SJFOM/KiCad/Projects/StepUp/pictures/Joystick_pinout.png

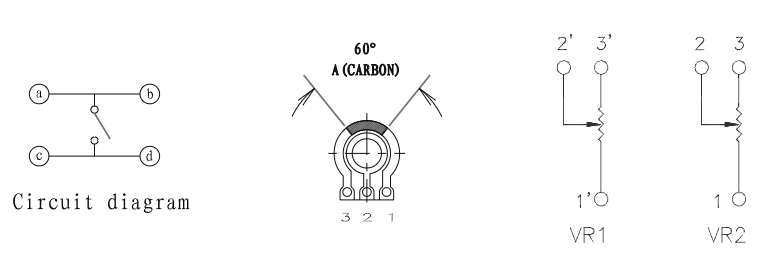
Projects/StepUp/pictures/Joystick_pinout.png
