SJFOM/KiCad/Projects/StepUp/pictures/pico_pinout.png

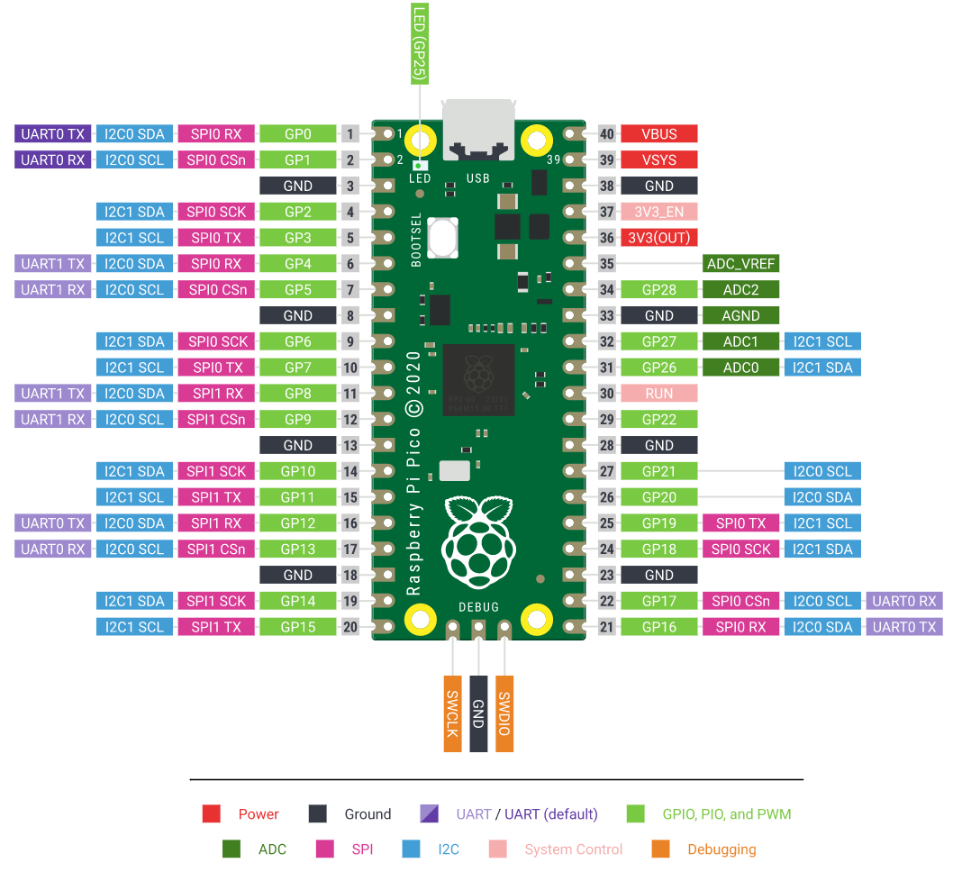
Projects/StepUp/pictures/pico_pinout.png
