SJFOM/KiCad/Projects/RP2040-example/RP2040_minimal_r2-BOM.xlsx

RP2040_minimal_r2 BOM
Item | Quantity | Reference | Part | Voltage | Current | Power | Material | Size | Tolerance | Manufacturer | Manuf. Part # | Description | Notes
1 | 3 | C1,C4,C17 | 10u | 16V |  |  | X5R | 0805_2012Metric | 10% | Murata | GRM21BR61C106KE15K | CAP CER 10UF 16V X5R 0805 | Or equivalent
2 | 2 | C2, C3 | 15p | 50V |  |  | C0G | 0402_1005Metric | 5% | Murata | GCM1555C1H150JA16D | CAP CER 15PF 50V C0G/NP0 0402 | Or equivalent
3 | 10 | C5, C6, C7, C9, C11, C12, C13, C14, C15, C16 | 100n | 25V |  |  | X7R | 0402_1005Metric | 10% | Murata | GRM155R71E104KE14J | CAP CER 0.1UF 25V X7R 0402 | Or equivalent
4 | 2 | C8, C10 | 1u | 10V |  |  | X6S | 0402_1005Metric | 10% | Murata | GRM155C81A105KA12D | CAP CER 1UF 10V X6S 0402 | Or equivalent
5 | 1 | J1 | USB_B_Micro |  |  |  |  |  |  | Amphenol | 10103594-0001LF | CONN RCPT USB2.0 MICRO B SMD R/A | Or equivalent
6 | 1 | J2 | 1x2 way header |  |  |  |  |  |  | Samtec | TSW-102-23-T-S | 2.54mm pin header 1x2 | Or equivalent
7 | 2 | J3, J4 | 2x18 way header |  |  |  |  |  |  | Samtec | TSW-118-23-T-D | 2.54mm pin header 2x18 | Or equivalent
8 | 2 | R1, R5 | 1k |  |  | 63mW |  | 0402_1005Metric | 1% | Yageo | RC0402FR-071KP | RES SMD 1K OHM 1% 1/16W 0402 | Or equivalent
9 | 1 | R2 | DNF |  |  |  |  | 0402_1005Metric |  |  |  |  | Do Not Fit
10 | 2 | R3, R4 | 27.4 |  |  | 63mW |  | 0402_1005Metric | 1% | Yageo | RC0402FR-0727R4L | RES SMD 27.4 OHM 1% 1/16W 0402 | Or equivalent
11 | 1 | U1 | NCP1117-3.3 |  |  |  |  | SOT-223-3 |  | ON Semiconductor | NCP1117ST33T3G | IC REG LINEAR 3.3V 1A SOT223
12 | 1 | U2 | W25Q128JVS |  |  |  |  | SOIC-8 |  | Winbond | W25Q128JVSIQ TR | IC FLASH 128M SPI 133MHZ 8SOIC
13 | 1 | U3 | RP2040 |  |  |  |  | QFN56 |  | Raspberry Pi | RP2040
14 | 1 | Y1 | ABM8-272-T3 |  |  |  |  | SMD_3225 |  | Abracon | ABM8-272-T3 | CRYSTAL 12.0000MHZ 3.2x2.5MM SMD
