SJFOM/KiCad/Projects/StepUp/StepUp_log_missing3Dmodels.txt

Can not find model defined with enviroment variable:
${KICAD8_3DMODEL_DIR}/Connector_USB.3dshapes/USB_C_Receptacle_GCT_USB4105-xx-A_16P_TopMnt_Horizontal.wrl
Can not find model defined with enviroment variable:
${KISYS3DMOD}/Package_DFN_QFN.3dshapes/QFN-56-1EP_7x7mm_P0.4mm_EP5.6x5.6mm.wrl
Can not find model defined with enviroment variable:
${KICAD8_3DMODEL_DIR}/Resistor_SMD.3dshapes/R_0603_1608Metric.wrl
Can not find model defined with enviroment variable:
${KICAD8_3DMODEL_DIR}/Resistor_SMD.3dshapes/R_0603_1608Metric.wrl
Can not find model defined with enviroment variable:
${KICAD8_3DMODEL_DIR}/Package_SON.3dshapes/WSON-6_1.5x1.5mm_P0.5mm.wrl
Can not find model defined with enviroment variable:
${KICAD8_3DMODEL_DIR}/Resistor_SMD.3dshapes/R_0603_1608Metric.wrl
Can not find model defined with enviroment variable:
${KICAD8_3DMODEL_DIR}/Resistor_SMD.3dshapes/R_0603_1608Metric.wrl
Can not find model defined with enviroment variable:
${KICAD8_3DMODEL_DIR}/Resistor_SMD.3dshapes/R_0603_1608Metric.wrl
Can not find model defined with enviroment variable:
${KICAD8_3DMODEL_DIR}/Resistor_SMD.3dshapes/R_0603_1608Metric.wrl
Can not find model defined with enviroment variable:
${KICAD8_3DMODEL_DIR}/Package_TO_SOT_SMD.3dshapes/SOT-223.wrl
Can not find model defined with enviroment variable:
${KICAD8_3DMODEL_DIR}/Diode_SMD.3dshapes/D_SOD-123F.wrl
Can not find model defined with enviroment variable:
${KICAD8_3DMODEL_DIR}/Resistor_SMD.3dshapes/R_0603_1608Metric.wrl
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
Can not find model defined with enviroment variable:
${KICAD8_3DMODEL_DIR}/Connector_PinHeader_2.54mm.3dshapes/PinHeader_1x05_P2.54mm_Vertical.wrl
Can not find model defined with enviroment variable:
${KICAD8_3DMODEL_DIR}/Connector_PinHeader_2.54mm.3dshapes/PinHeader_2x03_P2.54mm_Vertical.wrl
[('J1', '${KICAD8_3DMODEL_DIR}/Connector_USB.3dshapes/USB_C_Receptacle_GCT_USB4105-xx-A_16P_TopMnt_Horizontal.wrl'), ('U3', '${KISYS3DMOD}/Package_DFN_QFN.3dshapes/QFN-56-1EP_7x7mm_P0.4mm_EP5.6x5.6mm.wrl'), ('U7', 'C:\\Program Files\\KiCad\\9.0\\share\\kicad\\3dmodels\\Package_DFN_QFN.3dshapes\\Texa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
