SJFOM/KiCad/Projects/StepUp/Outputs/v1.0/Image renders/PCB_Render_BTM.png

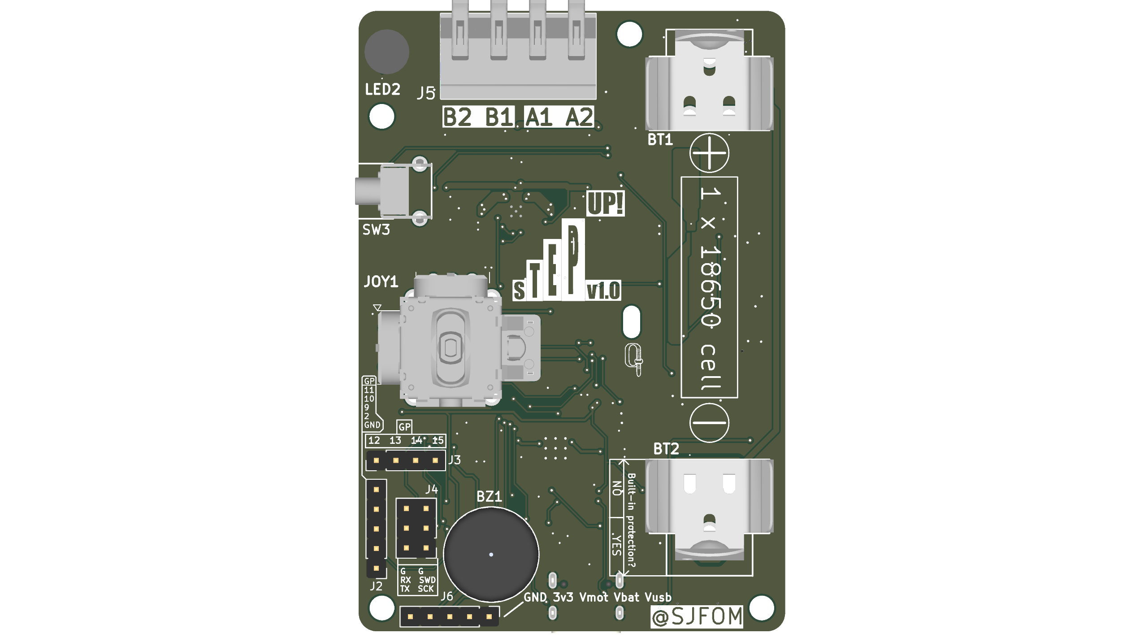
Projects/StepUp/Outputs/v1.0/Image renders/PCB_Render_BTM.png
