SJFOM/KiCad/Projects/StepUp/Outputs/v1.0/Image renders/PCB_Render_TOP.png

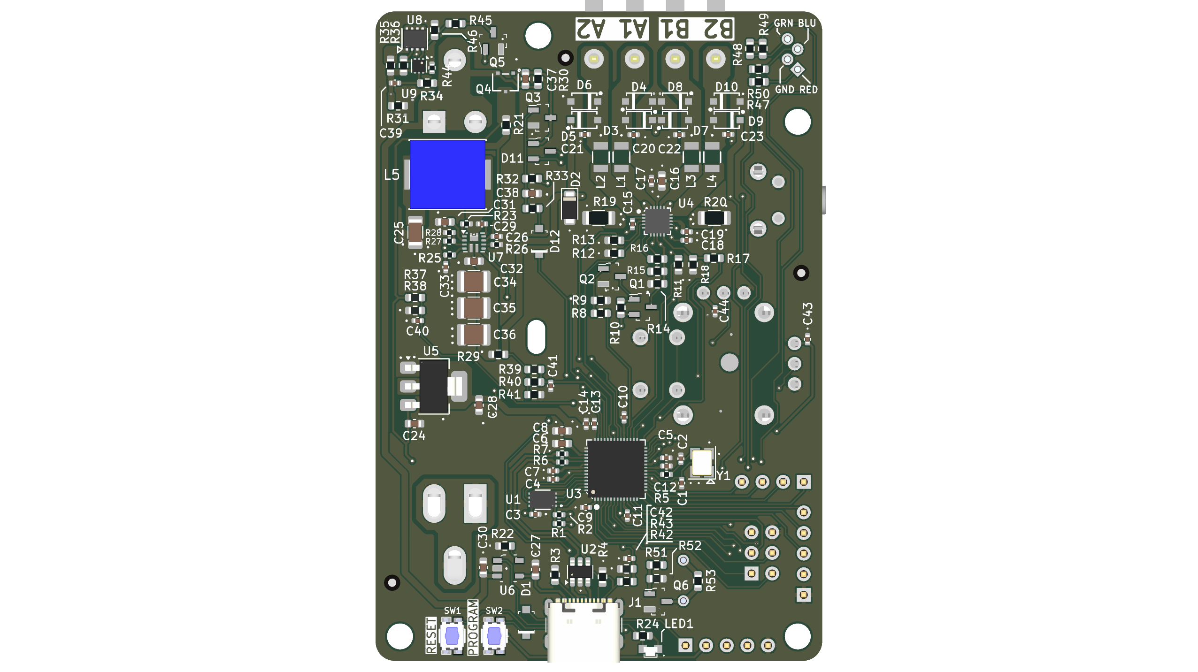
Projects/StepUp/Outputs/v1.0/Image renders/PCB_Render_TOP.png
