SJFOM/KiCad/Projects/StepUp/pictures/MCP73832_charge_ic_current.png

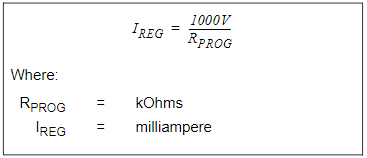
Projects/StepUp/pictures/MCP73832_charge_ic_current.png
