SJFOM/KiCad/Projects/StepUp/pictures/MIC2253_Vout_calc.png

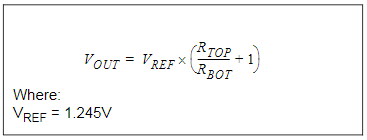
Projects/StepUp/pictures/MIC2253_Vout_calc.png
