SJFOM/KiCad/Projects/StepUp/pictures/MIC2253_Vovp_calc.png

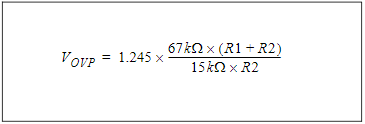
Projects/StepUp/pictures/MIC2253_Vovp_calc.png
