SJFOM/KiCad/Projects/StepUp/pictures/zip_tie_image.png

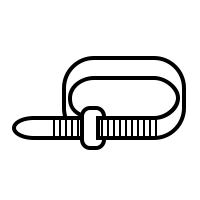
Projects/StepUp/pictures/zip_tie_image.png
