SJFOM/KiCad/Projects/StepUp/Schematic pdfs/StepUp_v1.0.pdf

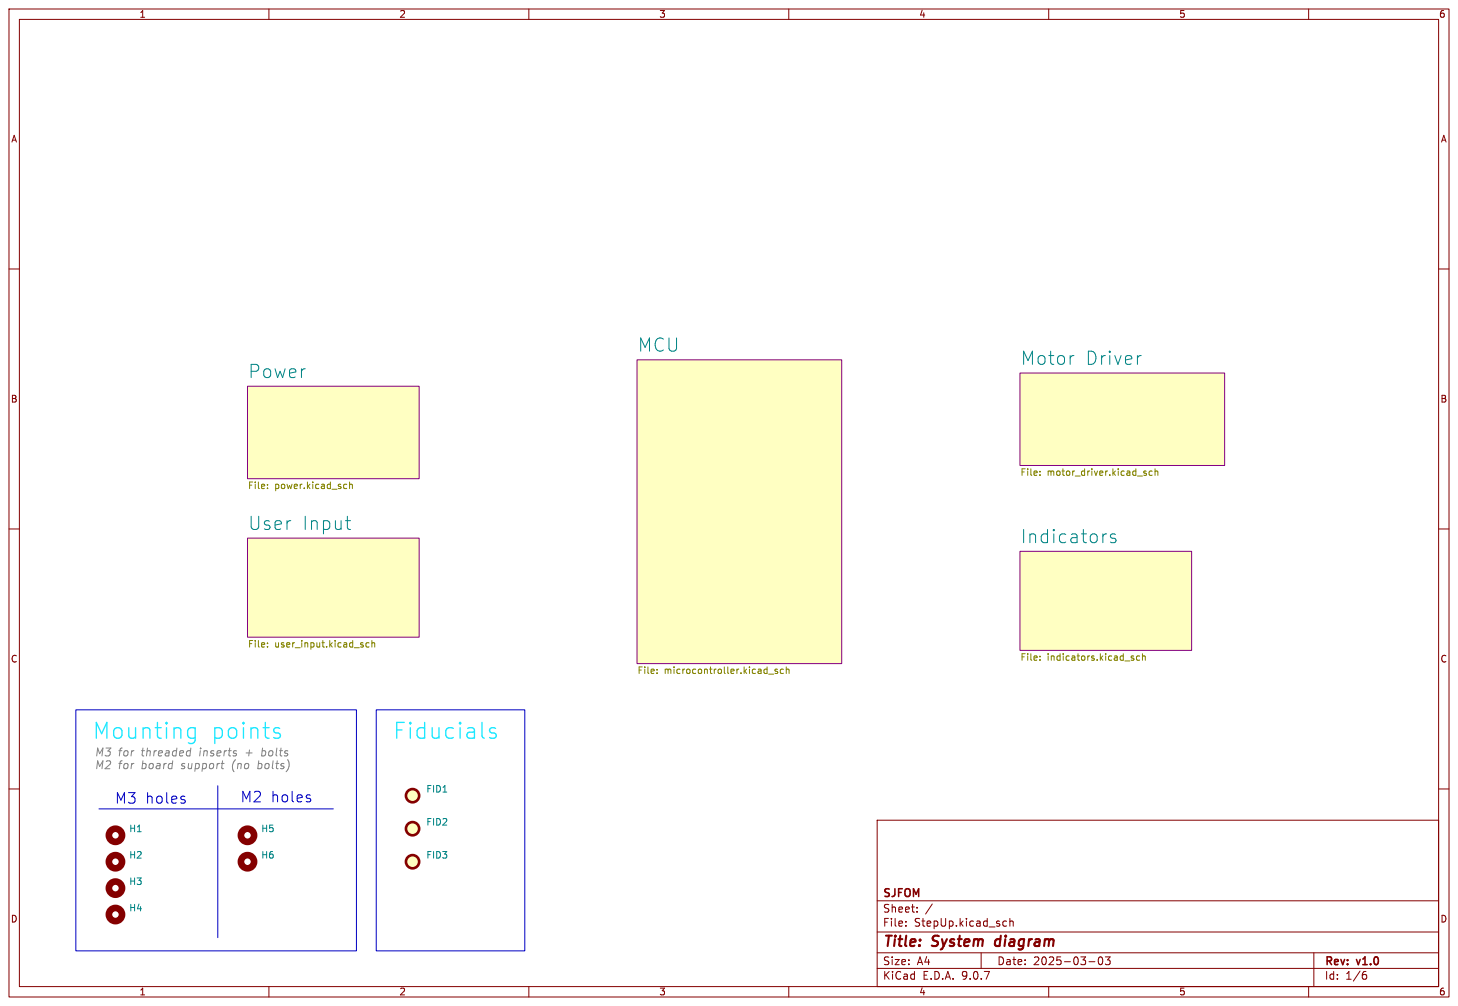
[picture p9: page 1]

File: StepUp.kicad_sch Sheet: / SJFOM Power

M3 for threaded inserts + bolts M2 for board support (no bolts)

Id: 1/6 Title: System diagram

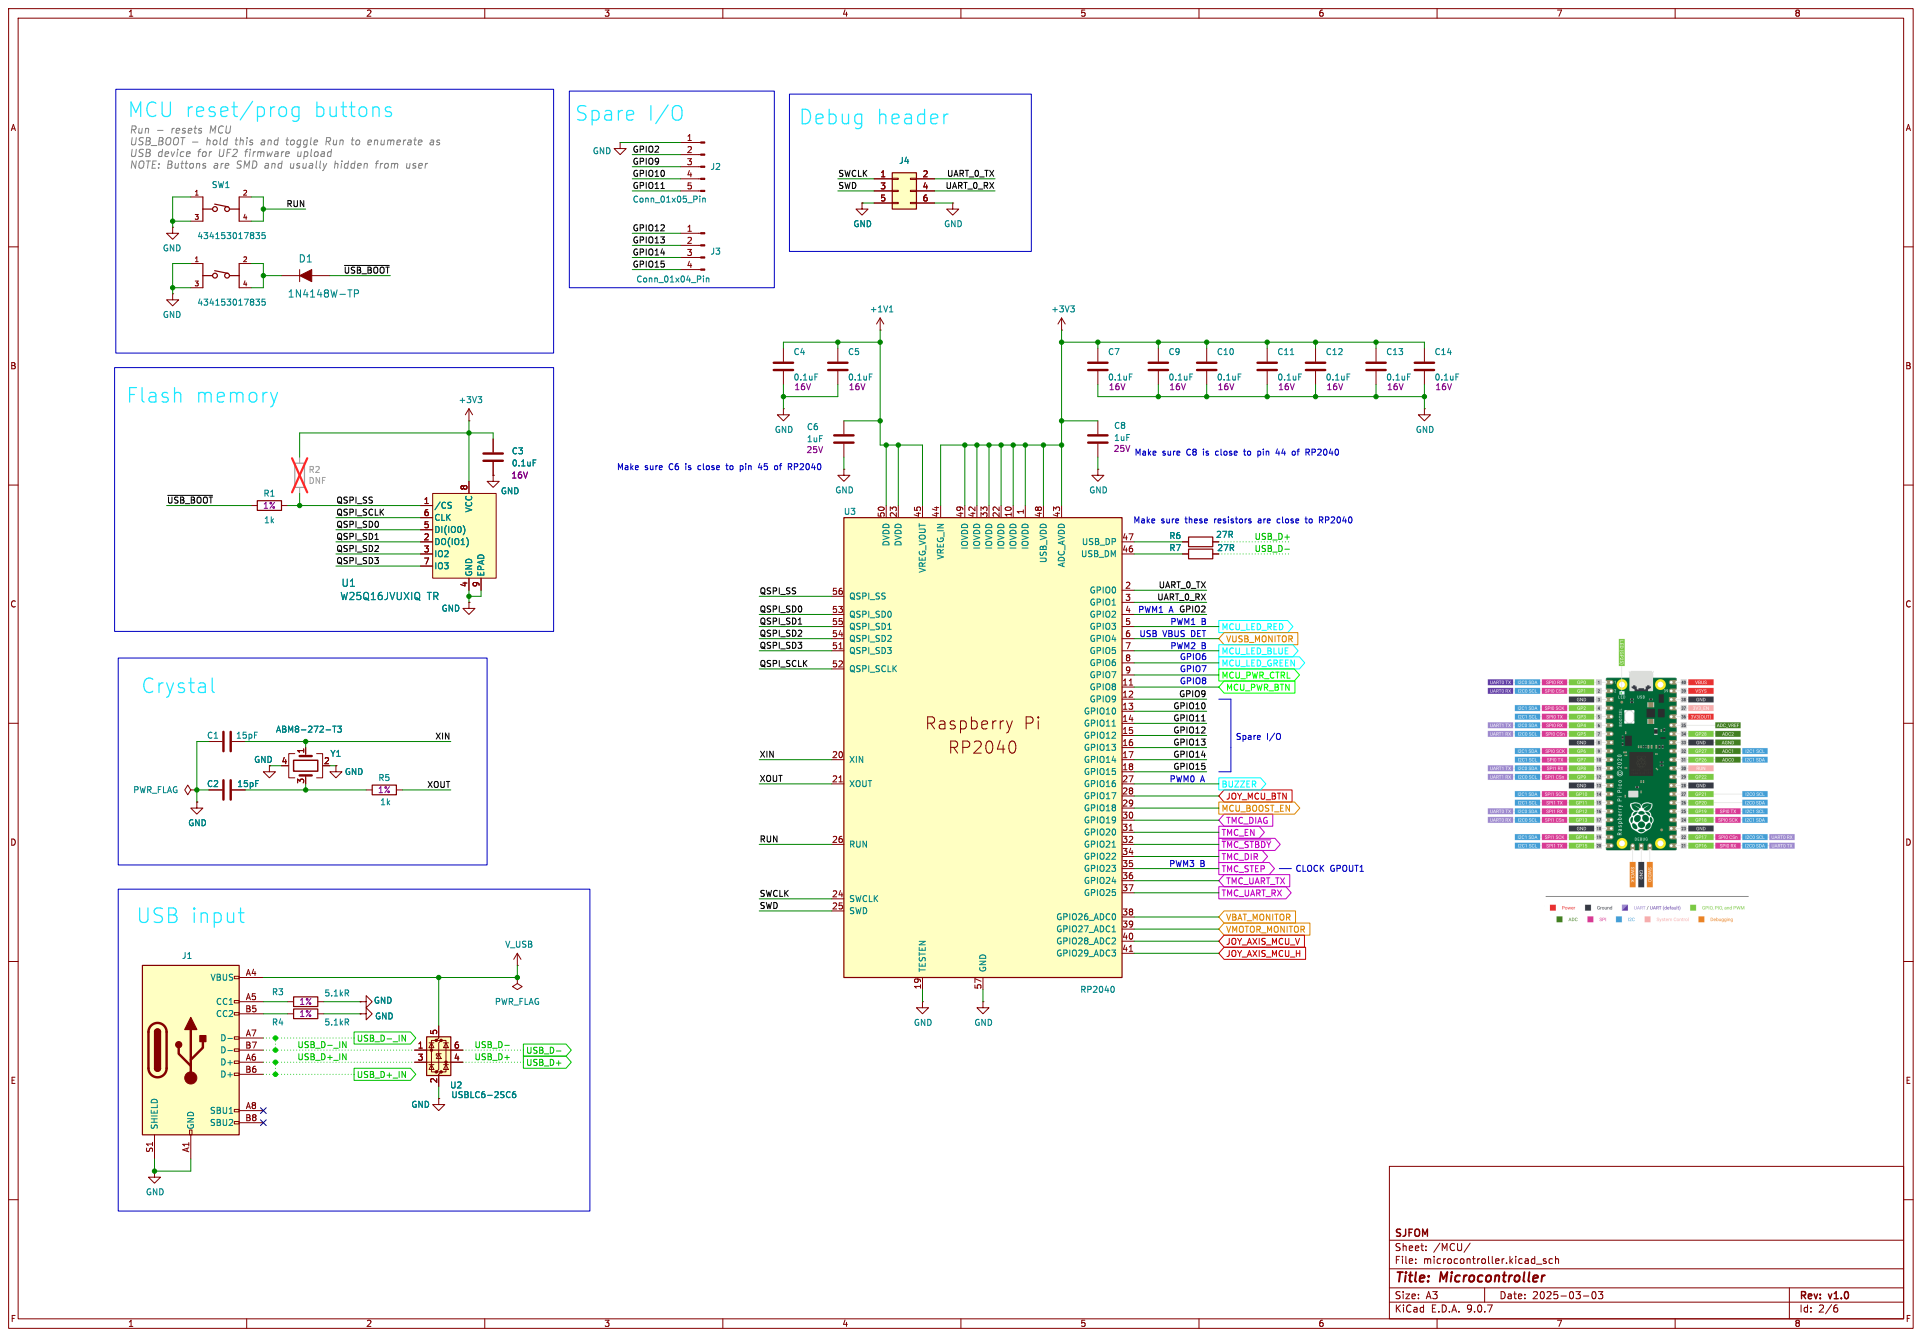
[picture p10: page 2]

USB VBUS DET GPIO6 Debug header

Make sure C8 is close to pin 44 of RP2040 Run - resets MCU

Id: 2/6 Title: Microcontroller File: microcontroller.kicad_sch Sheet: /MCU/ SJFOM

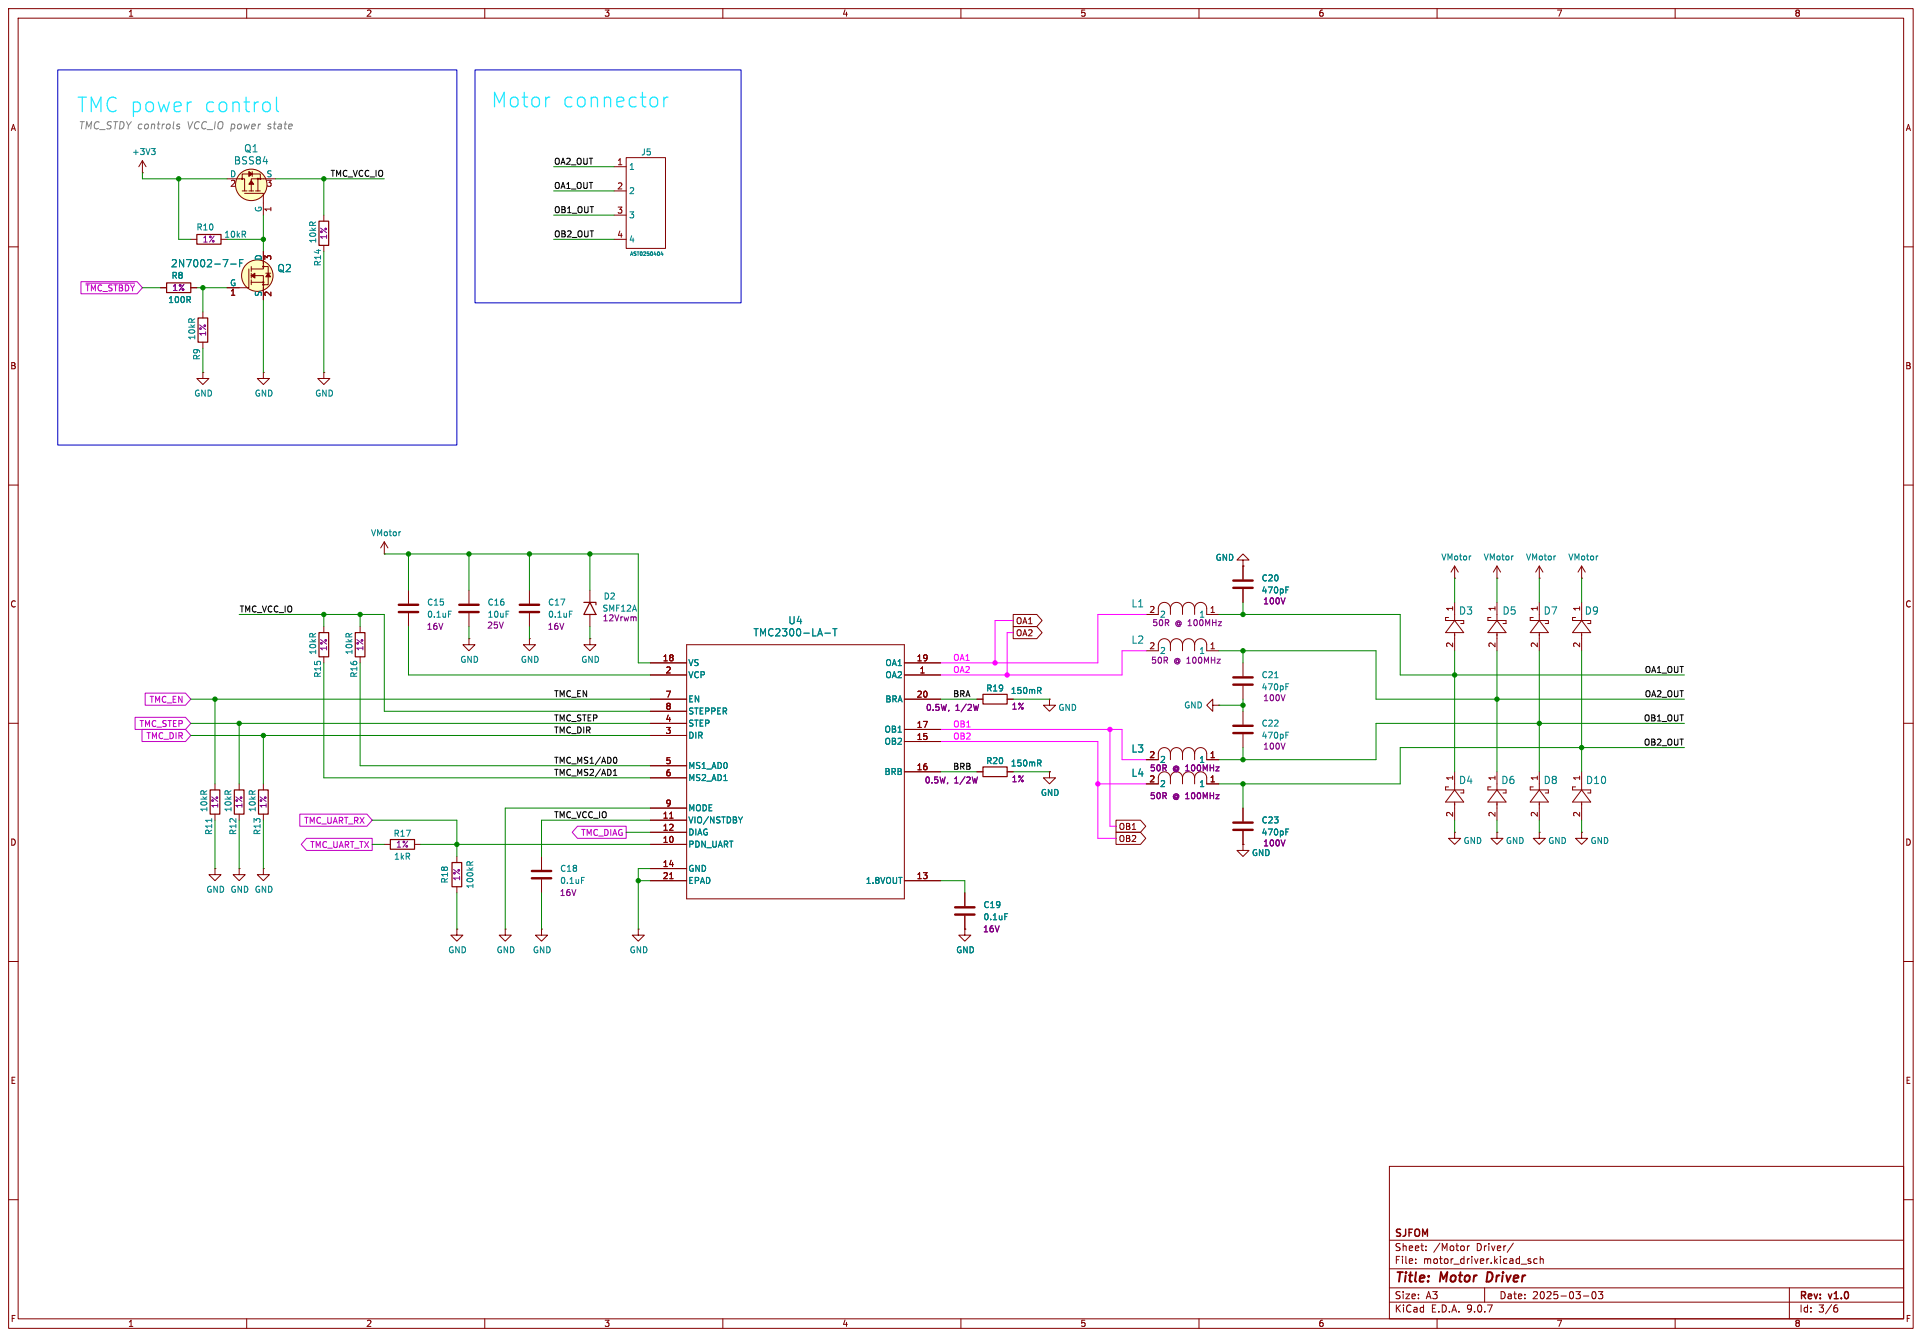
[picture p11: page 3]

2 1D8 GND GND GND GND GND

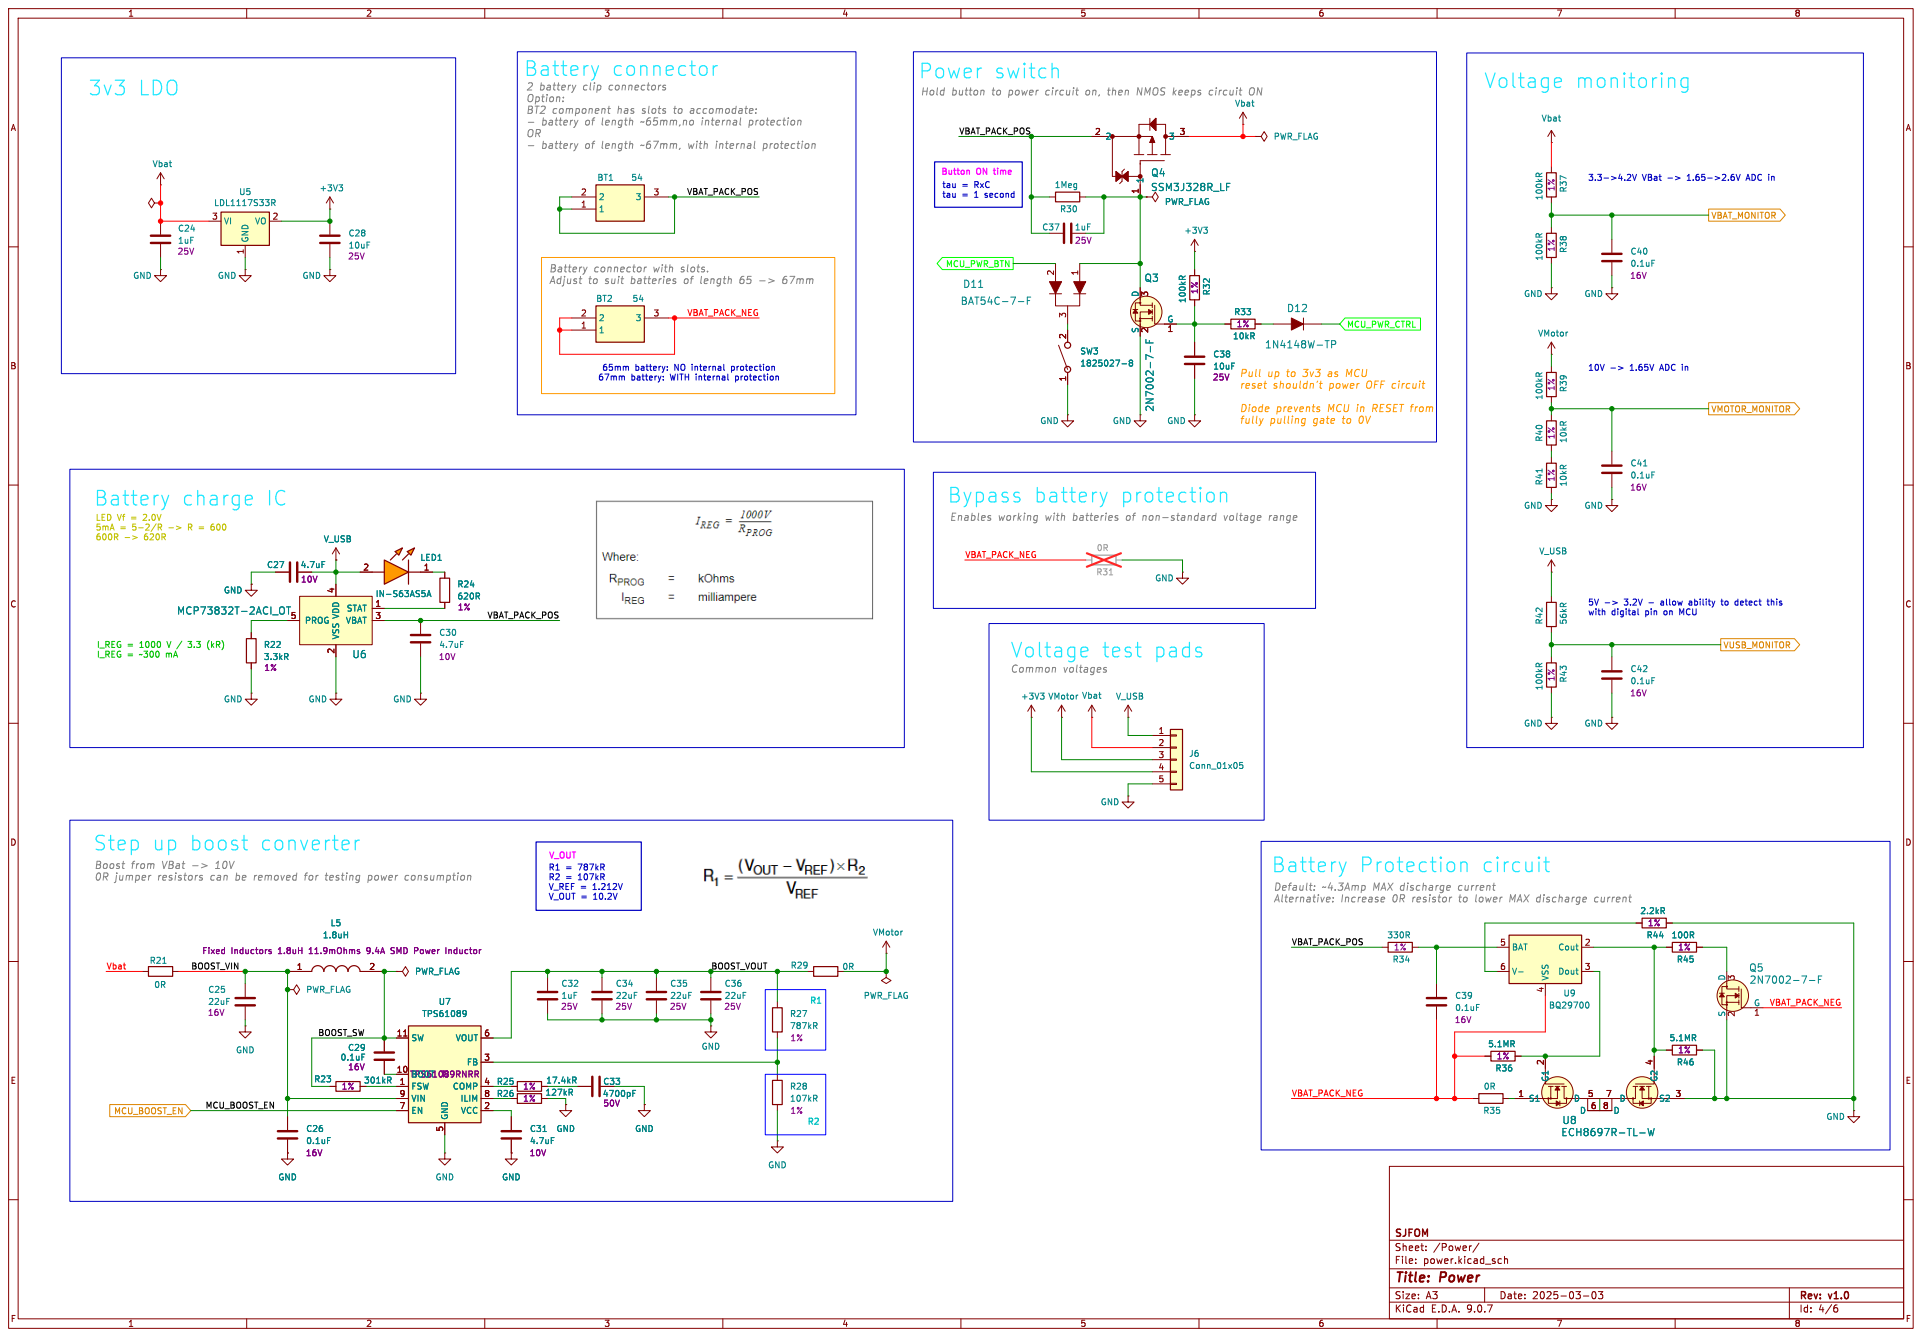
[picture p12: page 4]

Button ON time Battery connector
tau = 1 second Battery charge IC

fully pulling gate to 0V

Id: 4/6 Title: Power File: power.kicad_sch Sheet: /Power/ SJFOM

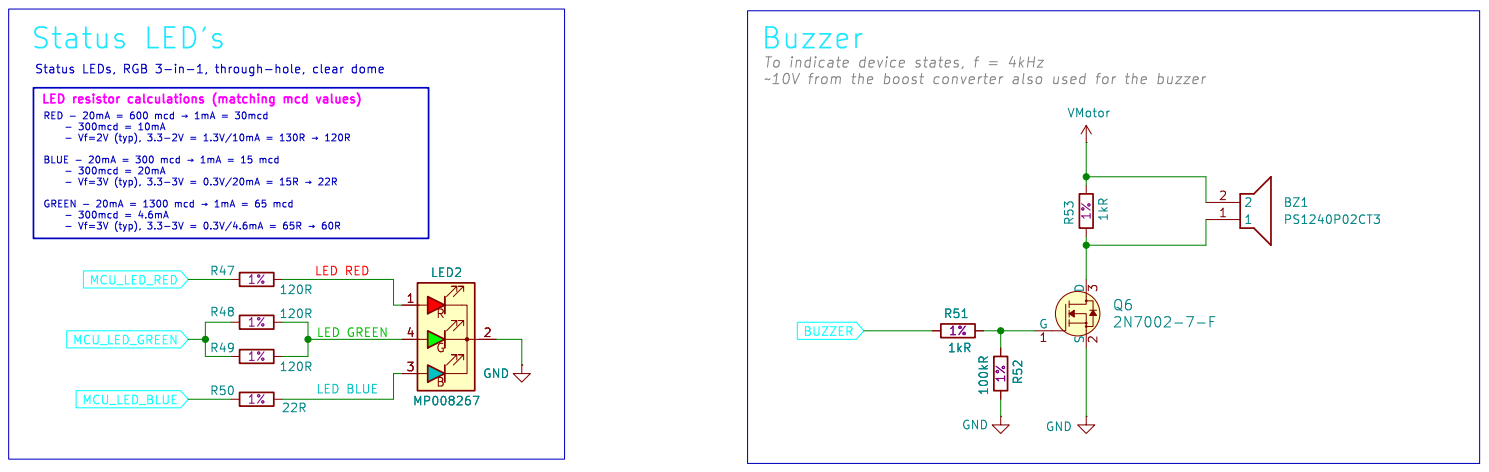
[picture p13: page 5]

BLUE - 20mA = 300 mcd þÿ!’1mA = 15 mcd
- 300mcd = 20mA

Id: 5/6 Title: User Input File: indicators.kicad_sch Sheet: /Indicators/ SJFOM

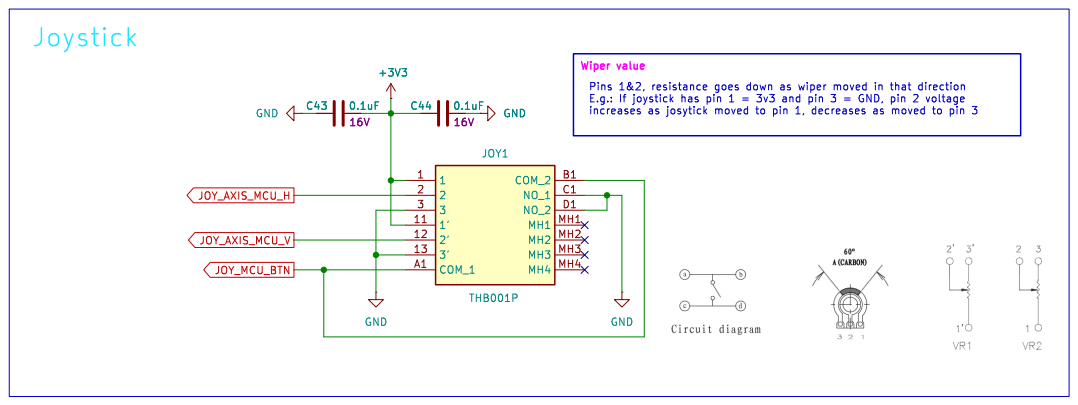
[picture p14: page 6]
