SJFOM/KiCad/Projects/StepUp/Schematic pdfs/StepUp_v0.3.pdf

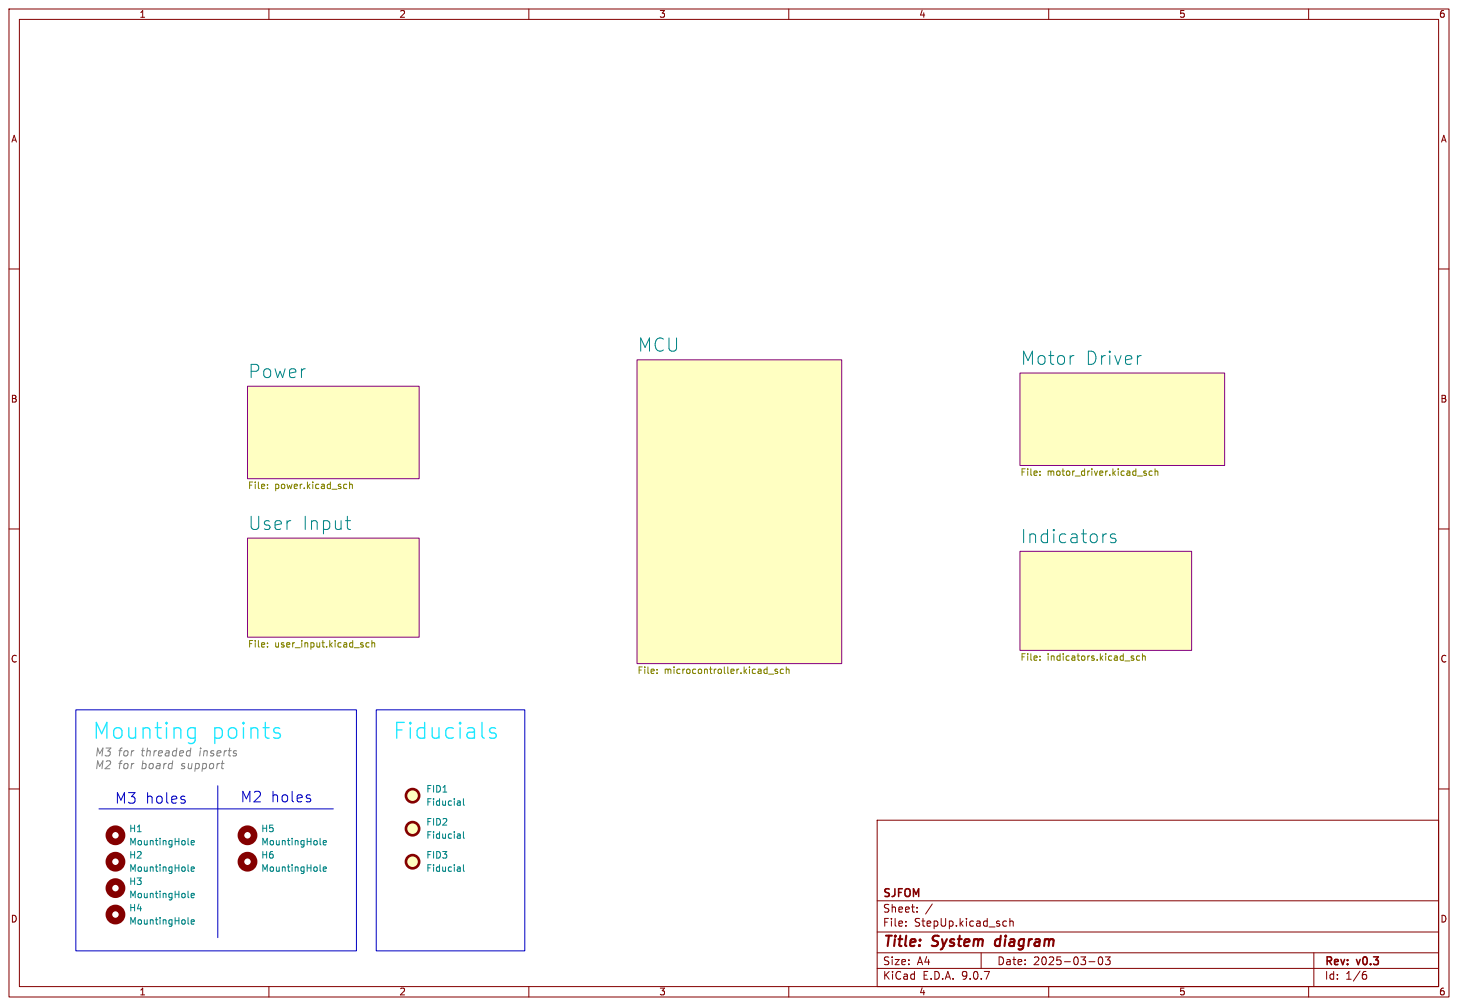
[picture p15: page 1]

File: StepUp.kicad_sch Sheet: / SJFOM Power

File: indicators.kicad_sch FID2 Fiducial FID3 Fiducial FID1 Fiducial H6 MountingHole H5 MountingHole H4 MountingHole H3 MountingHole H2 MountingHole H1 MountingHole

M3 for threaded inserts M2 for board support

Id: 1/6 Title: System diagram

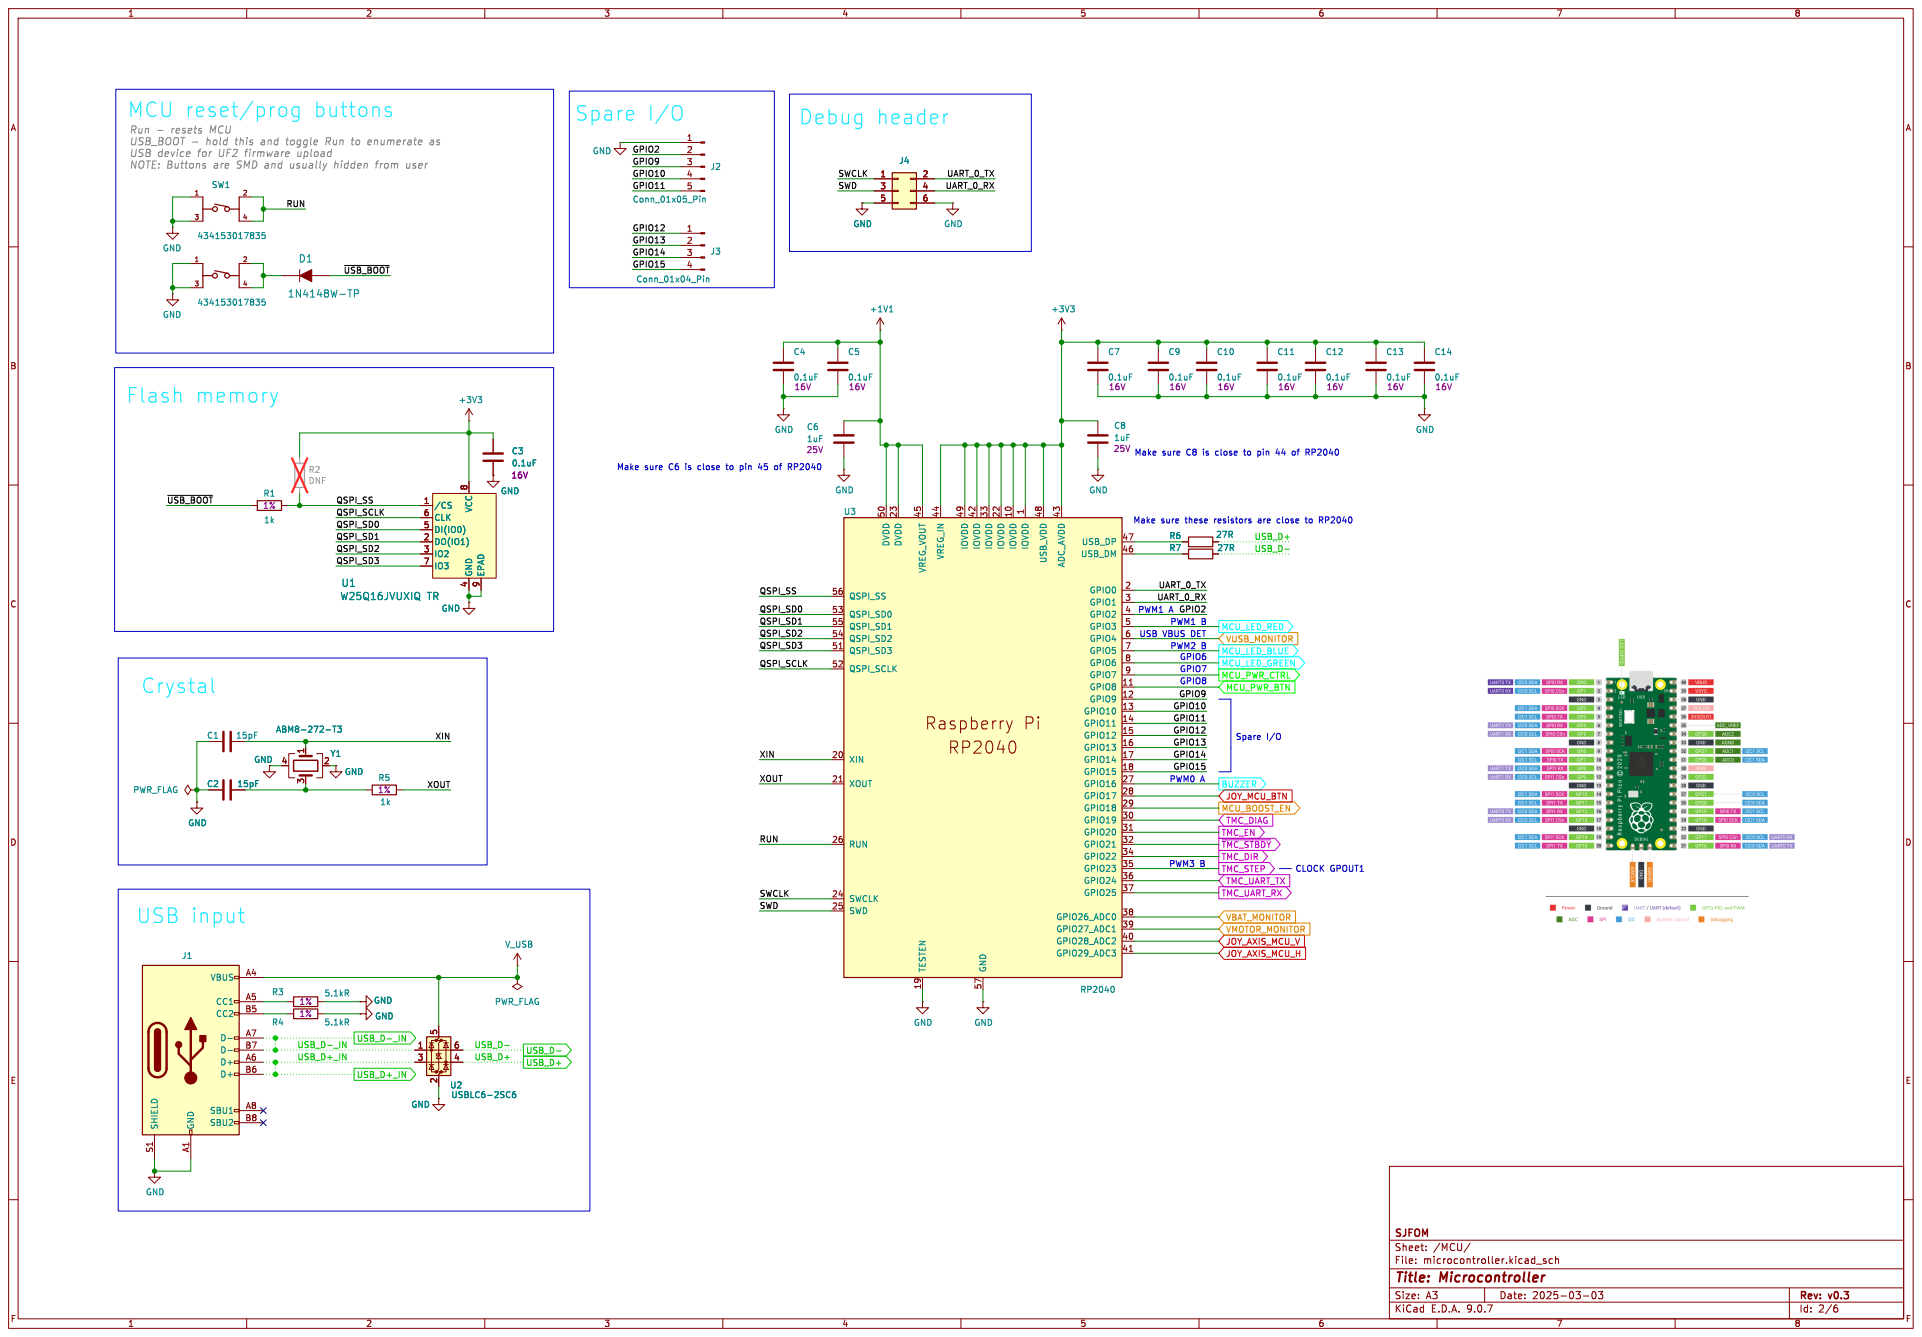
[picture p16: page 2]

Spare I/O Make sure C8 is close to pin 44 of RP2040 GPIO7 PWM2 B Spare I/O

USB VBUS DET GPIO6 Debug header

3 GND GND GND GND

Id: 2/6 Title: Microcontroller File: microcontroller.kicad_sch Sheet: /MCU/ SJFOM

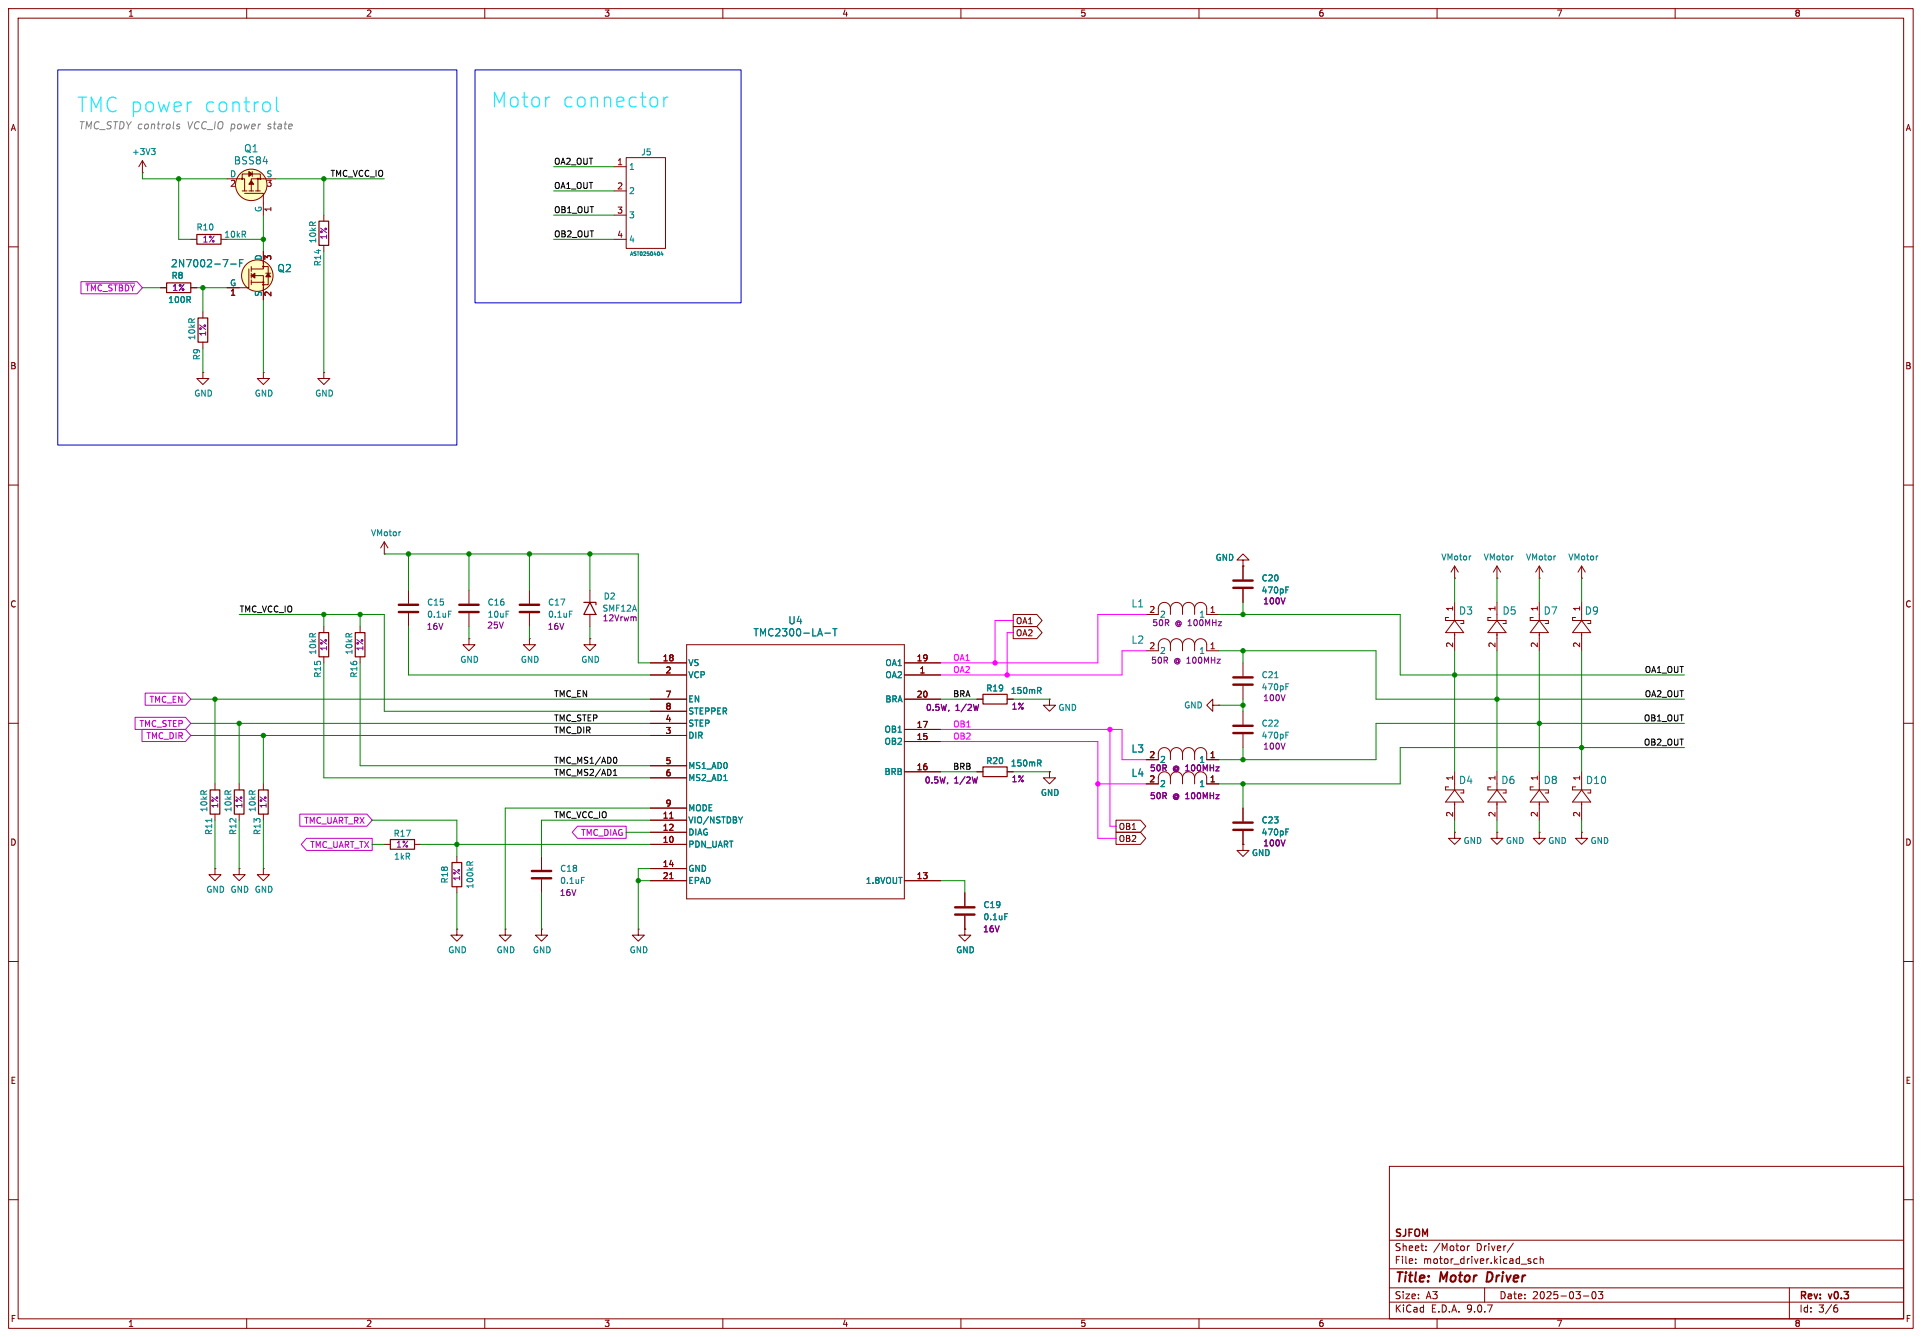
[picture p17: page 3]

2 1D8 GND GND GND GND

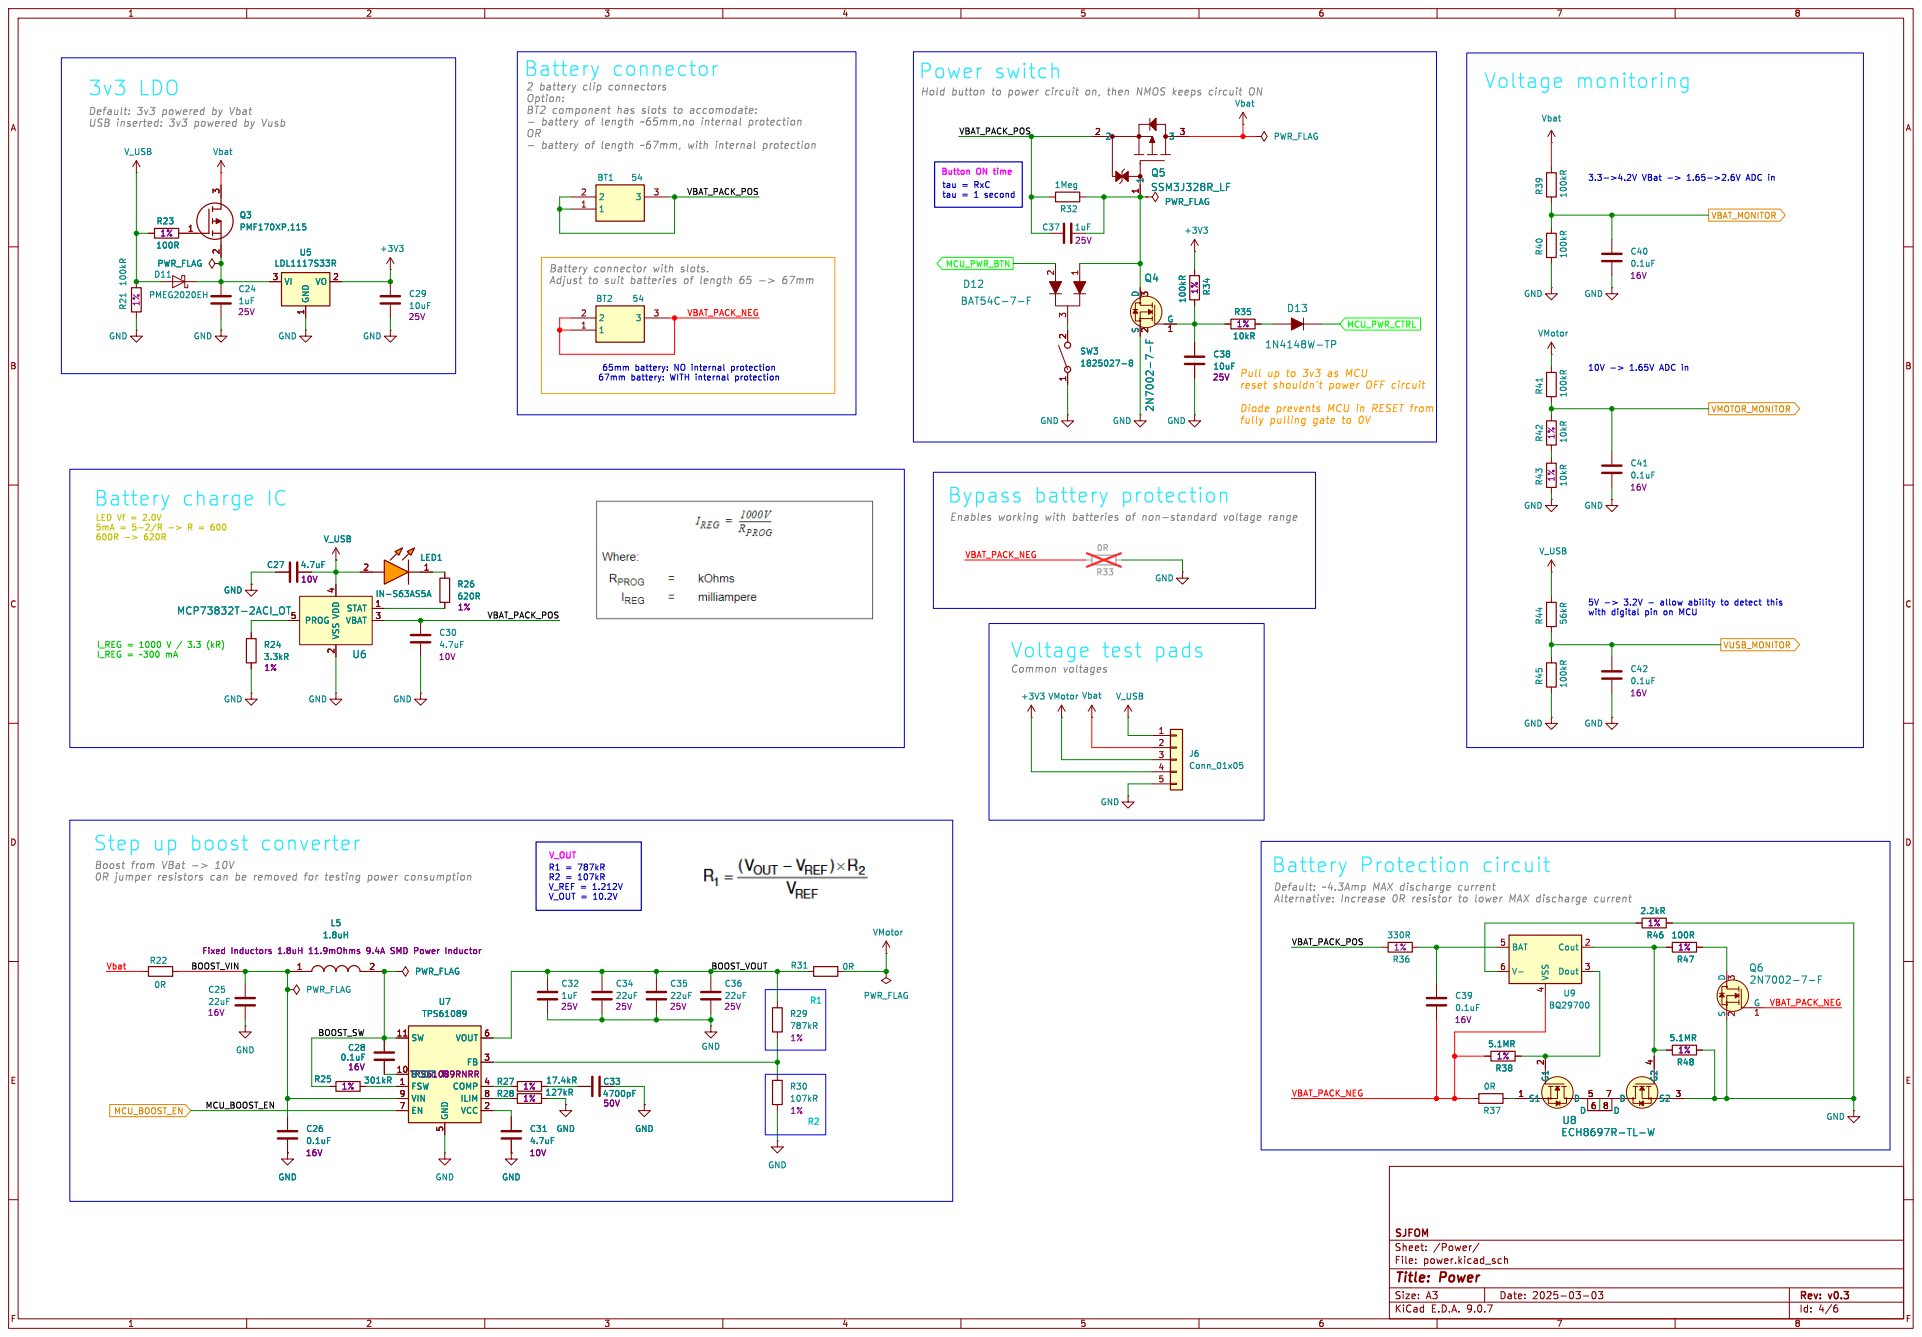
[picture p18: page 4]

- battery of length ~67mm, with internal protection Battery connector

Hold button to power circuit on, then NMOS keeps circuit ON

VBAT_PACK_POS
Button ON timeVoltage test pads
tau = RxC
tau = 1 second

fully pulling gate to 0V

Common voltages Battery charge IC

V_OUT Step up boost converter

Id: 4/6 Title: Power File: power.kicad_sch Sheet: /Power/ SJFOM

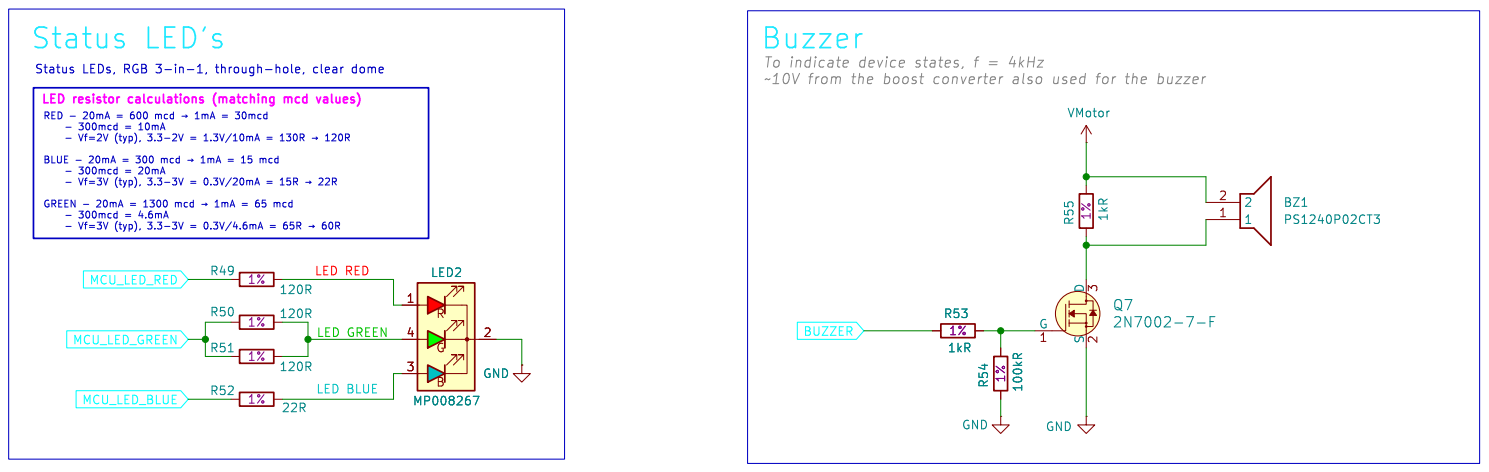
[picture p19: page 5]

BLUE - 20mA = 300 mcd þÿ!’1mA = 15 mcd
- 300mcd = 20mA

Id: 5/6 Title: User Input File: indicators.kicad_sch Sheet: /Indicators/ SJFOM
