SJFOM/KiCad/Projects/StepUp/Schematic pdfs/StepUp_v0.1.pdf

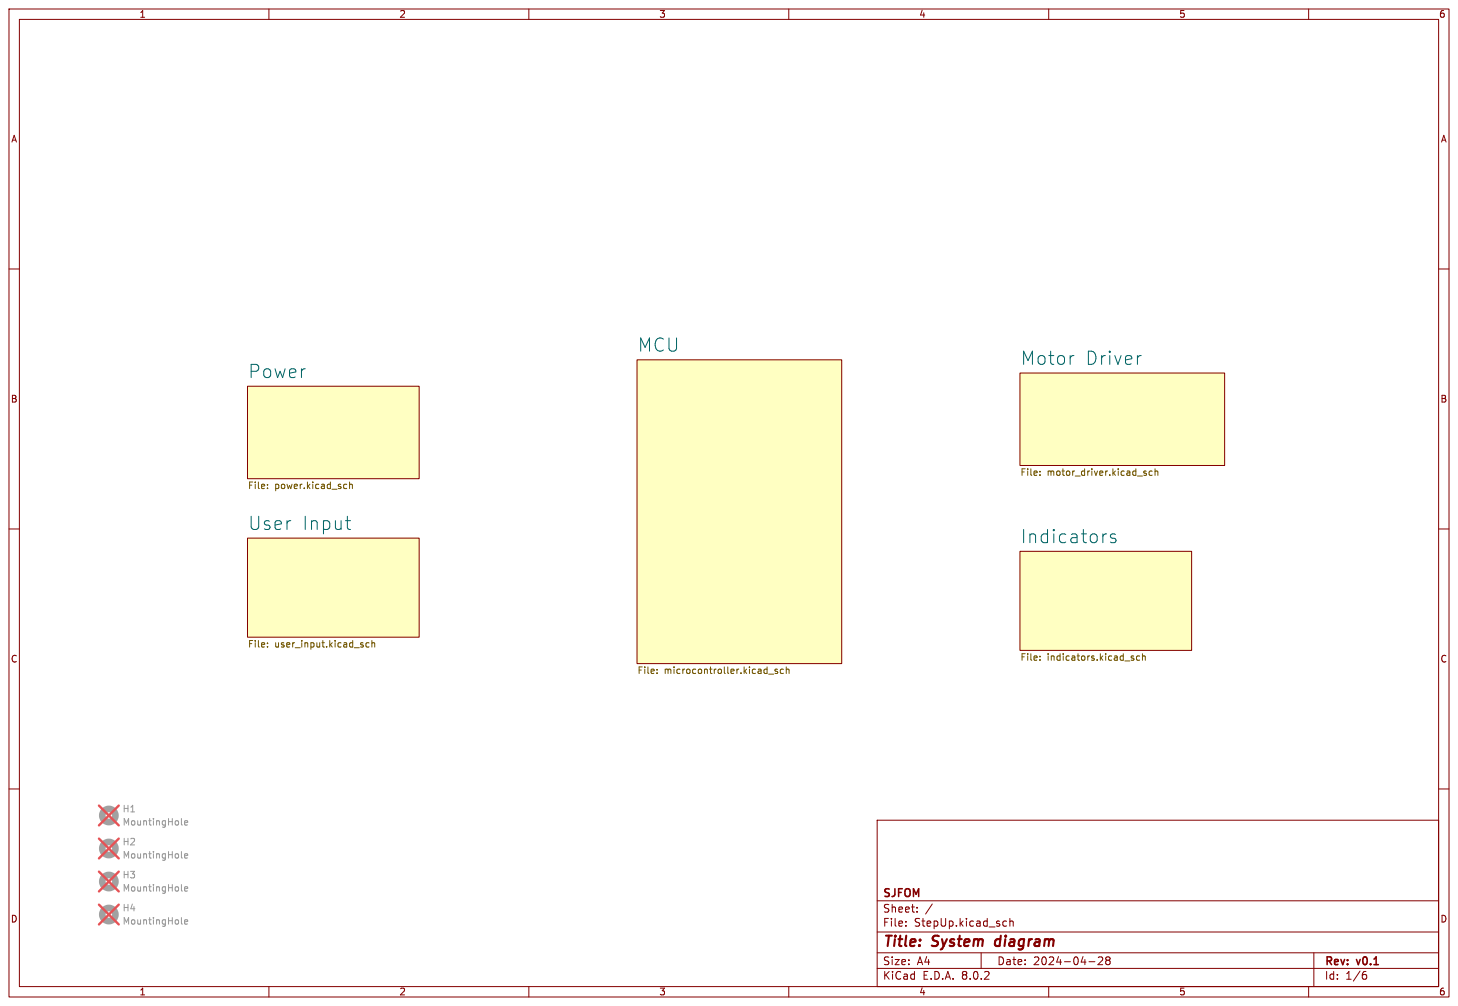
[picture p26: page 1]

File: motor_driver.kicad_sch H4 MountingHole H1 MountingHole H3 MountingHole H2 MountingHole

Id: 1/6 Title: System diagram

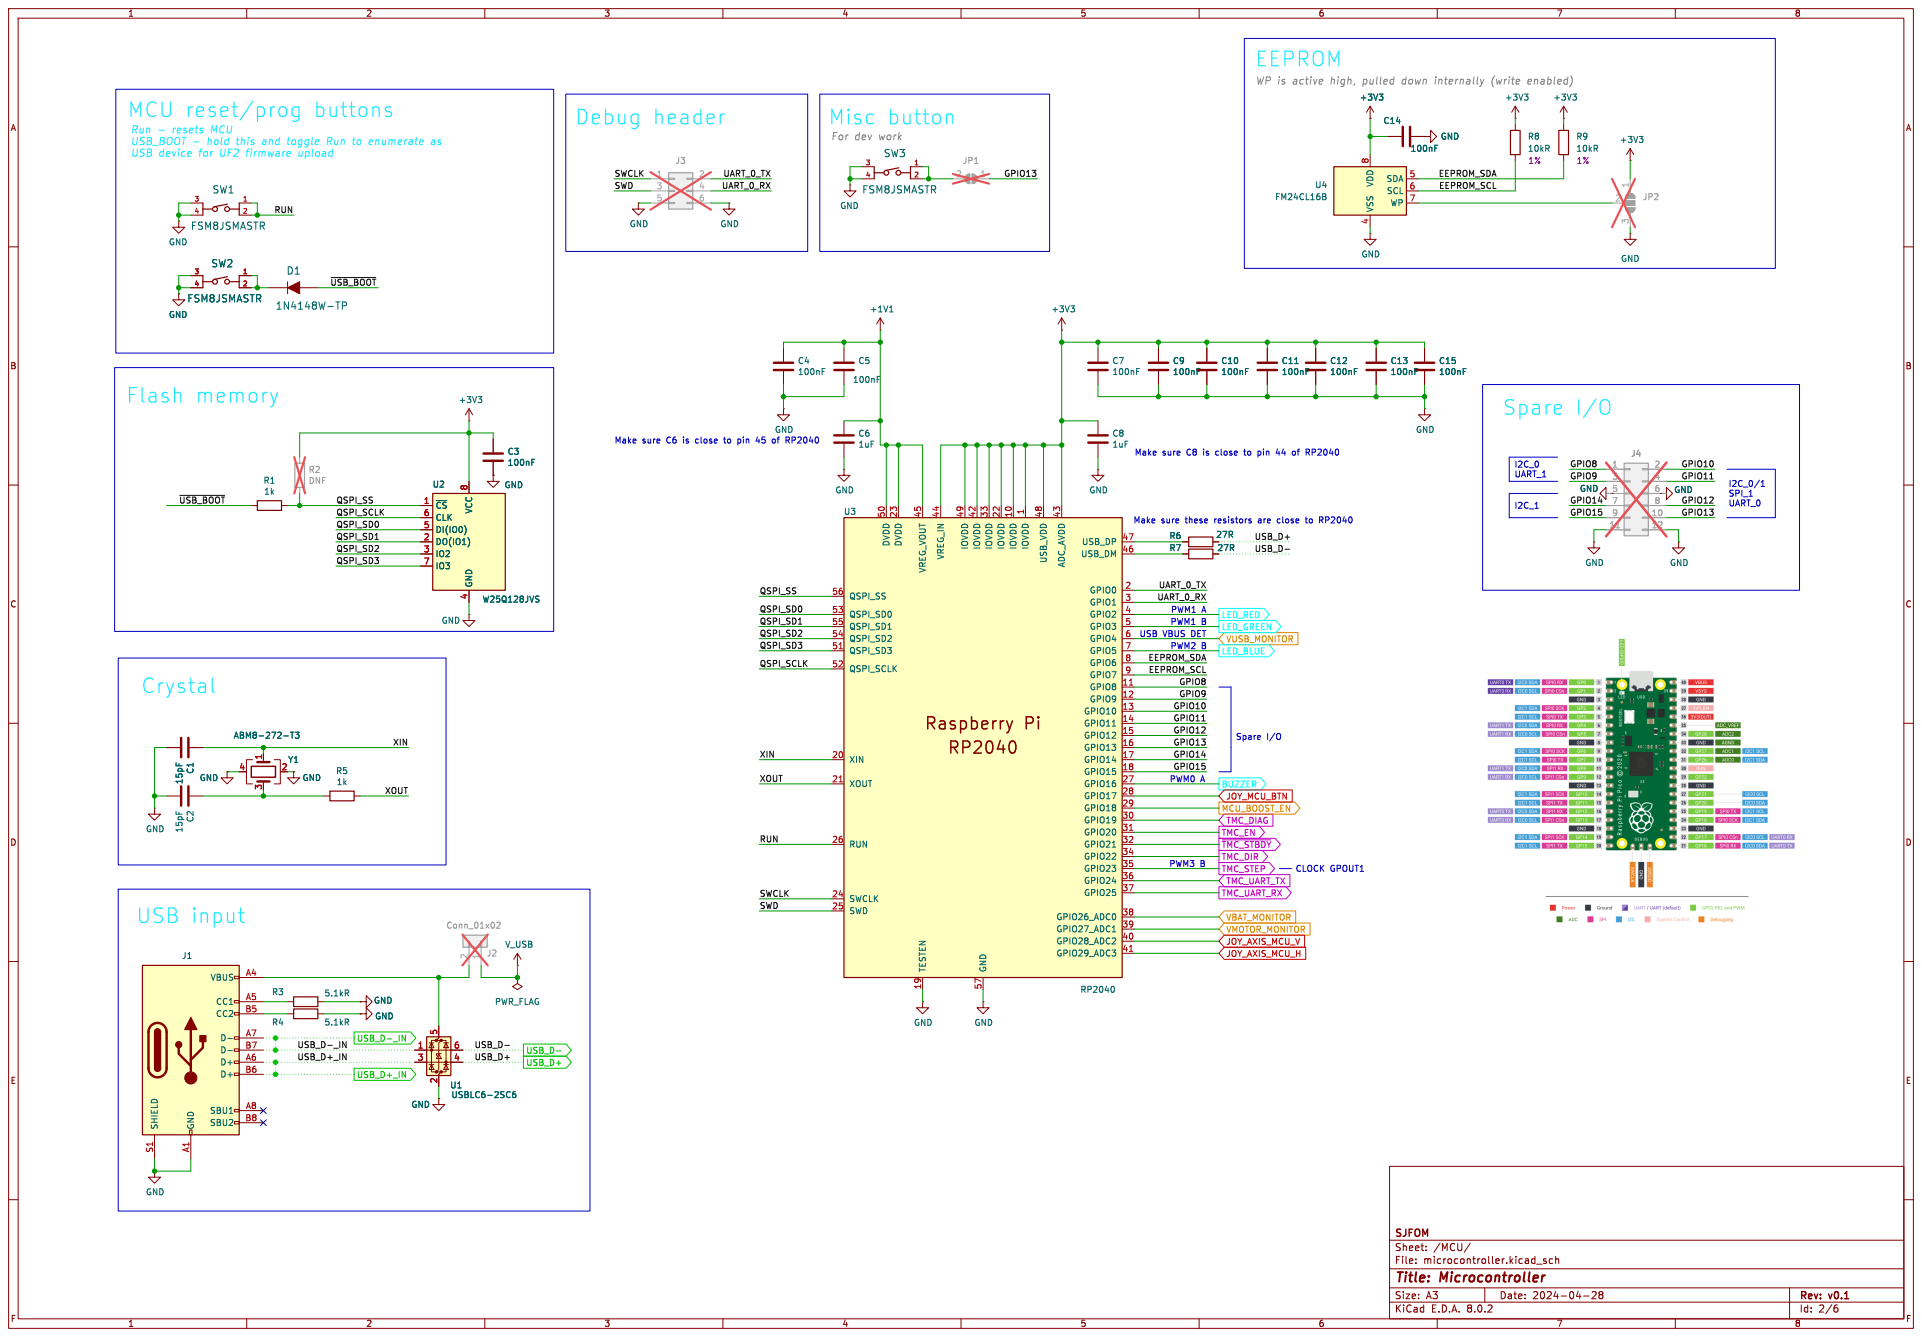
[picture p27: page 2]

Make sure C6 is close to pin 45 of RP2040 Debug header

4 SDA 5 SCL 6 WP 7 VDD

1 IOVDD 10 GPIO8 11 GPIO9 12 GPIO10 13 GPIO11 14 GPIO12 15 GPIO13 16 GPIO14 17 GPIO15 18 TESTEN 19 GPIO0 2 XIN 20 XOUT 21 IOVDD 22 DVDD 23 SWCLK 24 SWD 25 RUN 26 GPIO16 27 GPIO17 28 GPIO18 29 GPIO1 3 GPIO19 30 GPIO20 31 GPIO21 32 IOVDD 33 GPIO22 34 GPIO23 35 GPIO24 36 GPIO25 37 GPIO26_ADC0 38 GPIO27_ADC1 39 GPIO2 4 GPIO28_ADC2 40 GPIO29_ADC3 41 IOVDD 42 ADC_AVDD 43 VREG_IN 44 VREG_VOUT 45 USB_DM 46 USB_DP 47 USB_VDD 48 IOVDD 49 GPIO3 5 DVDD 50 QSPI_SD3 51 QSPI_SCLK 52 QSPI_SD0 53 QSPI_SD2 54 QSPI_SD1 55 QSPI_SS 56 GND 57 GPIO4 6 GPIO5 7 GPIO6 8 GPIO7 9 U3 RP2040

Id: 2/6 Title: Microcontroller File: microcontroller.kicad_sch Sheet: /MCU/ SJFOM

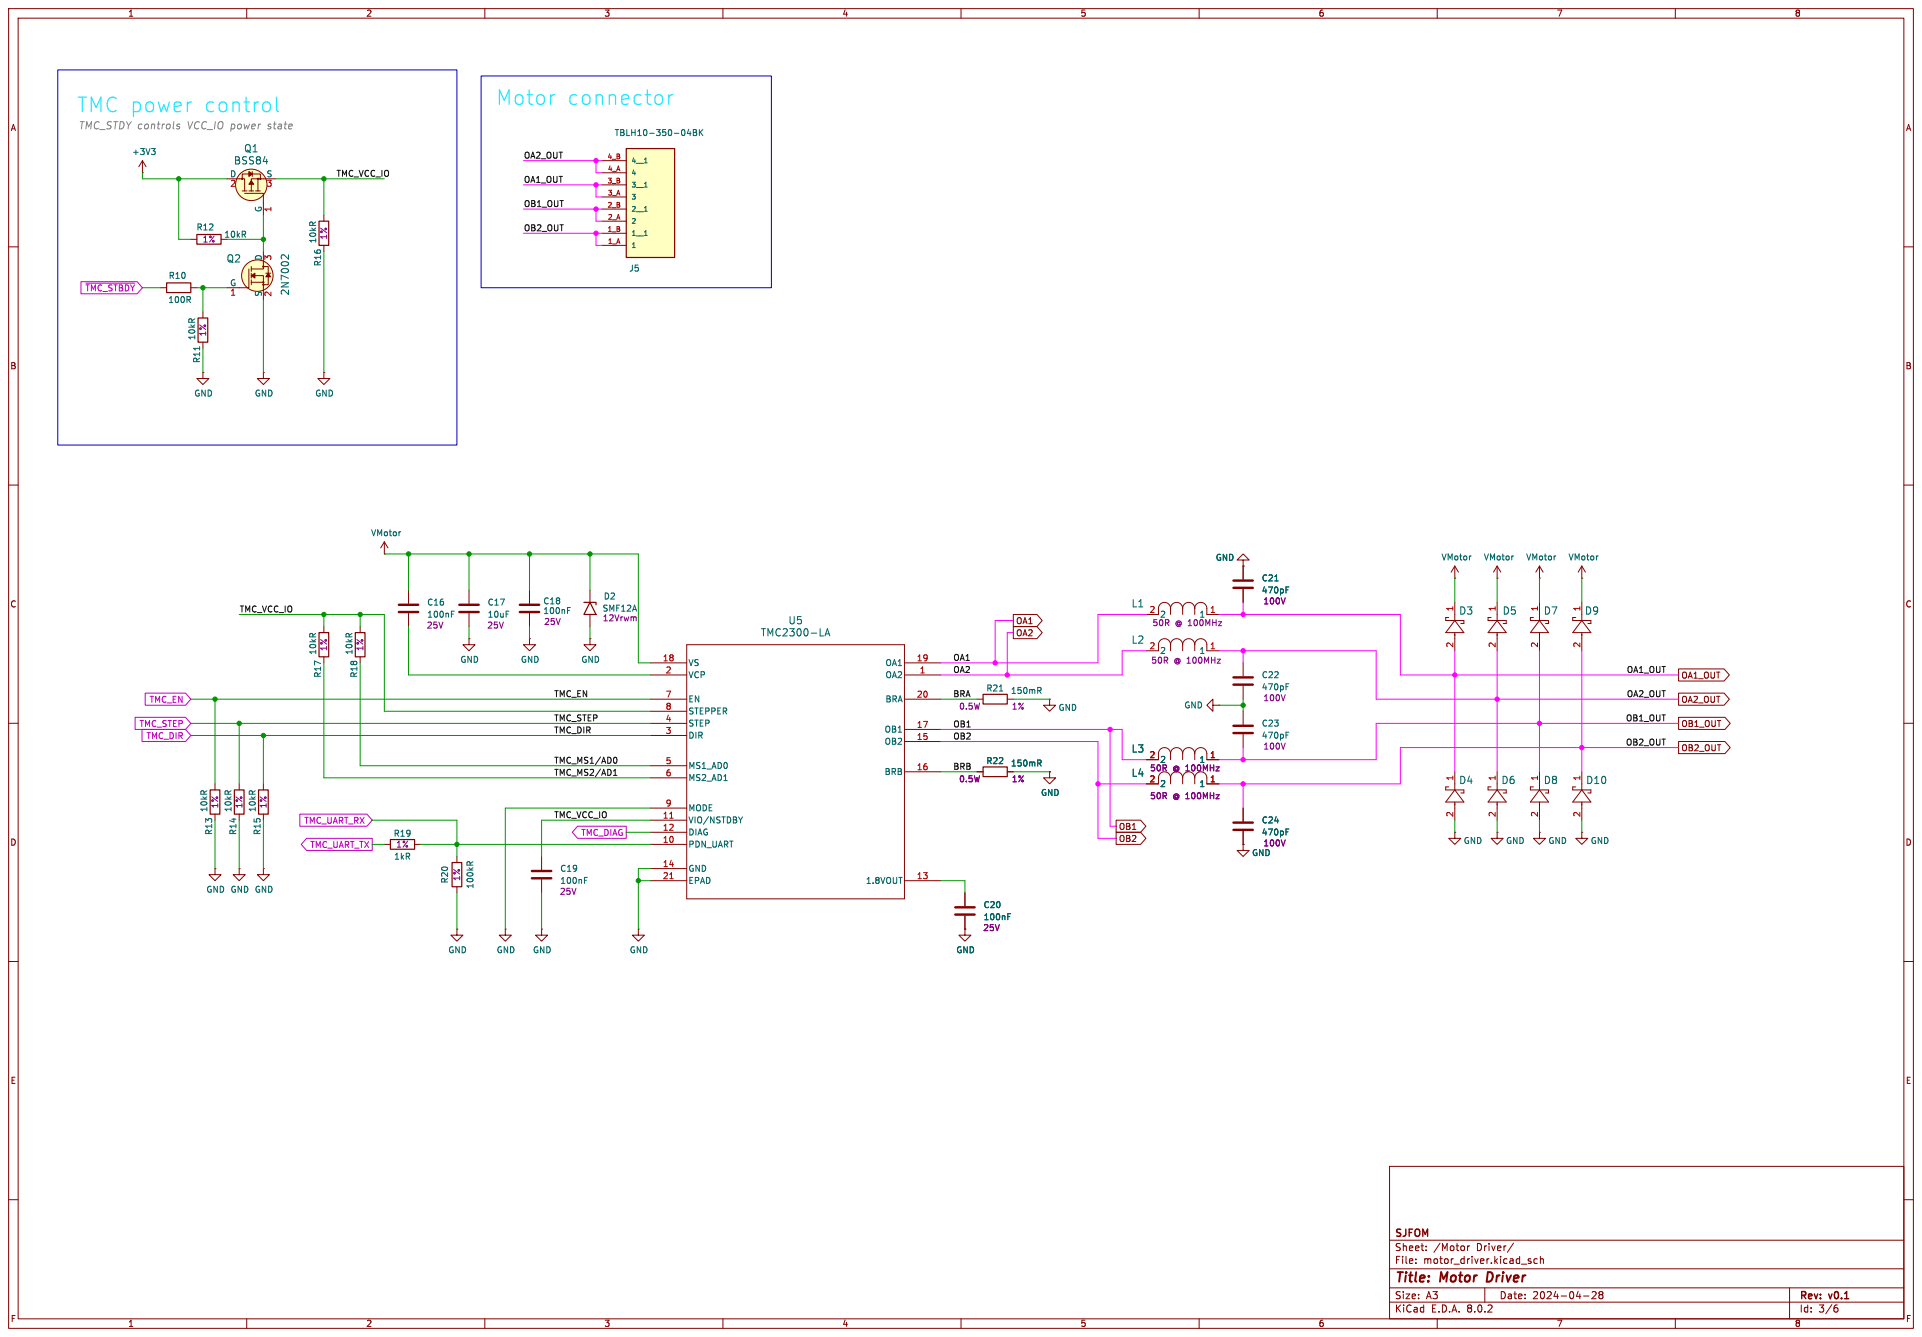
[picture p28: page 3]

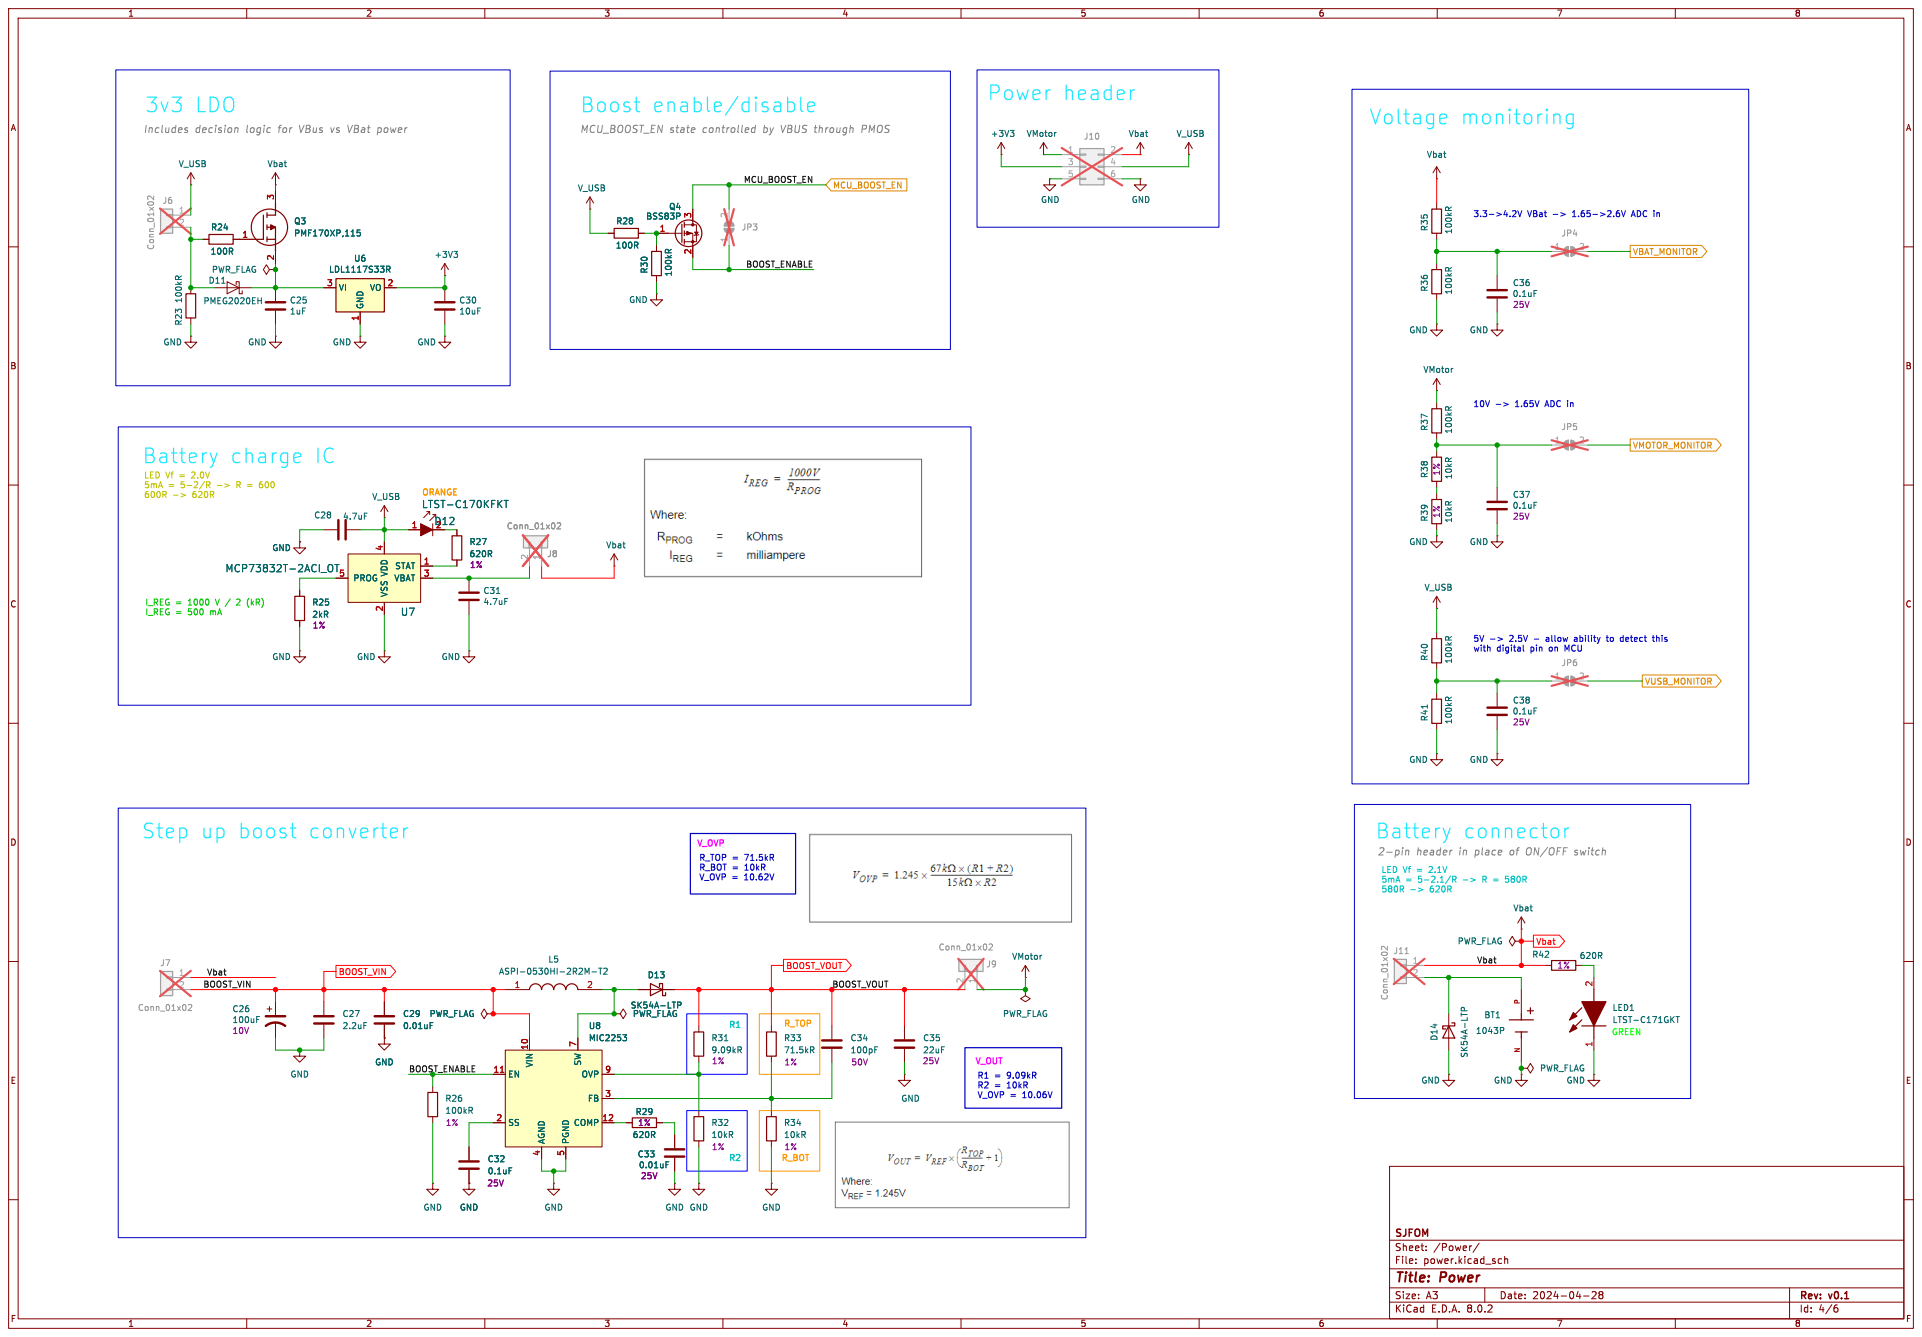
[picture p29: page 4]

Includes decision logic for VBus vs VBat power

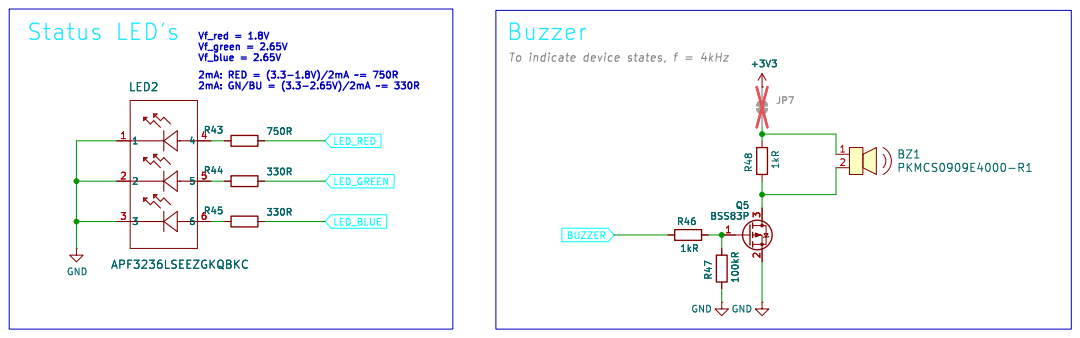
[picture p30: page 5]

Id: 5/6 Title: User Input File: indicators.kicad_sch Sheet: /Indicators/ SJFOM

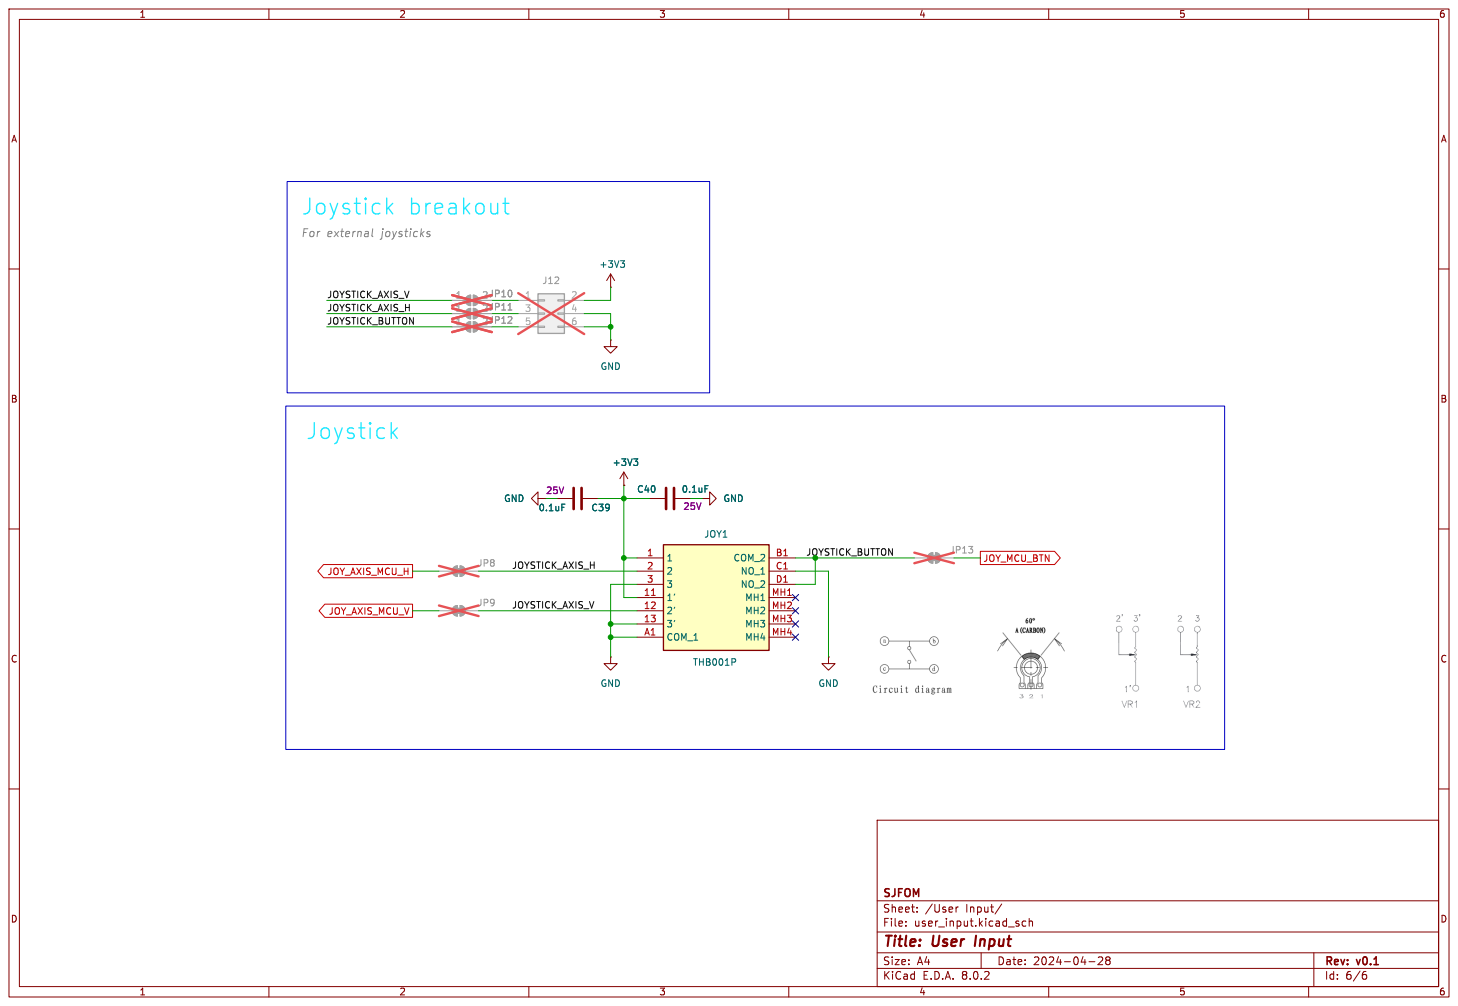
[picture p31: page 6]
