SJFOM/KiCad/Projects/StepUp/Outputs/v0.3/Schematic/StepUp_v0.3.pdf

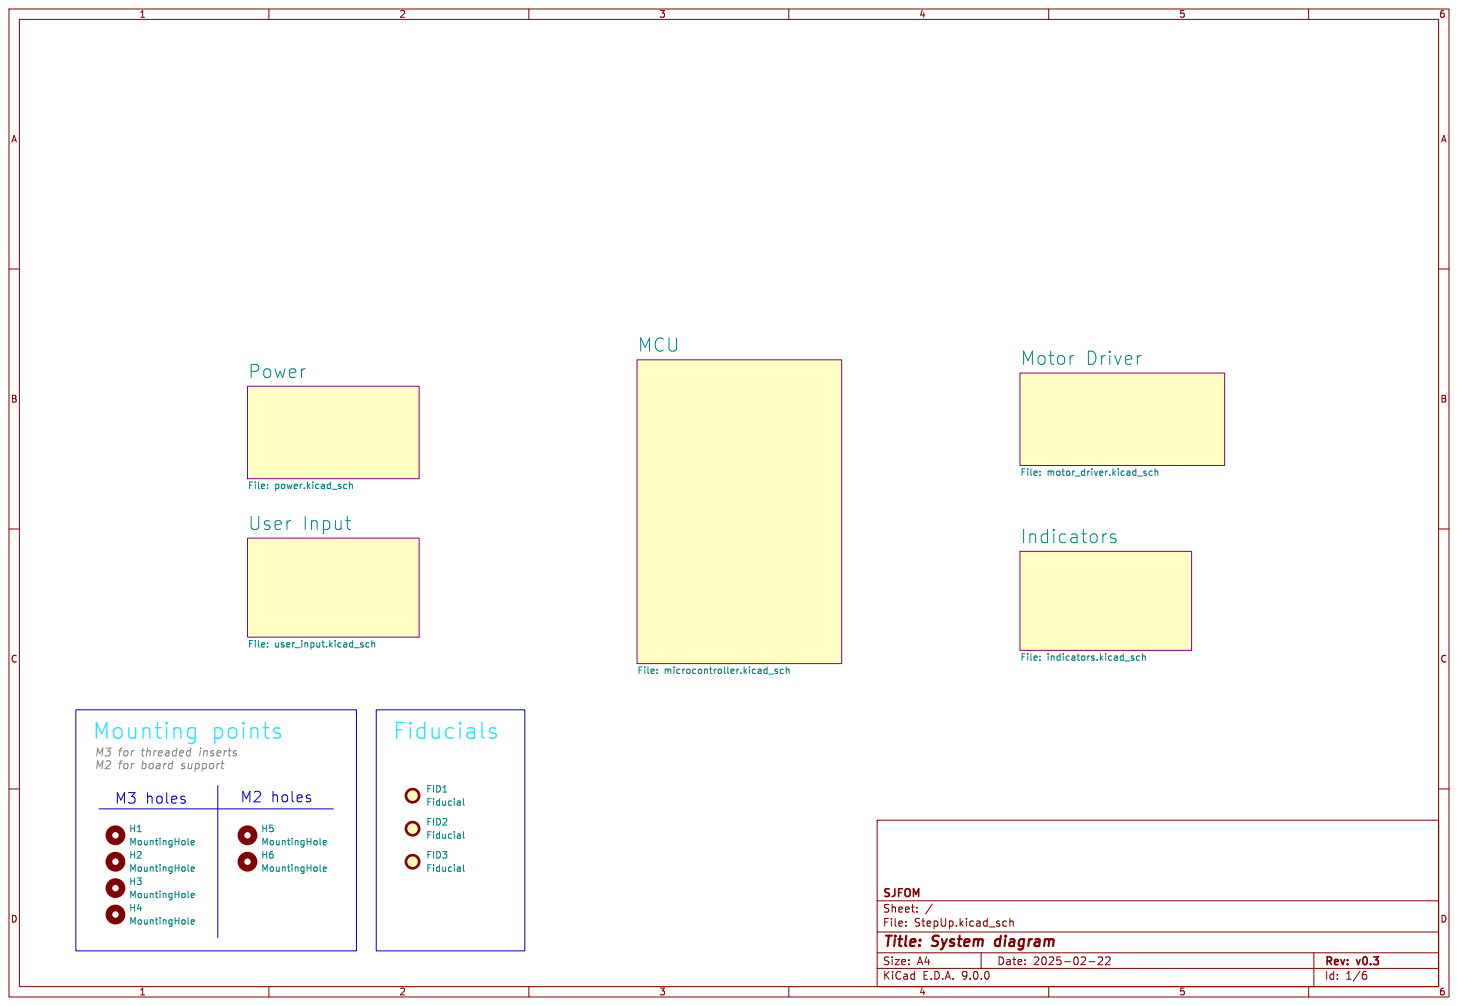
[picture p32: page 1]

File: StepUp.kicad_sch Sheet: / SJFOM Power

File: indicators.kicad_sch FID1 Fiducial FID2 Fiducial FID3 Fiducial H5 MountingHole H6 MountingHole H4 MountingHole H3 MountingHole H1 MountingHole H2 MountingHole

M3 for threaded inserts M2 for board support

Id: 1/6 Title: System diagram

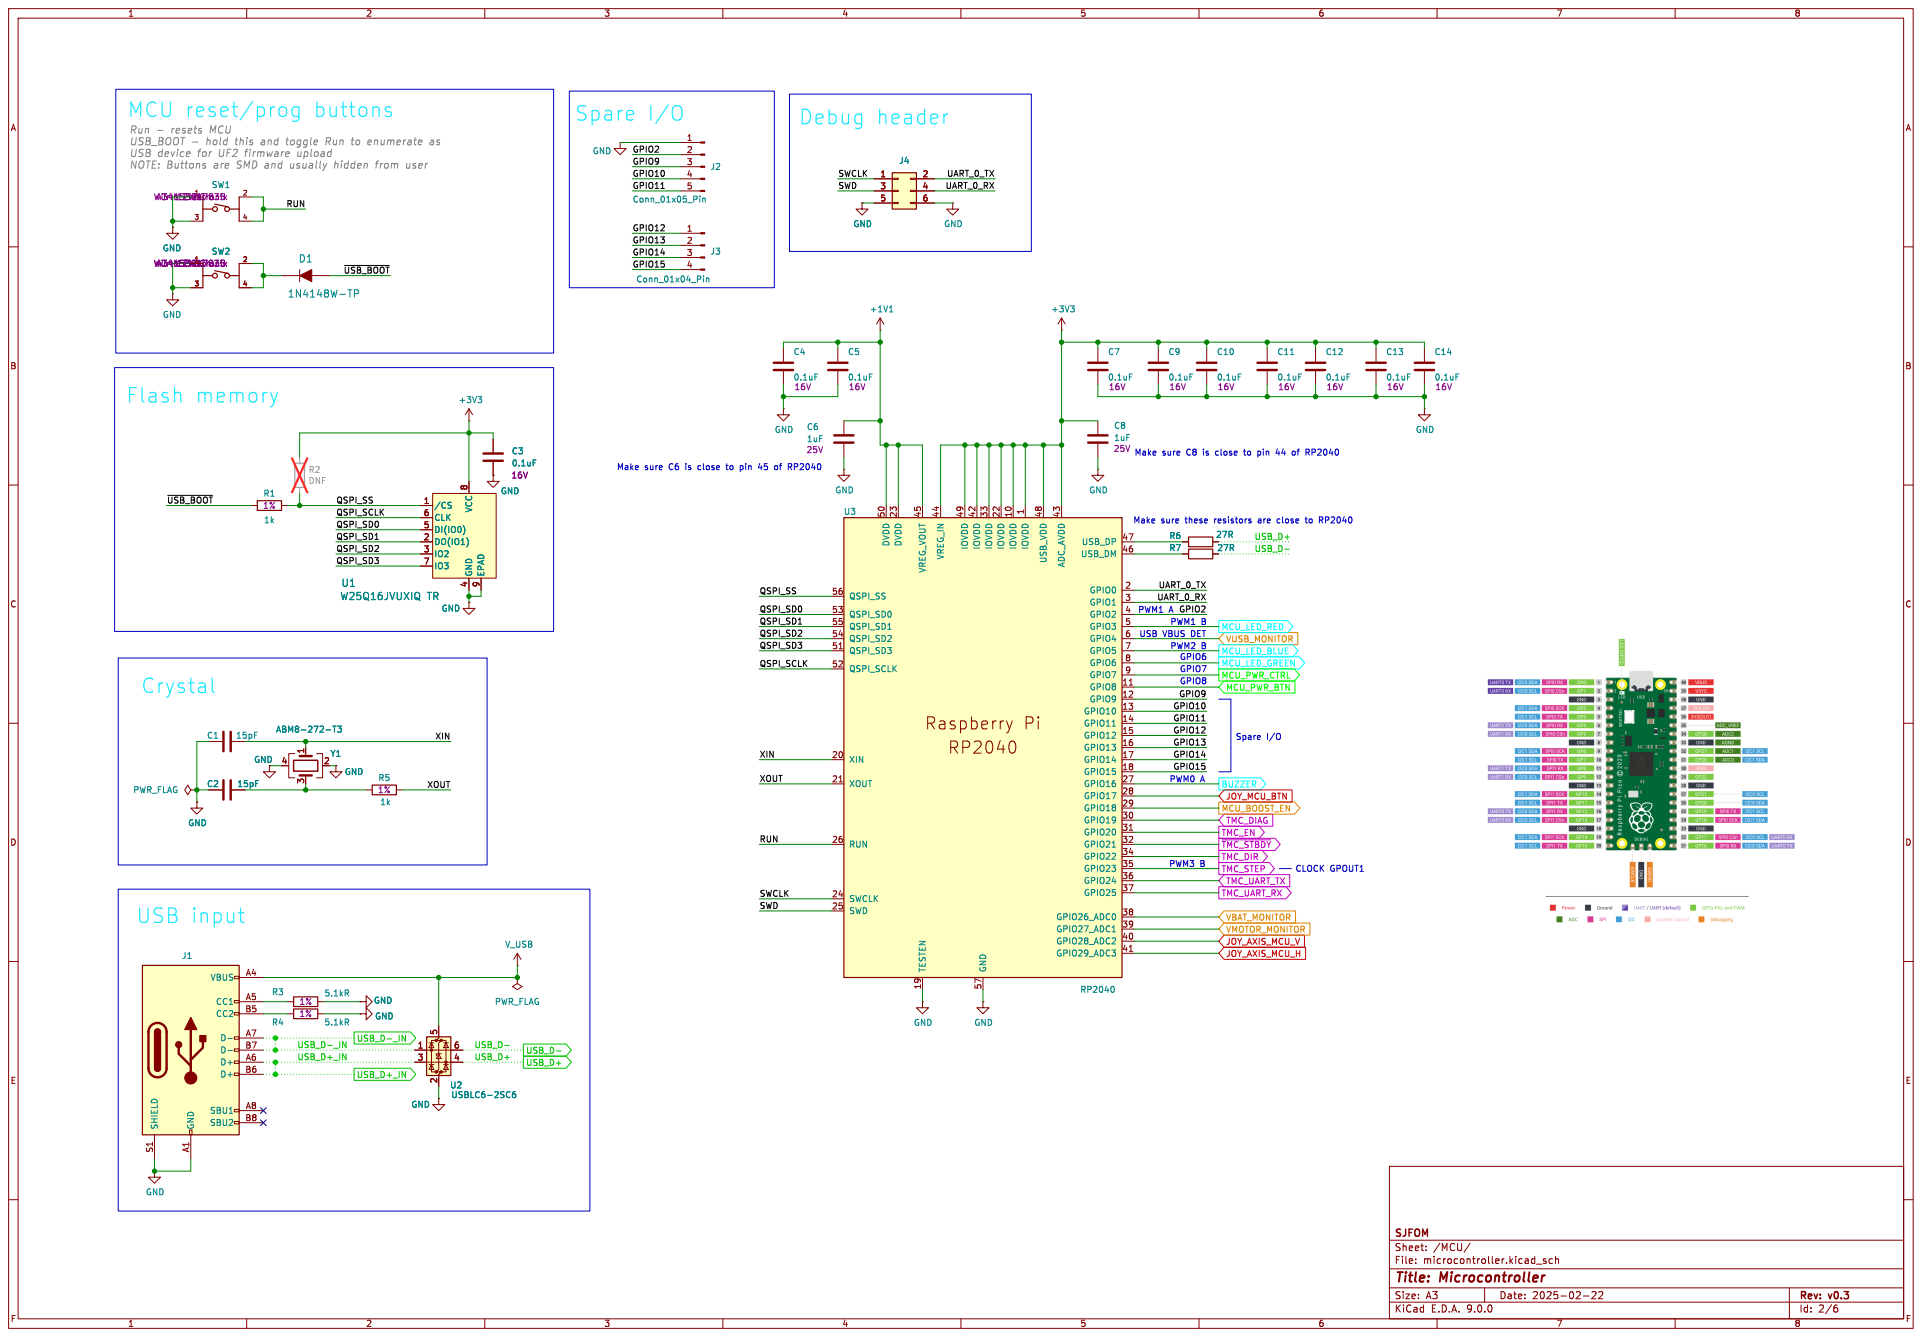
[picture p33: page 2]

Id: 2/6 Title: Microcontroller File: microcontroller.kicad_sch Sheet: /MCU/ SJFOM

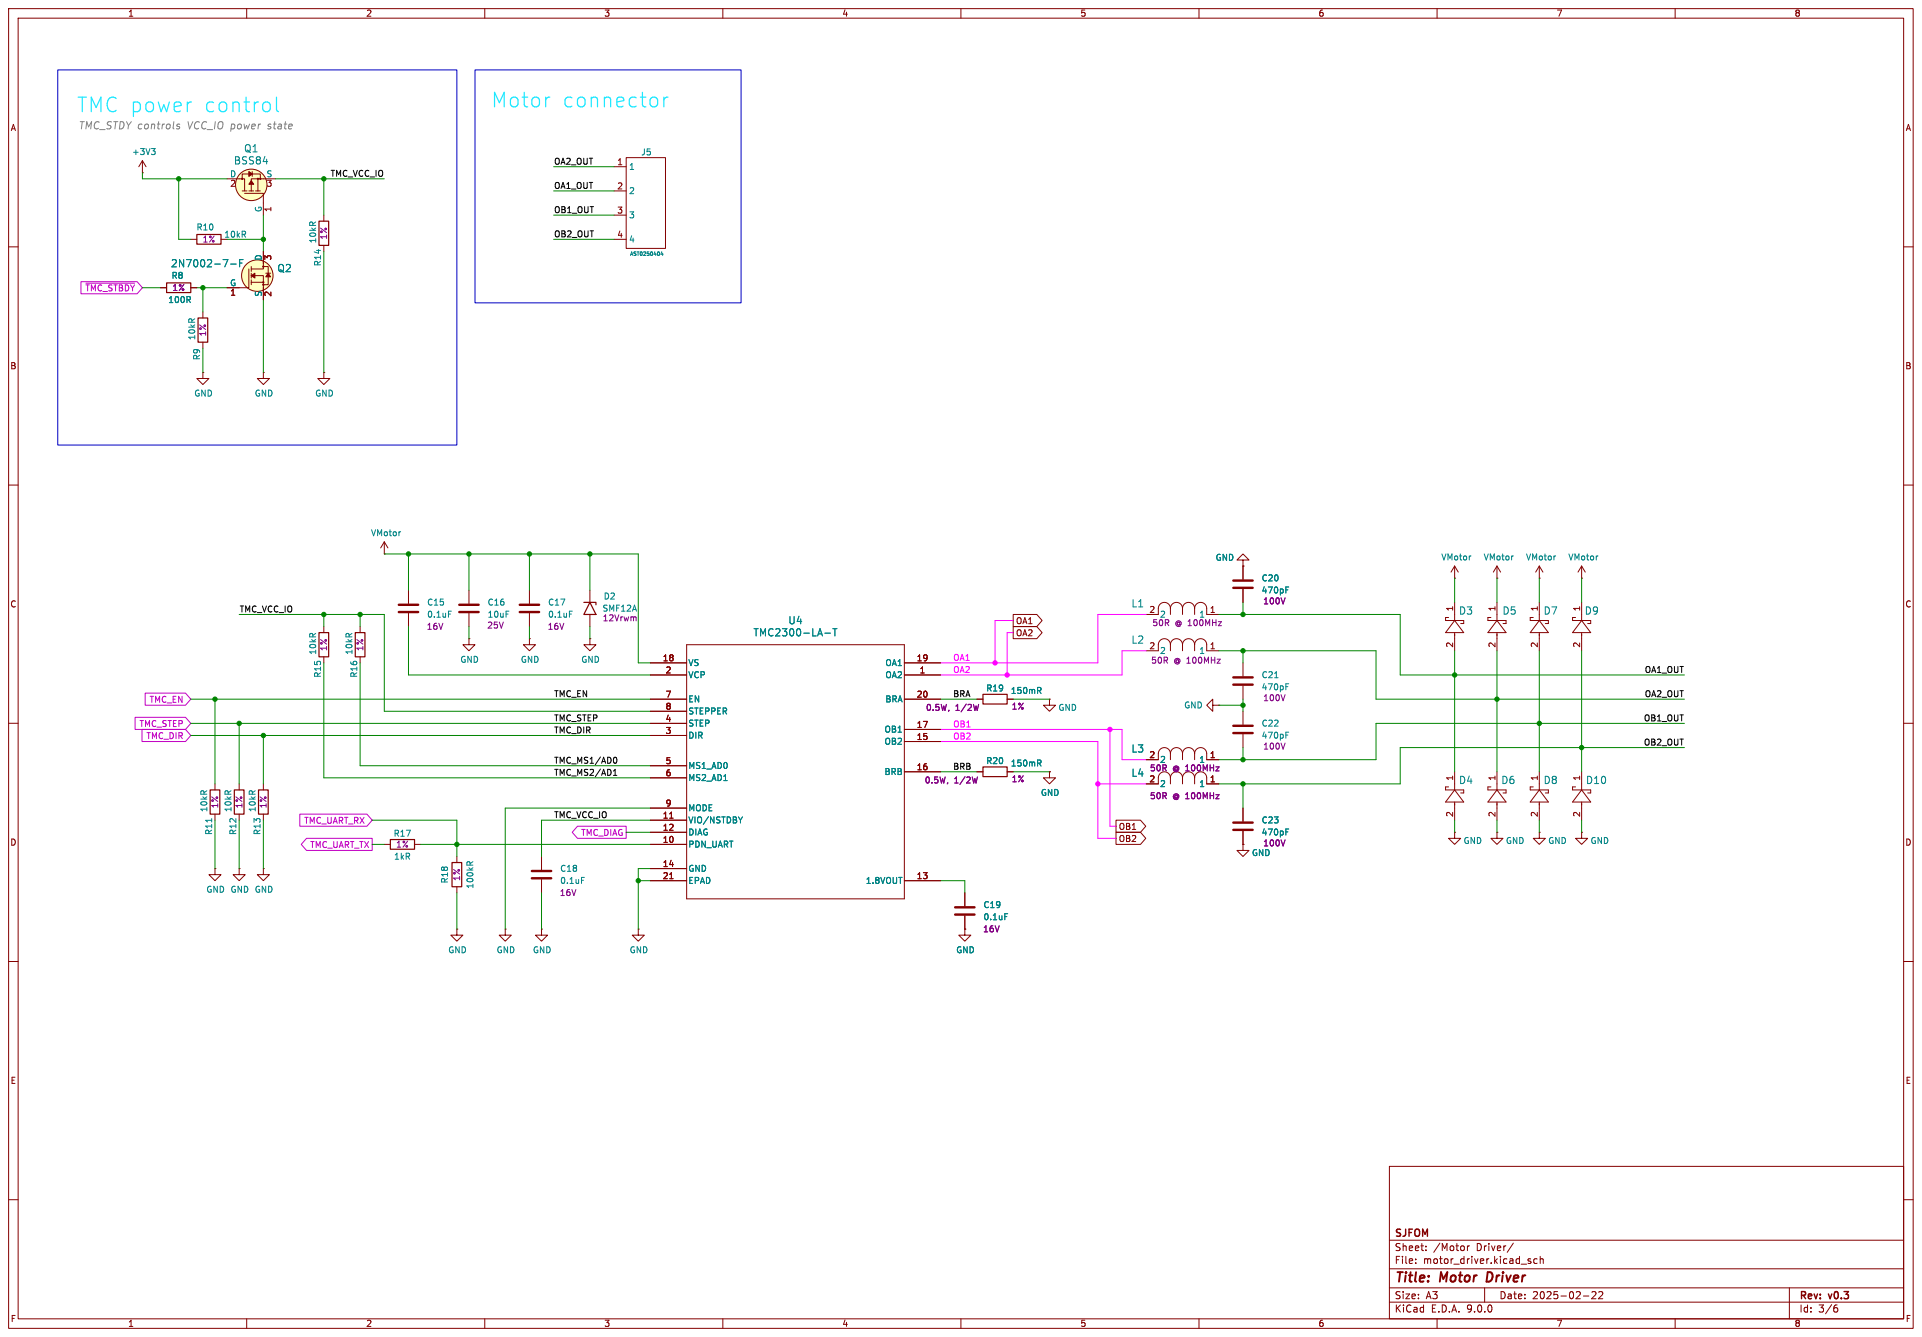
[picture p34: page 3]

2 1D8 GND GND GND GND

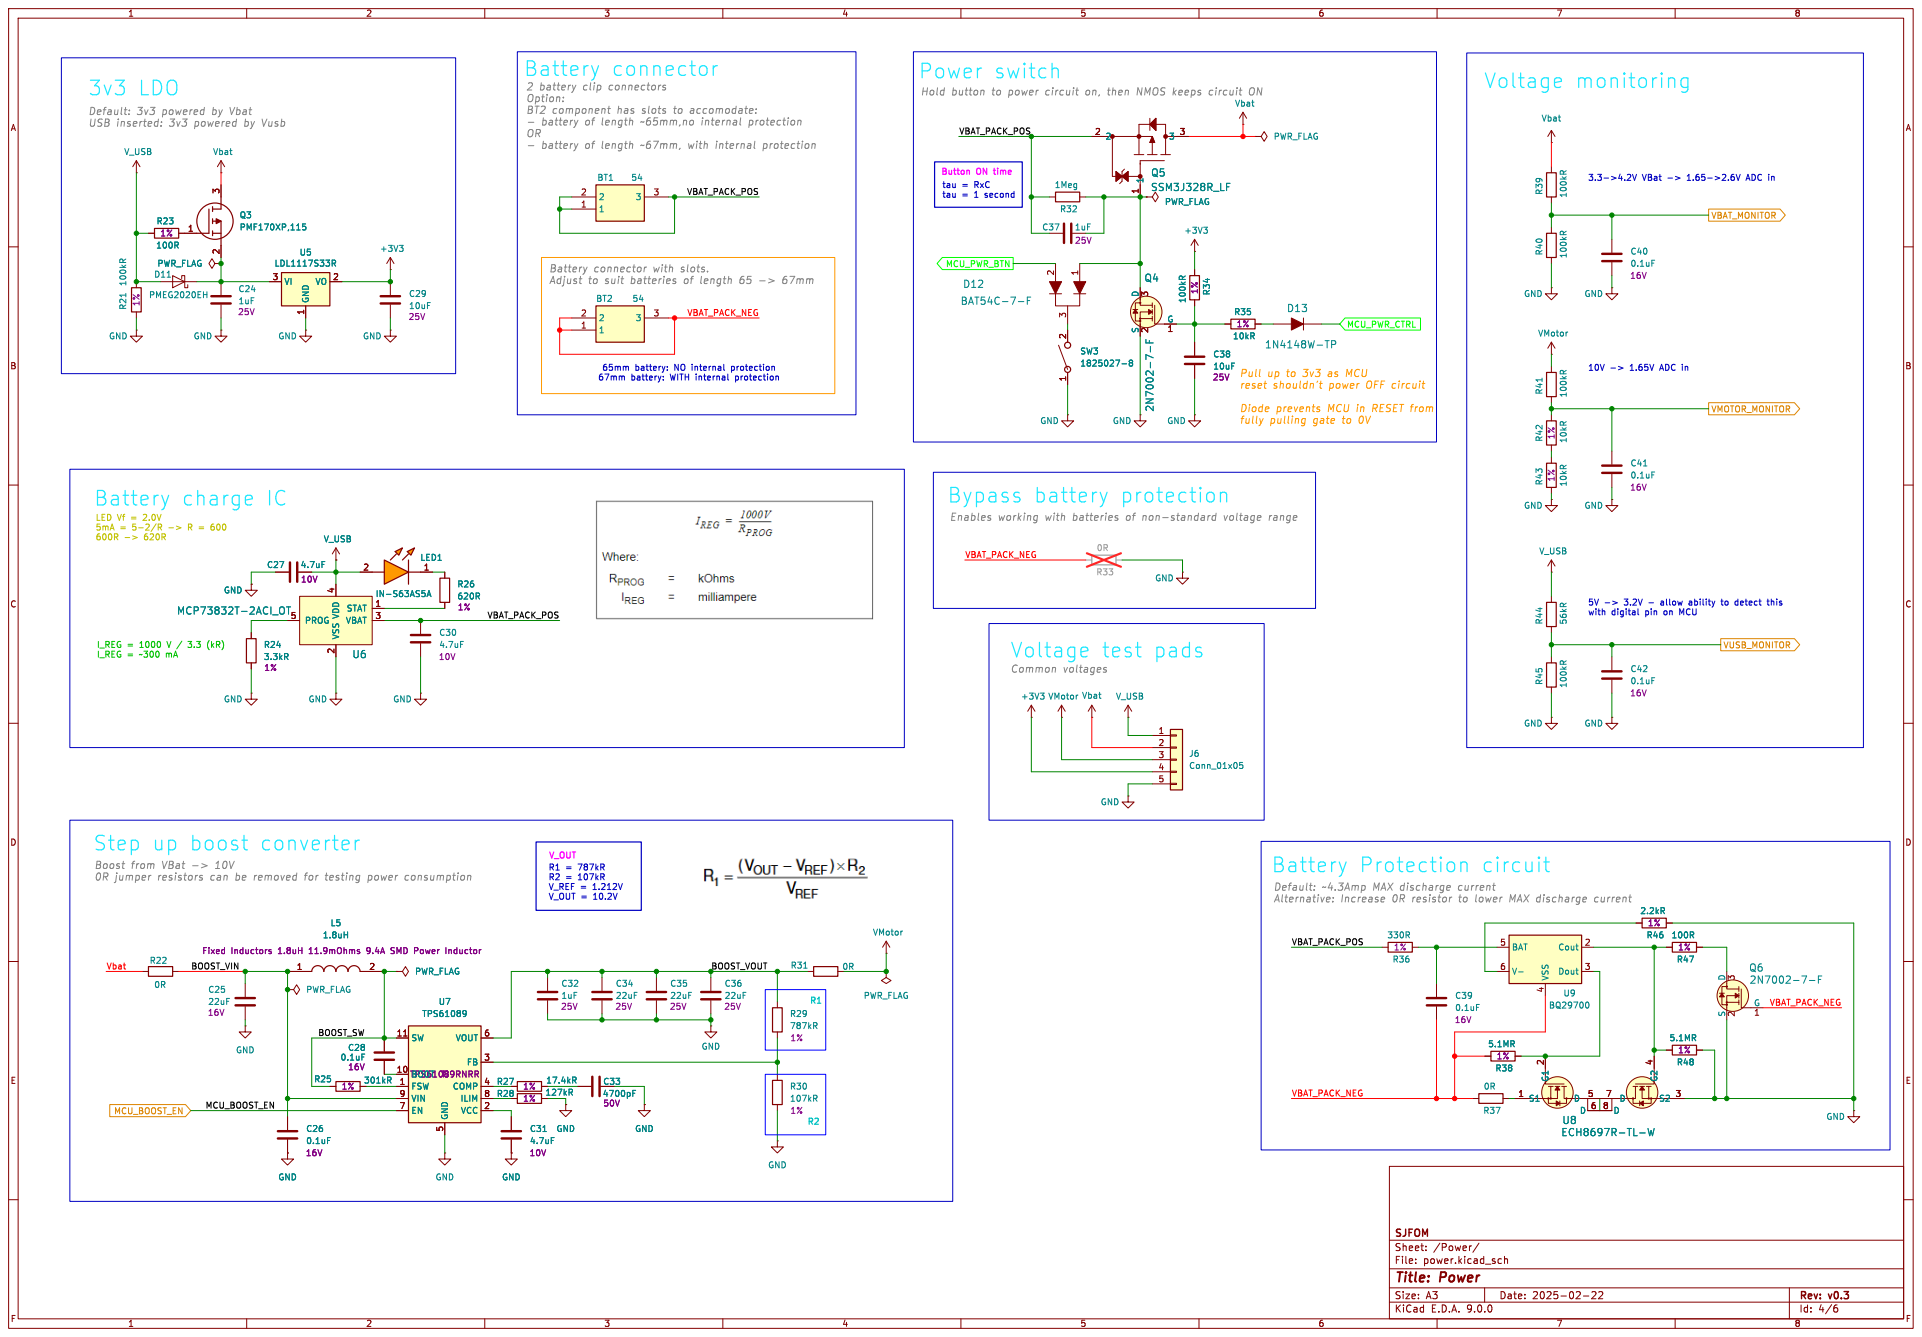
[picture p35: page 4]

- battery of length ~67mm, with internal protection

fully pulling gate to 0V

Step up boost converter

Id: 4/6 Title: Power File: power.kicad_sch Sheet: /Power/ SJFOM

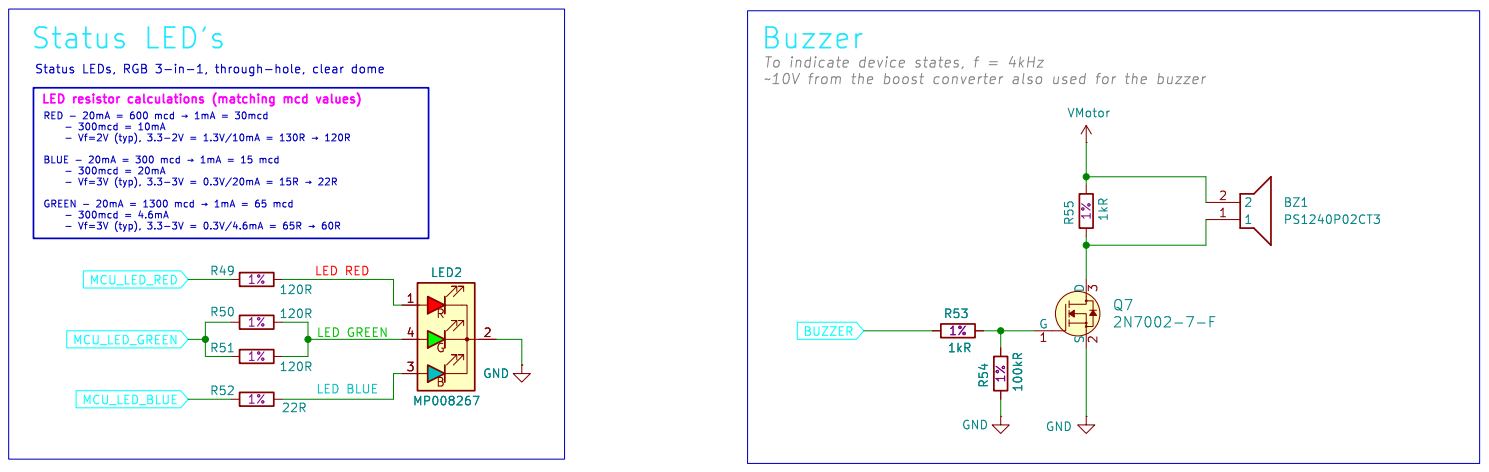
[picture p36: page 5]

BLUE - 20mA = 300 mcd þÿ!’1mA = 15 mcd
- 300mcd = 20mA

Id: 5/6 Title: User Input File: indicators.kicad_sch Sheet: /Indicators/ SJFOM
