SJFOM/KiCad/Projects/StepUp/StepUp.kicad_pcb

## KiCad design Projects/StepUp/StepUp.kicad_pcb (2026-03-30)

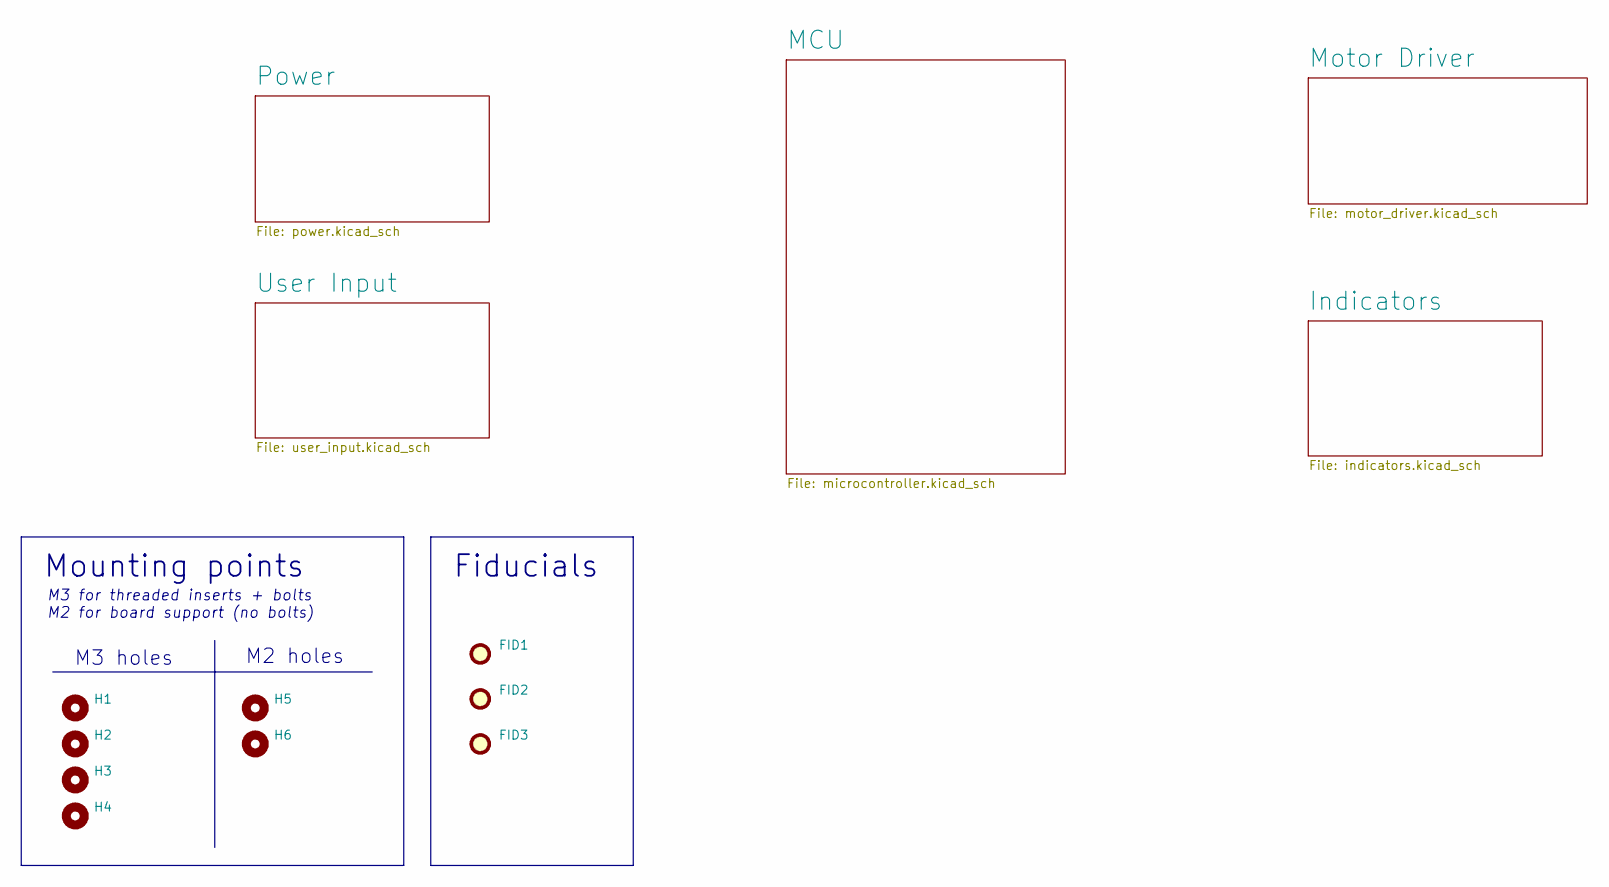
[picture p37: schematic StepUp.kicad_sch, System diagram]

Parts:
FID1, FID2, FID3: Fiducial; Fiducial_1mm_Mask2mm
H1, H2, H3, H4: MountingHole; MountingHole_3.2mm_M3_DIN965
H5, H6: MountingHole; MountingHole_2.2mm_M2

Notes on the sheet:
Mounting points
M3 holes
M2 holes
Fiducials
M3 for threaded inserts + bolts M2 for board support (no bolts)

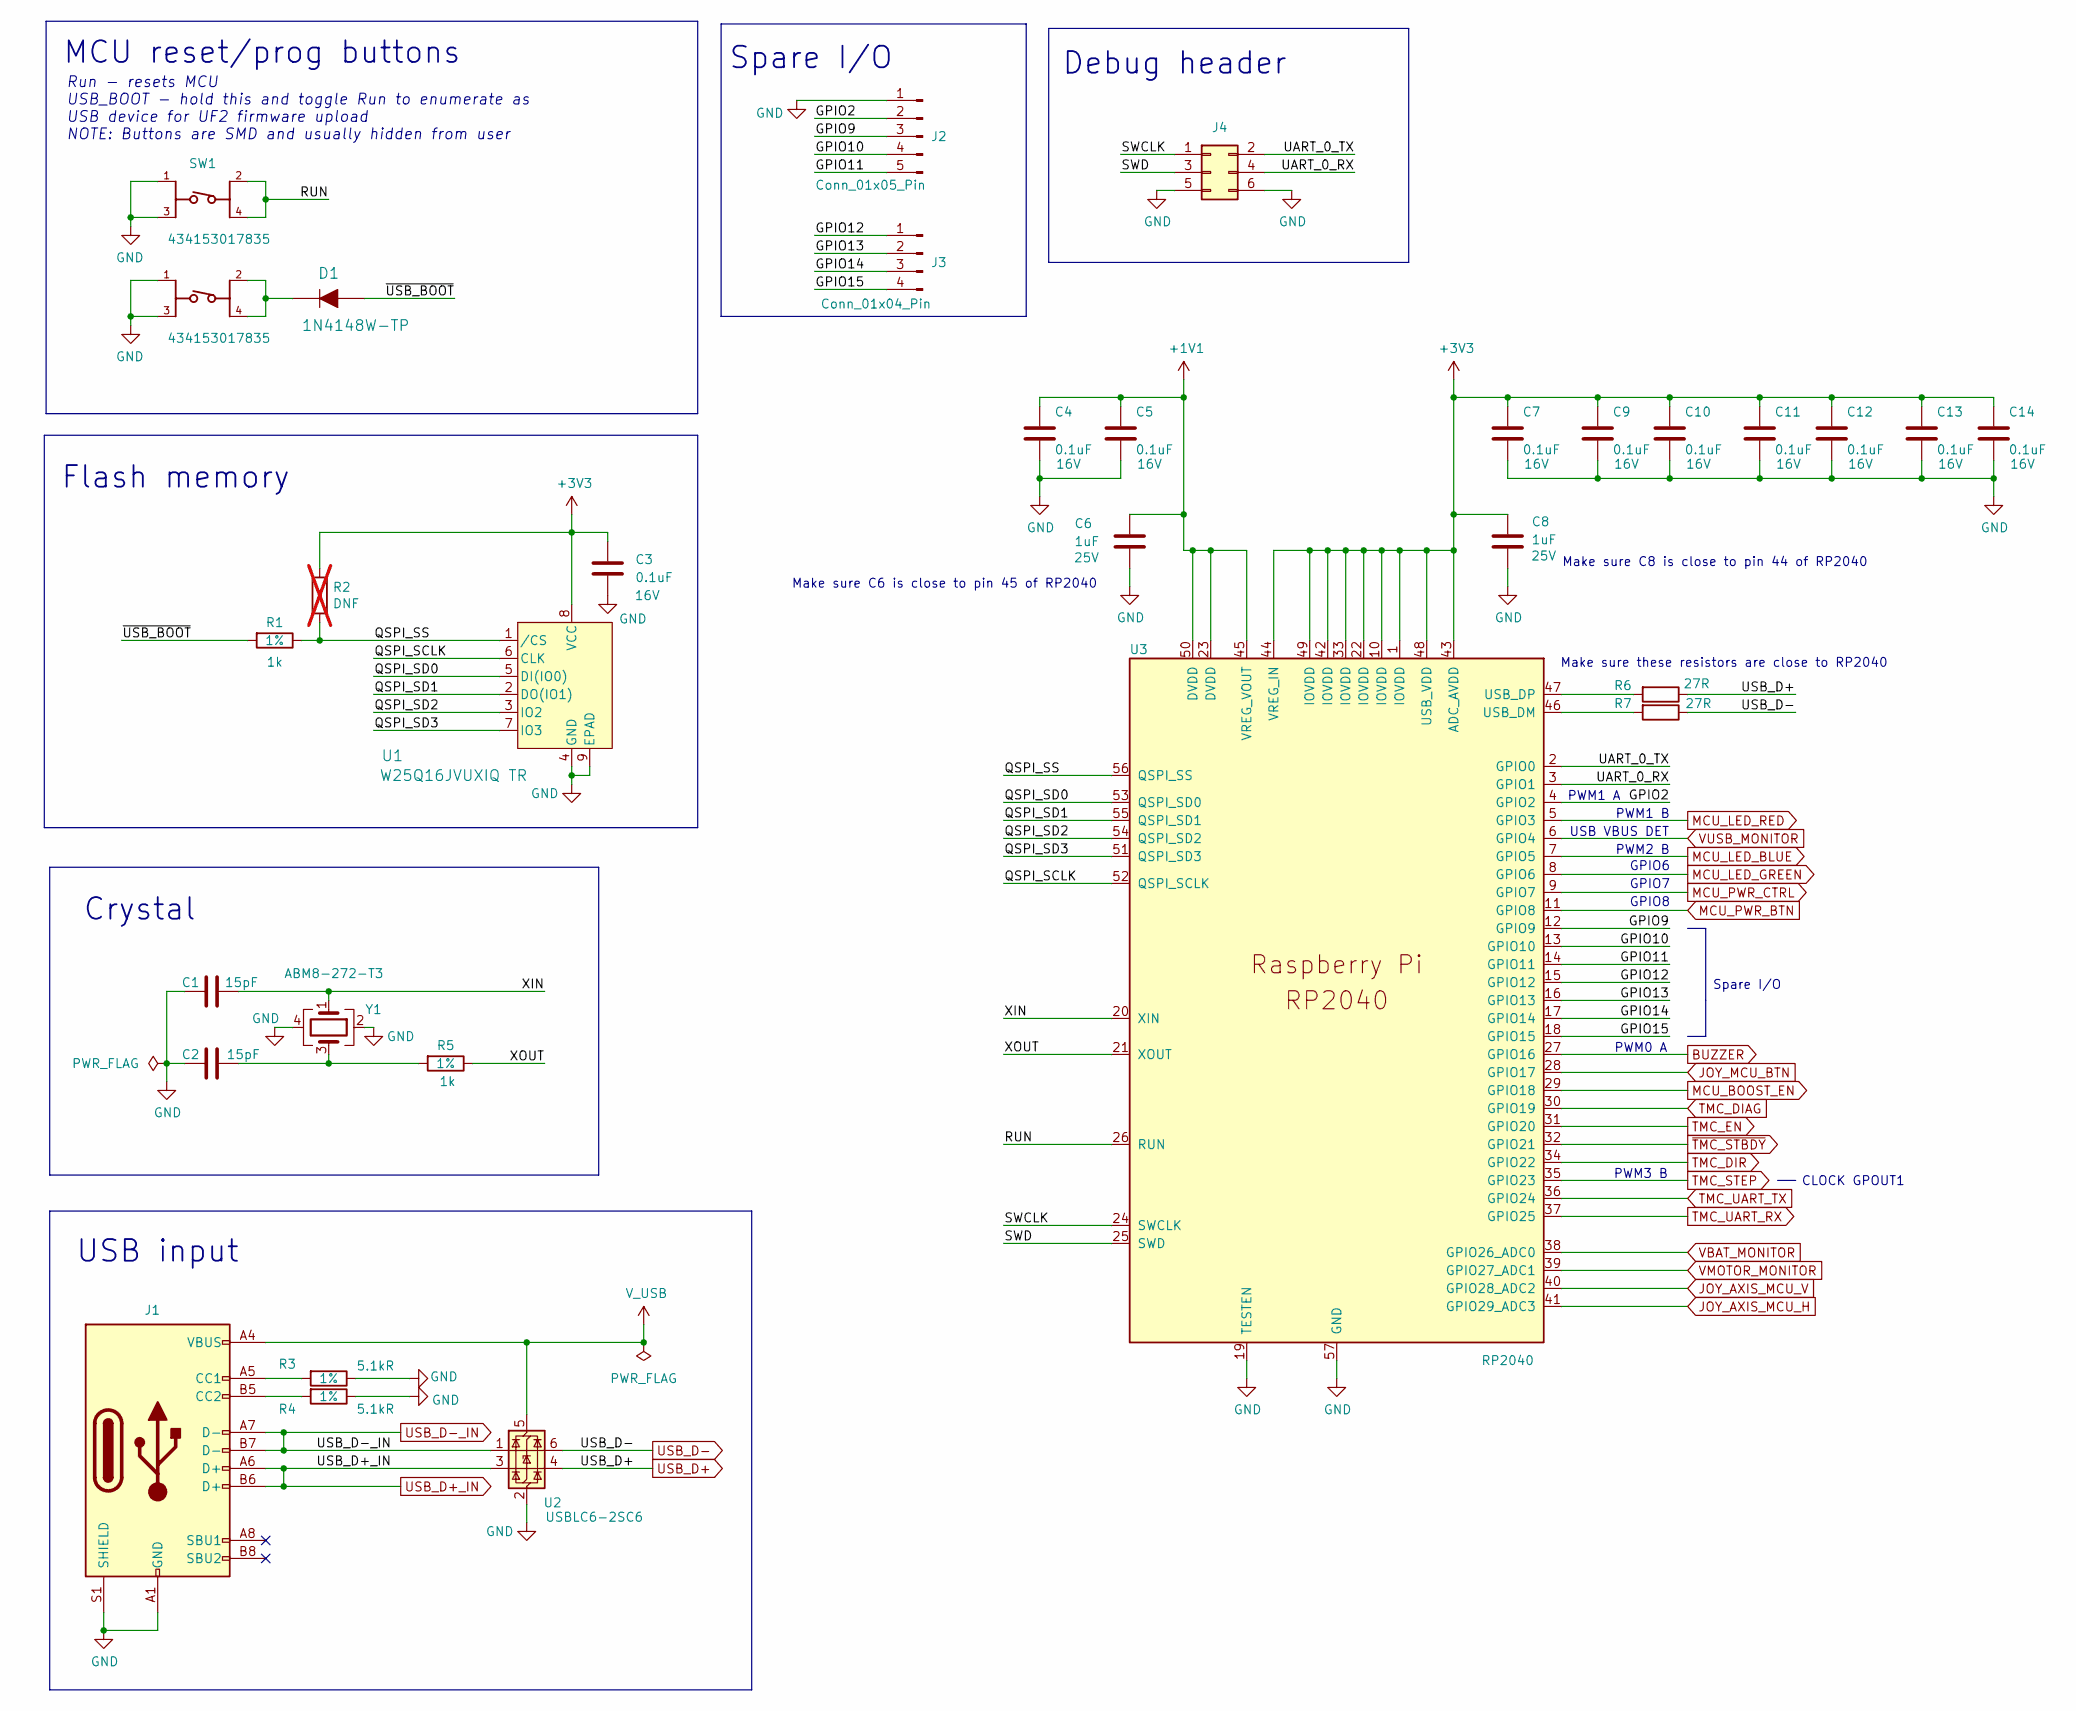
[picture p38: schematic microcontroller.kicad_sch]

Parts:
C1, C2: 15pF; C_0402_1005Metric; Tolerance 1%; Voltage 50V; MPN CC0402FRNPO9BN150
C3, C4, C5, C7, C9, C10, C11, C12, C13, C14: 0.1uF; C_0402_1005Metric; Voltage 16V; Tolerance 10%; MPN GRM155R61C104KA88D
C6, C8: 1uF; C_0603_1608Metric; Voltage 25V; Tolerance 10%; MPN GRM188R71E105KA12D
D1: 1N4148W-TP; SOD-123; MPN 1N4148W-TP; Digi-Key_PN 1N4148WTPMSCT-ND
J1: USB_C_Receptacle_USB2.0_16P; USB_C_Receptacle_GCT_USB4105-xx-A_16P_TopMnt_Horizontal; MPN USB4105-GF-A
J2: Conn_01x05_Pin; PinHeader_1x05_P2.54mm_Vertical
J3: Conn_01x04_Pin; PinHeader_1x04_P2.54mm_Vertical
J4: Conn_02x03_Odd_Even; PinHeader_2x03_P2.54mm_Vertical
R1, R5: 1k; R_0402_1005Metric; Tolerance 1%; MPN RC0402FR-071KL
R2: DNF; R_0402_1005Metric; not fitted
R3, R4: 5.1kR; R_0603_1608Metric; Tolerance 1%; MPN RC0603FR-075K1L
R6, R7: 27R; R_0402_1005Metric; Tolerance 1%; MPN RC0402FR-0727RL
SW1, SW2: 434153017835; 434153017835_434153017835; Voltage 12VDC; PART-NUMBER 434153017835
U1: W25Q16JVUXIQ TR; USON-8_UX_2x3x0p6_WIN; MPN W25Q16JVUXIQ TR
U2: USBLC6-2SC6; SOT-23-6; MPN USBLC6-2SC6
U3: RP2040; RP2040-QFN-56; MPN RP2040
Y1: ABM8-272-T3; Crystal_SMD_3225-4Pin_3.2x2.5mm; MPN ABM8-272-T3

Connections:
+1V1: C4.1, C5.1, C6.1, U3.23 (DVDD), U3.45 (VREG_VOUT), U3.50 (DVDD)
+3V3: C3.1, C7.1, C8.1, C9.1, C10.1, C11.1, C12.1, C13.1, C14.1, R2.1, U1.8 (VCC), U3.1 (IOVDD), U3.10 (IOVDD), U3.22 (IOVDD), U3.33 (IOVDD), U3.42 (IOVDD), U3.43 (ADC_AVDD), U3.44 (VREG_IN), U3.48 (USB_VDD), U3.49 (IOVDD); also elsewhere on the board
/MCU/GPIO2: J2.2, U3.4 (GPIO2)
/MCU/GPIO9: J2.3, U3.12 (GPIO9)
/MCU/GPIO10: J2.4, U3.13 (GPIO10)
/MCU/GPIO11: J2.5, U3.14 (GPIO11)
/MCU/GPIO12: J3.1, U3.15 (GPIO12)
/MCU/GPIO13: J3.2, U3.16 (GPIO13)
/MCU/GPIO14: J3.3, U3.17 (GPIO14)
/MCU/GPIO15: J3.4, U3.18 (GPIO15)
/MCU/QSPI_SCLK: U1.6 (CLK), U3.52 (QSPI_SCLK)
/MCU/QSPI_SD0: U1.5 (DI(IO0)), U3.53 (QSPI_SD0)
/MCU/QSPI_SD1: U1.2 (DO(IO1)), U3.55 (QSPI_SD1)
/MCU/QSPI_SD2: U1.3 (IO2), U3.54 (QSPI_SD2)
/MCU/QSPI_SD3: U1.7 (IO3), U3.51 (QSPI_SD3)
/MCU/QSPI_SS: R1.1, R2.2, U1.1 (/CS), U3.56 (QSPI_SS)
/MCU/RUN: SW1.2, SW1.4, U3.26 (RUN)
/MCU/SWCLK: J4.1, U3.24 (SWCLK)
/MCU/SWD: J4.3, U3.25 (SWD)
/MCU/UART_0_RX: J4.4, U3.3 (GPIO1)
/MCU/UART_0_TX: J4.2, U3.2 (GPIO0)
/MCU/XIN: C1.1, U3.20 (XIN), Y1.1
/MCU/XOUT: R5.1, U3.21 (XOUT)
/MCU/~USB_BOOT: D1.A, R1.2
BUZZER: U3.27 (GPIO16); also elsewhere on the board
GND: C1.2, C2.2, C3.2, C4.2, C5.2, C6.2, C7.2, C8.2, C9.2, C10.2, C11.2, C12.2, C13.2, C14.2, J1.A1 (GND), J1.A12 (GND), J1.B1 (GND), J1.B12 (GND), J1.S1 (SHIELD), J2.1, J4.5, J4.6, R3.1, R4.1, SW1.1, SW1.3, SW2.1, SW2.3, U1.4 (GND), U1.9 (EPAD), U2.2 (GND), U3.19 (TESTEN), U3.57 (GND), Y1.2, Y1.4; also elsewhere on the board
JOY_AXIS_MCU_H: U3.41 (GPIO29_ADC3); also elsewhere on the board
JOY_AXIS_MCU_V: U3.40 (GPIO28_ADC2); also elsewhere on the board
JOY_MCU_BTN: U3.28 (GPIO17); also elsewhere on the board
MCU_BOOST_EN: U3.29 (GPIO18); also elsewhere on the board
MCU_LED_BLUE: U3.7 (GPIO5); also elsewhere on the board
MCU_LED_GREEN: U3.8 (GPIO6); also elsewhere on the board
MCU_LED_RED: U3.5 (GPIO3); also elsewhere on the board
MCU_PWR_BTN: U3.11 (GPIO8); also elsewhere on the board
MCU_PWR_CTRL: U3.9 (GPIO7); also elsewhere on the board
unnamed: C2.1, R5.2, Y1.3
unnamed: D1.K, SW2.2, SW2.4
unnamed: J1.A5 (CC1), R3.2
unnamed: J1.B5 (CC2), R4.2
unnamed: R7.2, U3.46 (USB_DM)
unnamed: R6.2, U3.47 (USB_DP)
TMC_DIAG: U3.30 (GPIO19); also elsewhere on the board
TMC_DIR: U3.34 (GPIO22); also elsewhere on the board
TMC_EN: U3.31 (GPIO20); also elsewhere on the board
TMC_STEP: U3.35 (GPIO23); also elsewhere on the board
TMC_UART_RX: U3.37 (GPIO25); also elsewhere on the board
TMC_UART_TX: U3.36 (GPIO24); also elsewhere on the board
USB_D+: R6.1, U2.4 (I/O2)
USB_D+_IN: J1.A6 (D+), J1.B6 (D+), U2.3 (I/O2)
USB_D-: R7.1, U2.6 (I/O1)
USB_D-_IN: J1.A7 (D-), J1.B7 (D-), U2.1 (I/O1)
VBAT_MONITOR: U3.38 (GPIO26_ADC0); also elsewhere on the board
VMOTOR_MONITOR: U3.39 (GPIO27_ADC1); also elsewhere on the board
VUSB_MONITOR: U3.6 (GPIO4); also elsewhere on the board
V_USB: J1.A4 (VBUS), J1.A9 (VBUS), J1.B4 (VBUS), J1.B9 (VBUS), U2.5 (VBUS); also elsewhere on the board
~TMC_STBDY: U3.32 (GPIO21); also elsewhere on the board

Notes on the sheet:
CLOCK GPOUT1
GPIO6
Spare I/O
Make sure C8 is close to pin 44 of RP2040
Make sure C6 is close to pin 45 of RP2040
Debug header
PWM0 A
USB VBUS DET
MCU reset/prog buttons
Flash memory
PWM1 A
Crystal
PWM3 B
USB input
GPIO7
Run - resets MCU USB_BOOT - hold this and toggle Run to enumerate as USB device for UF2 firmware upload NOTE: Buttons are SMD and usually hidden from user
PWM2 B
PWM1 B
GPIO8
Make sure these resistors are close to RP2040

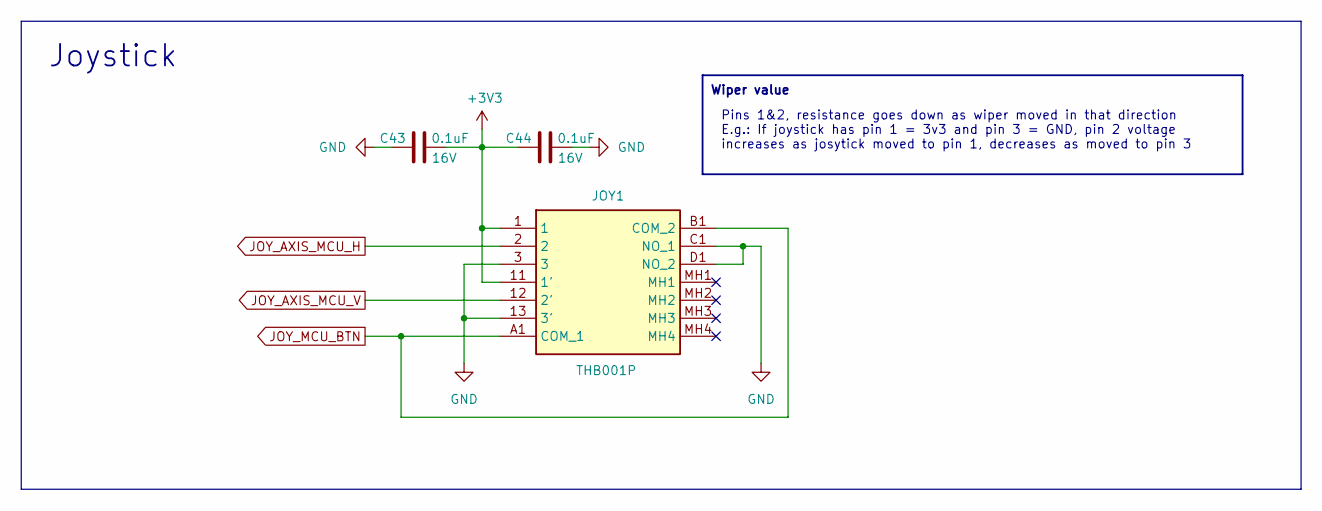
[picture p39: schematic user_input.kicad_sch, User Input]

Parts:
C43, C44: 0.1uF; C_0402_1005Metric; Voltage 16V; Tolerance 10%; MPN GRM155R61C104KA88D
JOY1: THB001P; Mouser Part Number 611-THB001P

Connections:
+3V3: C43.2, C44.1, JOY1.1, JOY1.11 (1'); also elsewhere on the board
GND: C43.1, C44.2, JOY1.3, JOY1.13 (3'), JOY1.C1 (NO_1), JOY1.D1 (NO_2); also elsewhere on the board
JOY_AXIS_MCU_H: JOY1.2; also elsewhere on the board
JOY_AXIS_MCU_V: JOY1.12 (2'); also elsewhere on the board
JOY_MCU_BTN: JOY1.A1 (COM_1), JOY1.B1 (COM_2); also elsewhere on the board

Notes on the sheet:
Wiper value
Pins 1&2, resistance goes down as wiper moved in that direction E.g.: If joystick has pin 1 = 3v3 and pin 3 = GND, pin 2 voltage increases as josytick moved to pin 1, decreases as moved to pin 3
Joystick

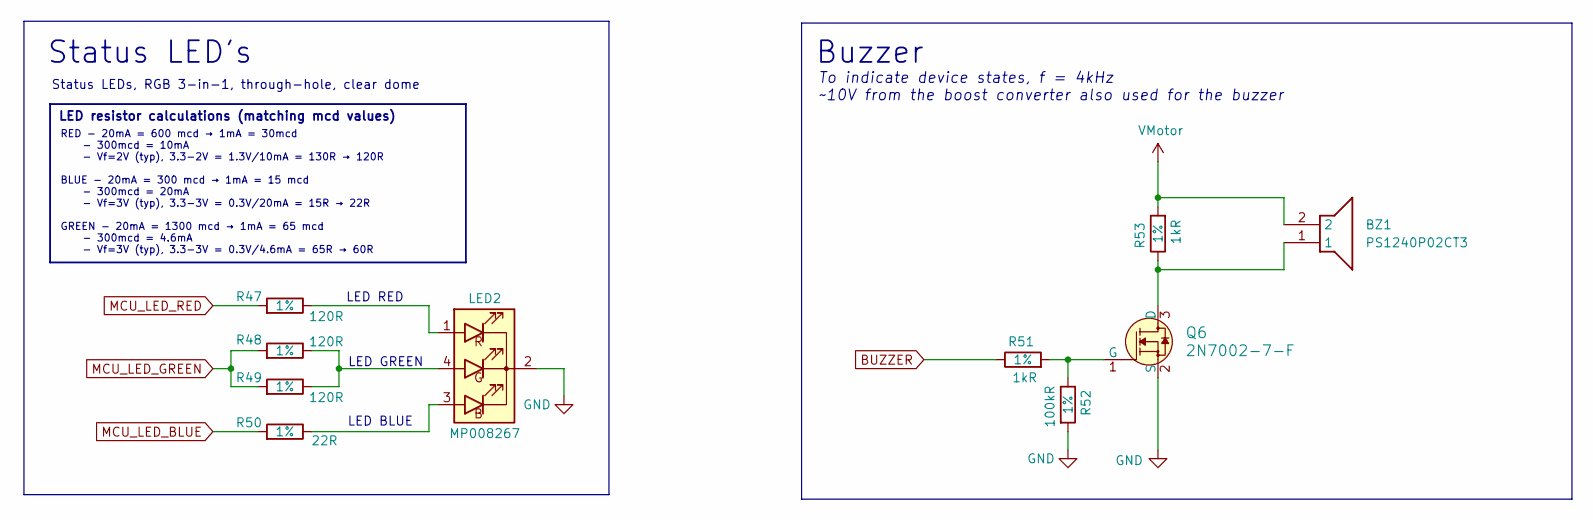
[picture p40: schematic indicators.kicad_sch, User Input]

Parts:
BZ1: PS1240P02CT3; PS1240P02BT; Mouser Part Number 810-PS1240P02CT3
LED2: MP008267; Manufacturer Part Number MP008267
Q6: 2N7002-7-F; SOT-23-3; MPN 2N7002-7-F; Digi-Key_PN 2N7002-FDICT-ND
R47, R48, R49: 120R; R_0603_1608Metric; Tolerance 1%; MPN RC0603FR-07120RL
R50: 22R; R_0603_1608Metric; Tolerance 1%; MPN RC0603FR-0722RL
R51, R53: 1kR; R_0603_1608Metric; Tolerance 1%; MPN RC0603FR-071KL
R52: 100kR; R_0603_1608Metric; Tolerance 1%; MPN RC0603FR-07100KL

Connections:
BUZZER: R51.1; also elsewhere on the board
GND: LED2.2, Q6.2 (S), R52.2; also elsewhere on the board
MCU_LED_BLUE: R50.2; also elsewhere on the board
MCU_LED_GREEN: R48.2, R49.2; also elsewhere on the board
MCU_LED_RED: R47.2; also elsewhere on the board
unnamed: LED2.1, R47.1
unnamed: LED2.3, R50.1
unnamed: LED2.4, R48.1, R49.1
unnamed: BZ1.1, Q6.3 (D), R53.1
unnamed: Q6.1 (G), R51.2, R52.1
VMotor: BZ1.2, R53.2; also elsewhere on the board

Notes on the sheet:
LED GREEN
LED RED
Status LED's
LED resistor calculations (matching mcd values)
Status LEDs, RGB 3-in-1, through-hole, clear dome
Buzzer
To indicate device states, f = 4kHz ~10V from the boost converter also used for the buzzer
RED - 20mA = 600 mcd → 1mA = 30mcd - 300mcd = 10mA - Vf=2V (typ), 3.3-2V = 1.3V/10mA = 130R → 120R BLUE - 20mA = 300 mcd → 1mA = 15 mcd - 300mcd = 20mA - Vf=3V (typ), 3.3-3V = 0.3V/20mA = 15R → 22R GREEN - 20mA = 1300 mcd → 1mA = 65 mcd - 300mcd = 4.6mA - Vf=3V (typ), 3.3-3V = 0.3V/4.6mA = 65R → 60R
LED BLUE

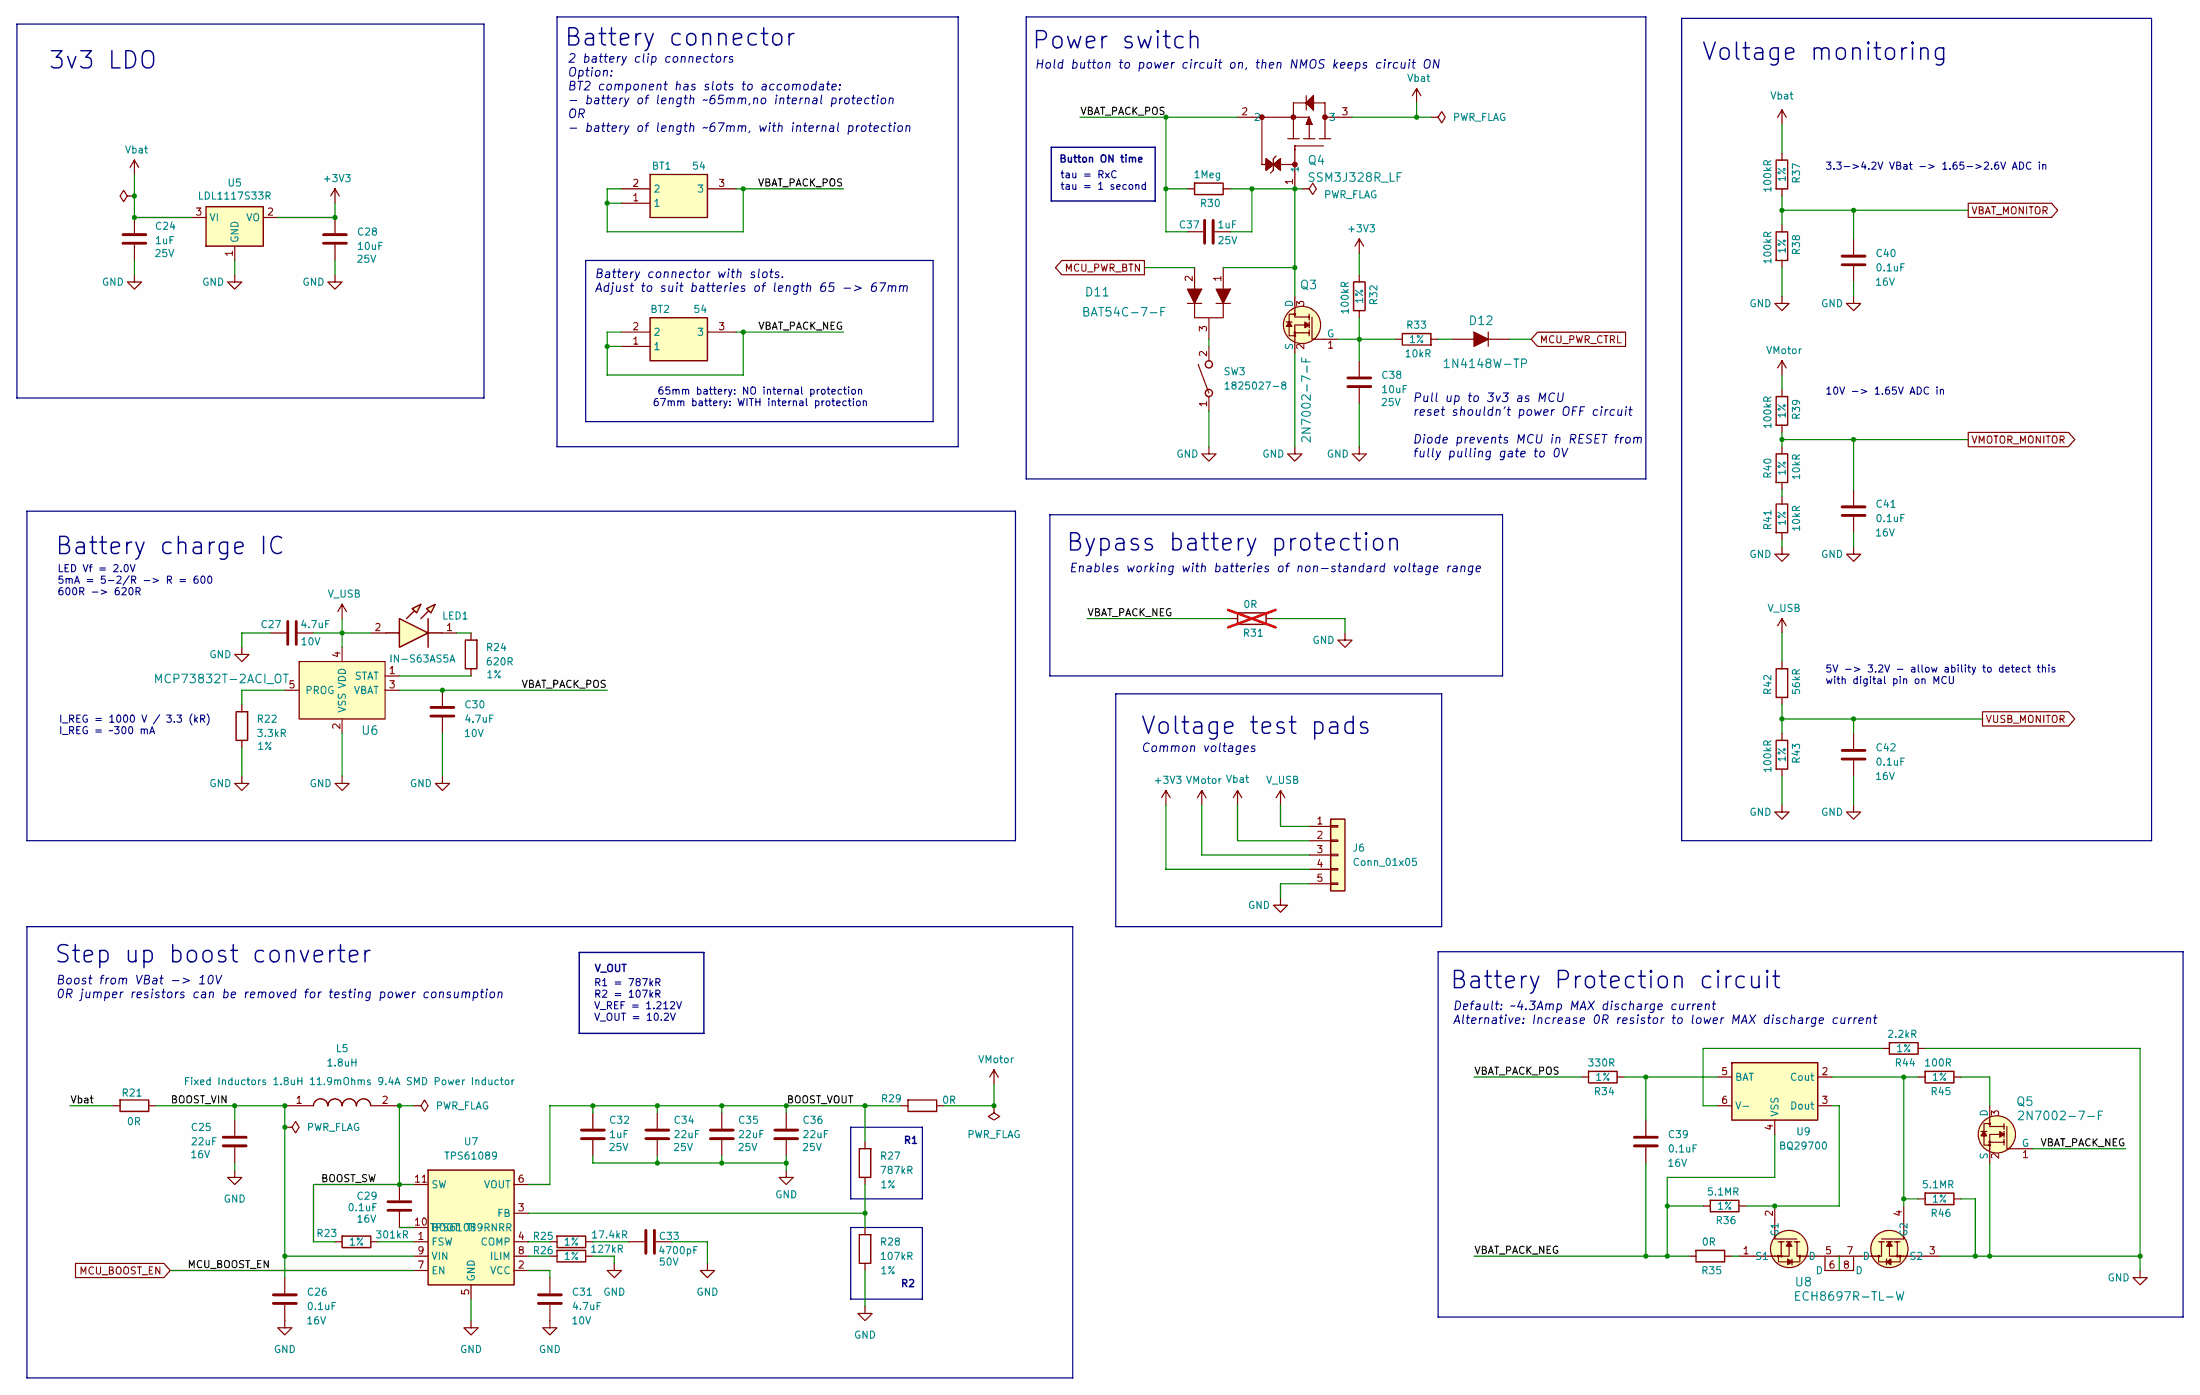
[picture p41: schematic power.kicad_sch]

Parts:
BT1: 54; Mouser Part Number 534-54
BT2: 54; 54_SLOT; Mouser Part Number 534-54
C24, C32, C37: 1uF; C_0603_1608Metric; Voltage 25V; Tolerance 10%; MPN GRM188R71E105KA12D
C25: 22uF; C_1206_3216Metric; Voltage 16V; Tolerance 10%; MPN GRM319R61C226KE15D
C26, C29, C39, C40, C41, C42: 0.1uF; C_0402_1005Metric; Voltage 16V; Tolerance 10%; MPN GRM155R61C104KA88D
C27, C30, C31: 4.7uF; C_0603_1608Metric; Voltage 10V; Tolerance 10%; MPN 0603ZD475KAT2A
C28, C38: 10uF; C_0603_1608Metric; Voltage 25V; Tolerance 10%; MPN GRM188R61E106KA73D
C33: 4700pF; C_0402_1005Metric; Voltage 50V; Tolerance 10%; MPN GRM155R61H472KA01D
C34, C35, C36: 22uF; C_1210_3225Metric; Voltage 25V; Tolerance 10%; MPN GRM32ER71E226KE15L
D11: BAT54C-7-F; SOT-23-3; MPN BAT54C-7-F; Digi-Key_PN BAT54C-FDICT-ND
D12: 1N4148W-TP; SOD-123; MPN 1N4148W-TP; Digi-Key_PN 1N4148WTPMSCT-ND
J6: Conn_01x05; PinHeader_1x05_P2.54mm_Vertical
L5: 1.8uH; INDPM9585X300N; MPN CDMC8D28NP-1R8MC; Mouser Part Number 851-CDMC8D28NP-1R8MC
LED1: IN-S63AS5A; INS63AS5UW; MPN IN-S63AS5A
Q3, Q5: 2N7002-7-F; SOT-23-3; MPN 2N7002-7-F; Digi-Key_PN 2N7002-FDICT-ND
Q4: SSM3J328R_LF; SOT-23F_TOS; MPN SSM3J328R,LF
R21, R29, R35: 0R; R_0603_1608Metric; MPN RC0603FR-070RL
R22: 3.3kR; R_0603_1608Metric; Tolerance 1%; MPN ERJU03F3301V
R23: 301kR; R_0402_1005Metric; Tolerance 1%; MPN CRCW0402301KFKED
R24: 620R; R_0603_1608Metric; Tolerance 1%; MPN RC0603FR-07620RL
R25: 17.4kR; R_0402_1005Metric; Tolerance 1%; MPN CRCW040217K4FKED
R26: 127kR; R_0402_1005Metric; Tolerance 1%; MPN CRCW0402127KFKED
R27: 787kR; R_0402_1005Metric; Tolerance 1%; MPN CRCW0402787KFKED
R28: 107kR; R_0402_1005Metric; Tolerance 1%; MPN CRCW0402107KFKED
R30: 1Meg; R_0603_1608Metric; Tolerance 1%; MPN RC0603FR-071ML
R31: 0R; R_0603_1608Metric; MPN RC0603FR-070RL; not fitted
R32, R37, R38, R39, R43: 100kR; R_0603_1608Metric; Tolerance 1%; MPN RC0603FR-07100KL
R33, R40, R41: 10kR; R_0603_1608Metric; Tolerance 1%; MPN RC0603FR-0710KL
R34: 330R; R_0603_1608Metric; Tolerance 1%; MPN RC0603FR-07330RL
R36, R46: 5.1MR; R_0603_1608Metric; Tolerance 1%; MPN RC0603FR-075M1L
R42: 56kR; R_0603_1608Metric; Tolerance 1%; MPN RC0603FR-0756KL
R44: 2.2kR; R_0402_1005Metric; Tolerance 1%; MPN RC0402FR-072K2L
R45: 100R; R_0603_1608Metric; Tolerance 1%; MPN RC0603FR-07100RL
SW3: 1825027-8; Manufacturer_Part_Number 1825027-8; Mouser Part Number 506-1825027-8
U5: LDL1117S33R; SOT-223-3_TabPin2; MPN LDL1117S33R
U6: MCP73832T-2ACI_OT; SOT-753; MPN MCP73832T-2ACI/OT; Digi-Key_PN MCP73832T-2ACI/OTCT-ND
U7: TPS61089; Texas_VQFN-RNR0011A-11; MPN TPS61089RNRR
U8: ECH8697R-TL-W; SOT-28FL-8_2P9X2P3_ONS; MPN ECH8697R-TL-W
U9: BQ29700; WSON-6_1.5x1.5mm_P0.5mm; MPN BQ29700DSER

Connections:
+3V3: C28.1, J6.4, R32.1, U5.2 (VO); also elsewhere on the board
/Power/BOOST_SW: C29.2, L5.2, R23.2, U7.11 (SW)
/Power/BOOST_VIN: C25.1, C26.1, L5.1, R21.1, U7.9 (VIN)
/Power/BOOST_VOUT: C32.1, C34.1, C35.1, C36.1, R27.2, R29.2, U7.6 (VOUT)
/Power/VBAT_PACK_NEG: BT2.1, BT2.2, BT2.3, C39.2, Q5.1 (G), R31.2, R35.2, R36.2, U9.4 (VSS)
/Power/VBAT_PACK_POS: BT1.1, BT1.2, BT1.3, C30.1, C37.1, Q4.2, R30.2, R34.2, U6.3 (VBAT)
GND: C24.2, C25.2, C26.2, C27.1, C28.2, C30.2, C31.2, C32.2, C33.2, C34.2, C35.2, C36.2, C38.2, C40.2, C41.2, C42.2, J6.5, Q3.2 (S), Q5.2 (S), R22.1, R26.1, R28.1, R31.1, R38.2, R41.2, R43.2, R44.1, R46.1, SW3.1, U5.1 (GND), U6.2 (VSS), U7.5 (GND), U8.3 (S2); also elsewhere on the board
MCU_BOOST_EN: U7.7 (EN); also elsewhere on the board
MCU_PWR_BTN: D11.2; also elsewhere on the board
MCU_PWR_CTRL: D12.K; also elsewhere on the board
unnamed: C33.1, R25.1
unnamed: D11.3, SW3.2
unnamed: D12.A, R33.2
unnamed: LED1.1 (K), R24.2
unnamed: C37.2, D11.1, Q3.3 (D), Q4.1, R30.1
unnamed: C38.1, Q3.1 (G), R32.2, R33.1
unnamed: Q5.3 (D), R45.1
unnamed: R40.2, R41.1
unnamed: R22.2, U6.5 (PROG)
unnamed: R24.1, U6.1 (STAT)
unnamed: C29.1, U7.10 (BOOT)
unnamed: R25.2, U7.4 (COMP)
unnamed: R27.1, R28.2, U7.3 (FB)
unnamed: R23.1, U7.1 (FSW)
unnamed: R26.2, U7.8 (ILIM)
unnamed: C31.1, U7.2 (VCC)
unnamed: U8.5 (D), U8.6 (D), U8.7 (D), U8.8 (D)
unnamed: R36.1, U8.2 (G1), U9.3 (Dout)
unnamed: R45.2, R46.2, U8.4 (G2), U9.2 (Cout)
unnamed: R35.1, U8.1 (S1)
unnamed: C39.1, R34.1, U9.5 (BAT)
unnamed: R44.2, U9.6 (V-)
VBAT_MONITOR: C40.1, R37.2, R38.1; also elsewhere on the board
VMOTOR_MONITOR: C41.1, R39.2, R40.1; also elsewhere on the board
VMotor: J6.3, R29.1, R39.1; also elsewhere on the board
VUSB_MONITOR: C42.1, R42.1, R43.1; also elsewhere on the board
V_USB: C27.2, J6.1, LED1.2 (A), R42.2, U6.4 (VDD); also elsewhere on the board
Vbat: C24.1, J6.2, Q4.3, R21.2, R37.1, U5.3 (VI)

Notes on the sheet:
Step up boost converter
3v3 LDO
Battery Protection circuit
V_OUT
LED Vf = 2.0V 5mA = 5-2/R -> R = 600 600R -> 620R
Enables working with batteries of non-standard voltage range
Hold button to power circuit on, then NMOS keeps circuit ON
Boost from VBat -> 10V 0R jumper resistors can be removed for testing power consumption
Default: ~4.3Amp MAX discharge current Alternative: Increase 0R resistor to lower MAX discharge current
Battery connector with slots. Adjust to suit batteries of length 65 -> 67mm
Power switch
65mm battery: NO internal protection 67mm battery: WITH internal protection
Bypass battery protection
Voltage test pads
Battery connector
Pull up to 3v3 as MCU reset shouldn't power OFF circuit Diode prevents MCU in RESET from fully pulling gate to 0V
Common voltages
R1 = 787kR R2 = 107kR V_REF = 1.212V V_OUT = 10.2V
10V -> 1.65V ADC in
Voltage monitoring
3.3->4.2V VBat -> 1.65->2.6V ADC in
5V -> 3.2V - allow ability to detect this with digital pin on MCU
tau = RxC tau = 1 second
Battery charge IC
Button ON time
2 battery clip connectors Option: BT2 component has slots to accomodate: - battery of length ~65mm,no internal protection OR - battery of length ~67mm, with internal protection
I_REG = 1000 V / 3.3 (kR) I_REG = ~300 mA

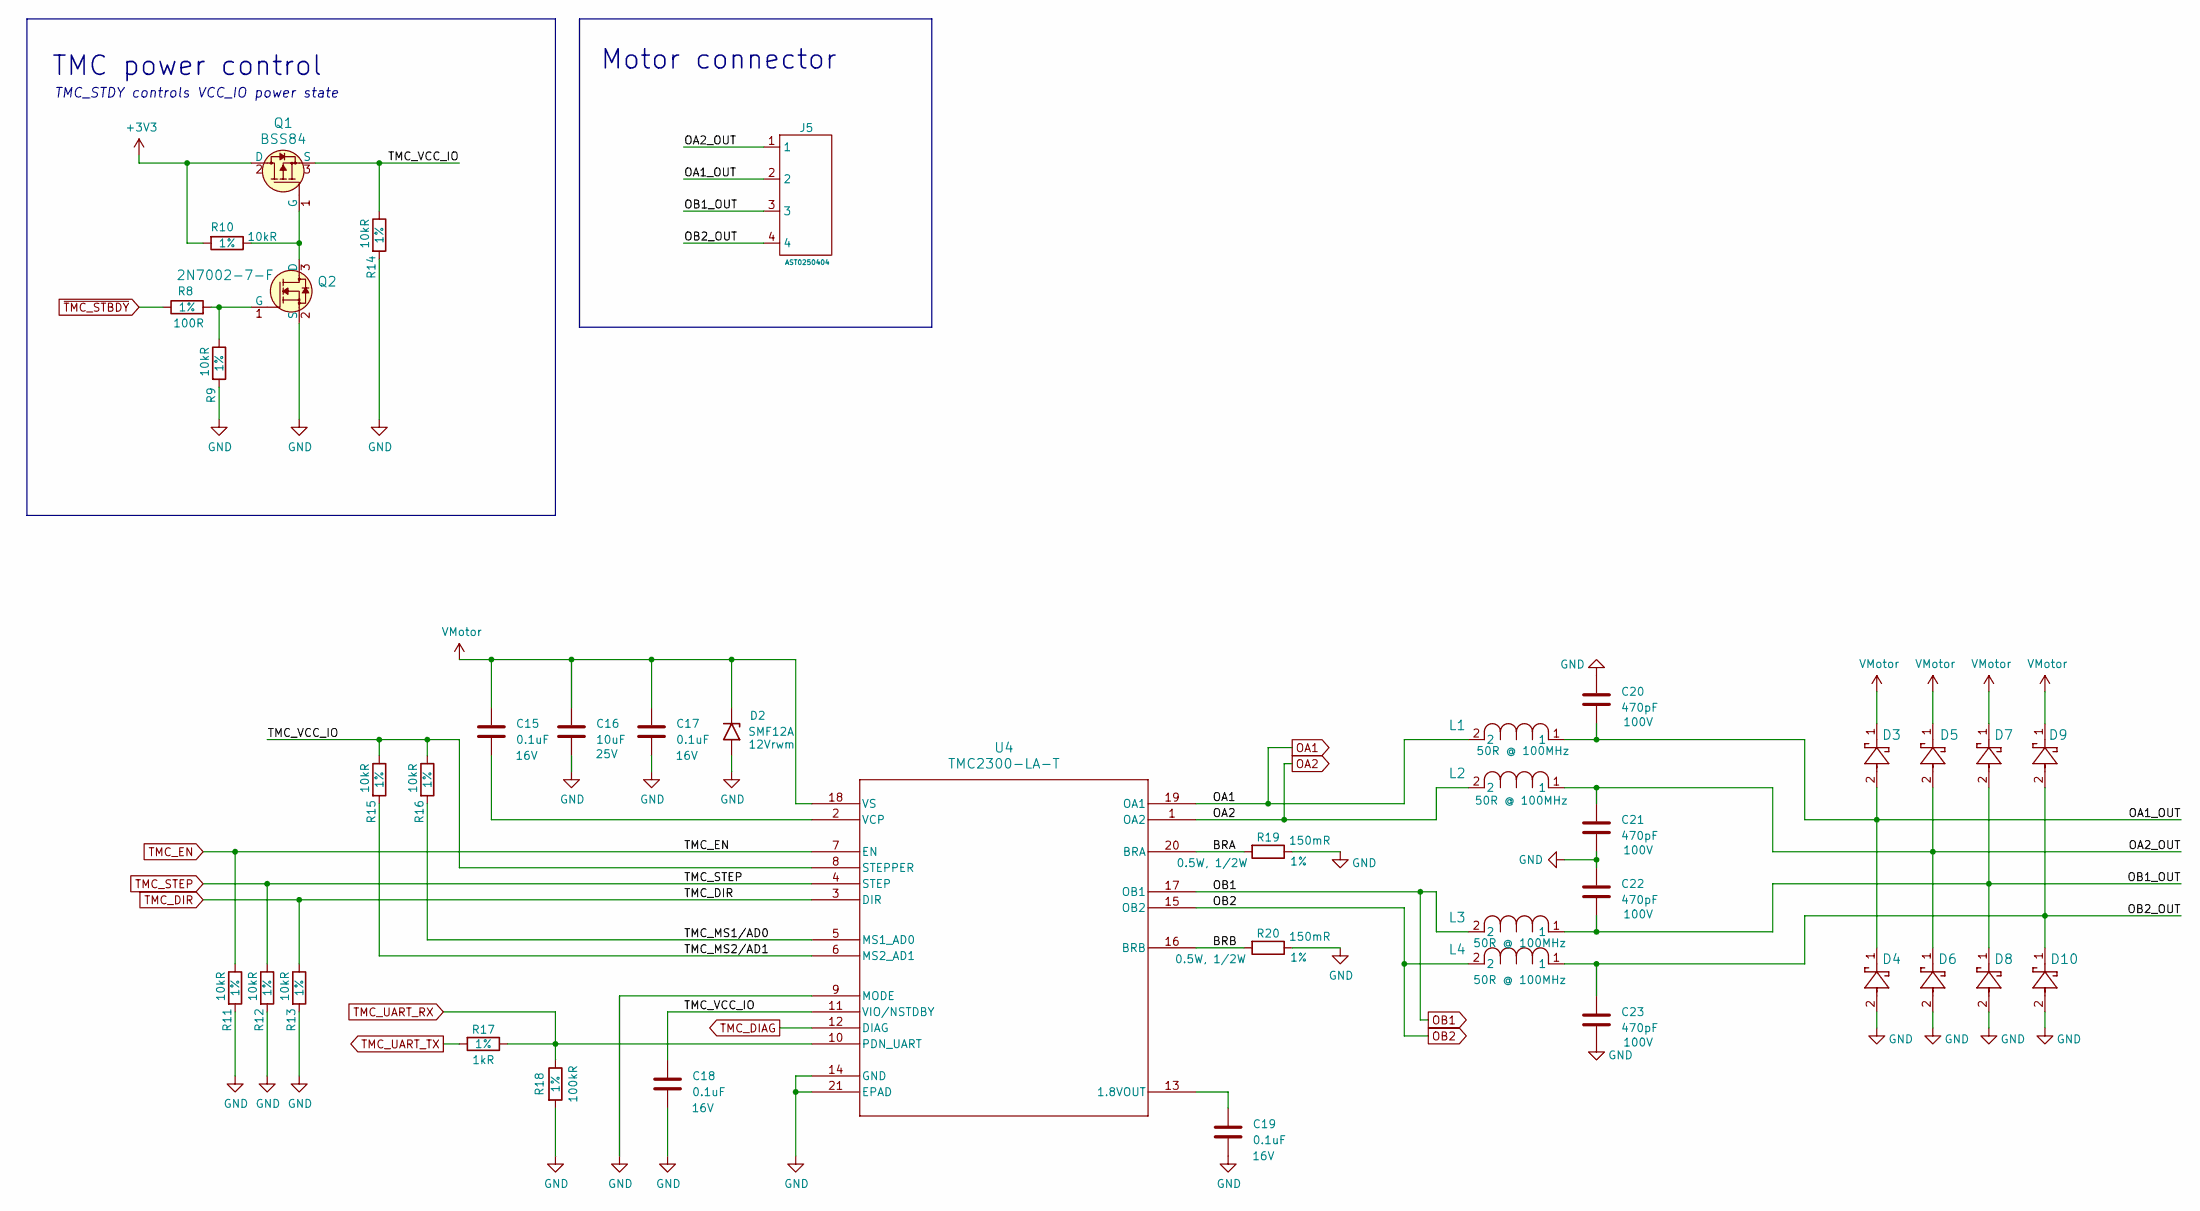
[picture p42: schematic motor_driver.kicad_sch, Motor Driver]

Parts:
C15, C17, C18, C19: 0.1uF; C_0402_1005Metric; Voltage 16V; Tolerance 10%; MPN GRM155R61C104KA88D
C16: 10uF; C_0603_1608Metric; Voltage 25V; Tolerance 10%; MPN GRM188R61E106KA73D
C20, C21, C22, C23: 470pF; C_0402_1005Metric; Voltage 100V; Tolerance 10%; MPN CC0402KRX7R0BB471
D2: SMF12A; D_SMF; MPN SMF12A-M3-08
D3, D4, D5, D6, D7, D8, D9, D10: B5819W-TP; SDO_SOD-123_MCC; MPN B5819W-TP
J5: AST0250404; AST250404; MPN AST0250404
L1, L2, L3, L4: HI1206T500R-10; IND_HI1206T500R-10_LRD; MPN HI1206T500R-10
Q1: BSS84; SOT-23-3; MPN BSS84; Digi-Key_PN BSS84CT-ND
Q2: 2N7002-7-F; SOT-23-3; MPN 2N7002-7-F; Digi-Key_PN 2N7002-FDICT-ND
R8: 100R; R_0603_1608Metric; Tolerance 1%; MPN RC0603FR-07100RL
R9, R10, R11, R12, R13, R14, R15, R16: 10kR; R_0603_1608Metric; Tolerance 1%; MPN RC0603FR-0710KL
R17: 1kR; R_0603_1608Metric; Tolerance 1%; MPN RC0603FR-071KL
R18: 100kR; R_0603_1608Metric; Tolerance 1%; MPN RC0603FR-07100KL
R19, R20: 150mR; R_1206_3216Metric; Tolerance 1%; MPN CRL1206-FW-R150ELF
U4: TMC2300-LA-T; QFN20_3x3_TRI-M; MPN TMC2300-LA-T

Connections:
+3V3: Q1.2 (D), R10.2; also elsewhere on the board
/Motor Driver/BRA: R19.2, U4.20 (BRA)
/Motor Driver/BRB: R20.2, U4.16 (BRB)
/Motor Driver/OA1_OUT: C20.2, D3.2, D4.1, J5.2, L1.1
/Motor Driver/OA2_OUT: C21.1, D5.2, D6.1, J5.1, L2.1
/Motor Driver/OB1_OUT: C22.2, D7.2, D8.1, J5.3, L3.1
/Motor Driver/OB2_OUT: C23.1, D9.2, D10.1, J5.4, L4.1
/Motor Driver/TMC_MS1/AD0: R16.2, U4.5 (MS1_AD0)
/Motor Driver/TMC_MS2/AD1: R15.2, U4.6 (MS2_AD1)
/Motor Driver/TMC_VCC_IO: C18.1, Q1.3 (S), R14.1, R15.1, R16.1, U4.8 (STEPPER), U4.11 (VIO/NSTDBY)
GND: C16.2, C17.2, C18.2, C19.2, C20.1, C21.2, C22.1, C23.2, D2.2 (A2), D4.2, D6.2, D8.2, D10.2, Q2.2 (S), R9.2, R11.2, R12.2, R13.2, R14.2, R18.2, R19.1, R20.1, U4.9 (MODE), U4.14 (GND), U4.21 (EPAD); also elsewhere on the board
unnamed: Q1.1 (G), Q2.3 (D), R10.1
unnamed: Q2.1 (G), R8.2, R9.1
unnamed: C19.1, U4.13 (1.8VOUT)
unnamed: C15.2, U4.2 (VCP)
OA1: L1.2, U4.19 (OA1)
OA2: L2.2, U4.1 (OA2)
OB1: L3.2, U4.17 (OB1)
OB2: L4.2, U4.15 (OB2)
TMC_DIAG: U4.12 (DIAG); also elsewhere on the board
TMC_DIR: R13.1, U4.3 (DIR); also elsewhere on the board
TMC_EN: R11.1, U4.7 (EN); also elsewhere on the board
TMC_STEP: R12.1, U4.4 (STEP); also elsewhere on the board
TMC_UART_RX: R17.1, R18.1, U4.10 (PDN_UART); also elsewhere on the board
TMC_UART_TX: R17.2; also elsewhere on the board
VMotor: C15.1, C16.1, C17.1, D2.1 (A1), D3.1, D5.1, D7.1, D9.1, U4.18 (VS); also elsewhere on the board
~TMC_STBDY: R8.1; also elsewhere on the board

Notes on the sheet:
TMC_STDY controls VCC_IO power state
TMC power control
Motor connector
