SJFOM/KiCad/Projects/StepUp/StepUp.kicad_pcb

## KiCad design Projects/StepUp/StepUp.kicad_pcb (continued)

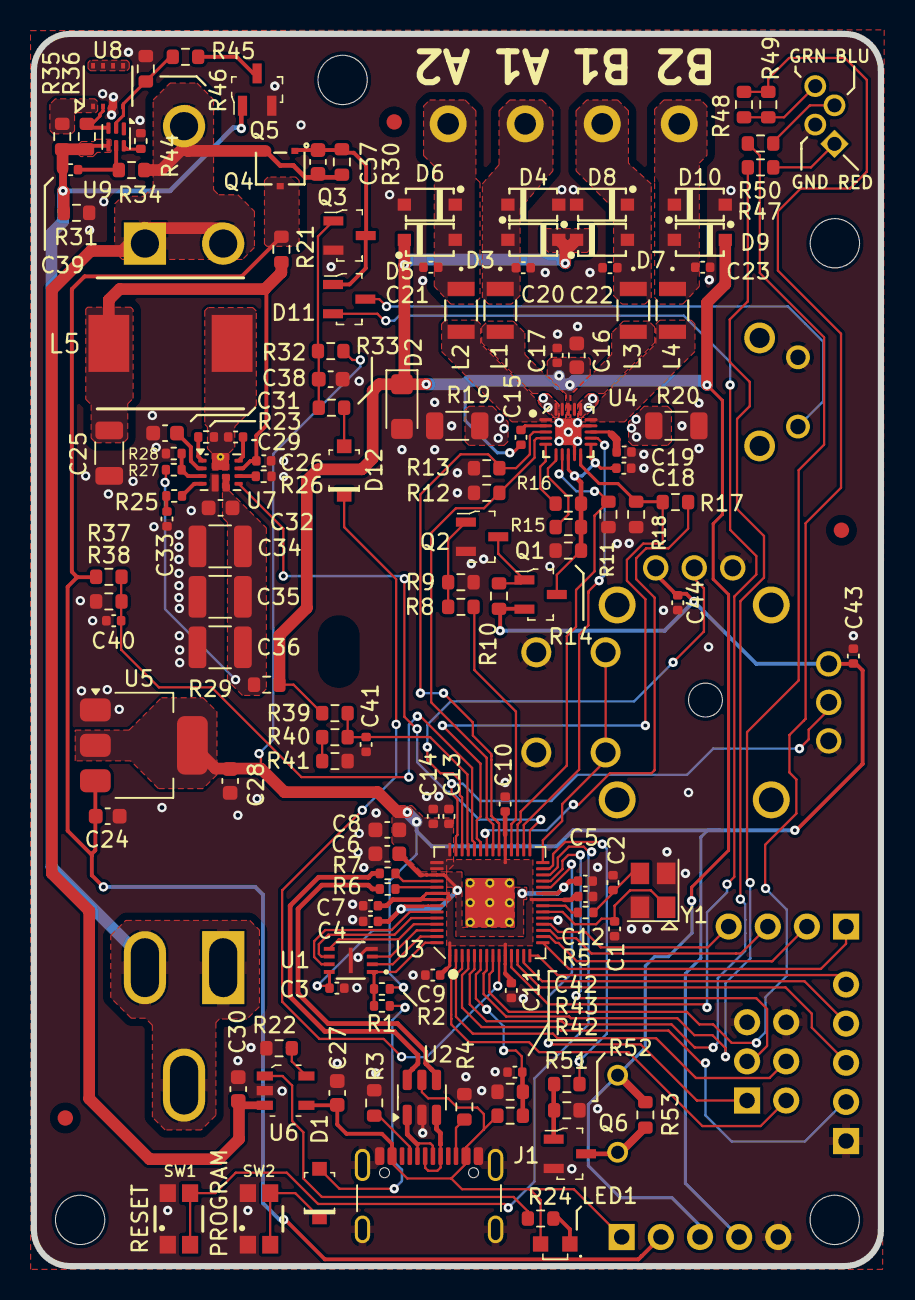
[picture p43: board StepUp.kicad_pcb from above]

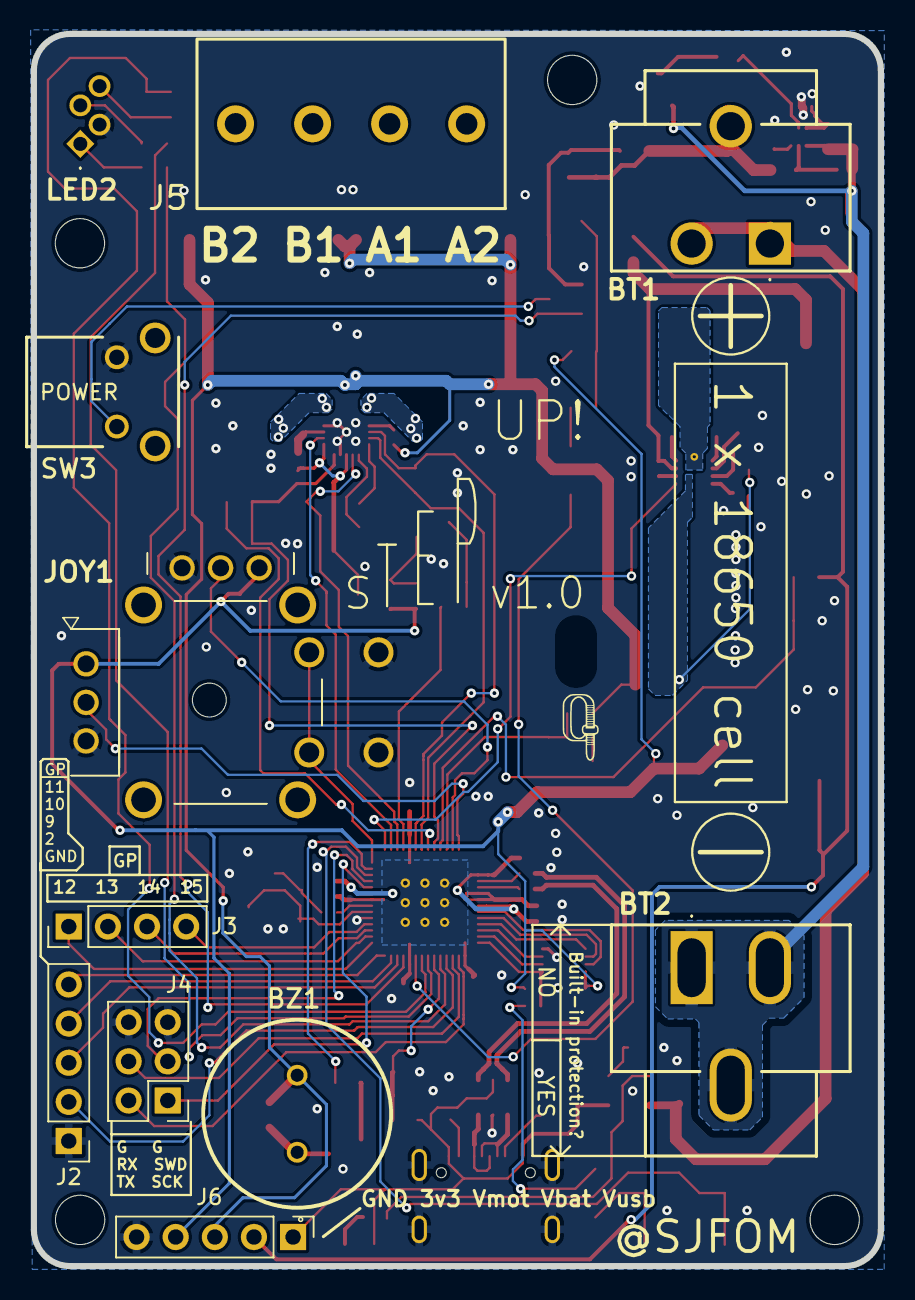
[picture p44: board StepUp.kicad_pcb from below]

Board: 4 copper layers, 55.0 x 80.0 mm, 155 parts (12 on the bottom side), 107 nets.

Other parts of the board:
LOGO1: Zip-tie; LOGO
