SJFOM/KiCad/Projects/RP2040-VGA/pico_vga_sd_aud.kicad_pcb

## KiCad design Projects/RP2040-VGA/pico_vga_sd_aud.kicad_pcb (2024-04-25)


Board: 4 copper layers, 85.0 x 56.0 mm, 71 parts (0 on the bottom side), 59 nets.

Parts:
C1, C2: 1u; C_0603_1608Metric
C3, C10, C16, C19: 10u; C_0603_1608Metric
C4, C5, C6, C7, C8, C12, C13: 100n; C_0402_1005Metric
C9, C11: 2.2u; C_0603_1608Metric
C14, C15, C21: 47u; C_0805_2012Metric
C17, C18: 2.2n; C_0402_1005Metric
D1: MBR120; MBR120_SOD-123
H1, H2, H3, H4: MountingHole; MountingHole_2.7mm_M2.5
J1, J2: AudioJack3; CUI_SJ-3523-audio-jack
J3: Micro_SD_Card; microSD_HC_Molex_104031-0811
J4: L77HDE15SD1CH4F; DSUB-15-L77HDE15SD1CH4F
J5: USB_B_Micro; USB_Micro-B_Amphenol_10103594-0001LF_Horizontal_modified
J6: Conn_01x02; PinHeader_1x02_P2.54mm_Vertical
J7: Conn_02x03_Odd_Even; PinHeader_2x04_P2.54mm_Vertical
R1, R2: 220; R_0402_1005Metric
R3, R4: 100; R_0402_1005Metric
R5, R6: 470; R_0402_1005Metric
R7, R8: 1.8K; R_0402_1005Metric
R9: DNF; R_0402_1005Metric
R10, R11: 47; R_0402_1005Metric
R20, R21, R22, R27, R32, R37: 1k; R_0402_1005Metric
R23, R24: 10k; R_0402_1005Metric
R26, R31, R36: 499; R_0402_1005Metric
R28, R33, R38: 2k; R_0402_1005Metric
R29, R34, R39: 4.02k; R_0402_1005Metric
R30, R35, R40: 8.06k; R_0402_1005Metric
SW1, SW2, SW3, SW4: SW_Push; SW_Push_1P1T_NO_Vertical_Wuerth_434133025816
U1: TLV70033_SOT23-5; SOT-23-5
U2: Pico; RPi_Pico_SMD_TH
U3: NC7WZ16P6X; SOT-363_SC-70-6
U4: PCM5101A; TSSOP-20_4.4x6.5mm_P0.65mm

Connections:
+3.3VA: C2.1, C3.1, C4.1, C5.1, C6.1, C10.1, U1.5, U3.5, U4.1, U4.8
+3V3: C12.1, C16.1, C19.1, J3.4, R23.2, R24.2, SW2.1, SW3.1, SW4.1, U2.36, U4.17, U4.20
+5V: C21.2, D1.2, J5.1, J6.2
/GPIO0: R20.1, R30.2, U2.1
/GPIO1: R29.2, U2.2
/GPIO2: R28.2, U2.4
/GPIO3: R27.2, U2.5
/GPIO4: R26.2, U2.6
/GPIO5: J3.5, R9.2, U2.7
/GPIO6: R21.1, R35.2, U2.9
/GPIO7: R34.2, U2.10
/GPIO8: R33.2, U2.11
/GPIO9: R32.2, U2.12
/GPIO10: R31.2, U2.14
/GPIO11: R22.1, R40.2, U2.15
/GPIO12: R39.2, U2.16
/GPIO13: R38.2, U2.17
/GPIO14: R37.2, U2.19
/GPIO15: R36.2, U2.20
/GPIO16: R11.2, U2.21
/GPIO17: R10.2, U2.22
/GPIO18: J3.3, U2.24
/GPIO19: J3.7, U2.25
/GPIO20: J7.3, U2.26
/GPIO21: J7.1, U2.27
/GPIO22: J3.2, U2.29
/GPIO26: U2.31, U4.14
/GPIO27: U2.32, U3.3, U4.13
/GPIO28: U2.34, U3.1, U4.15
/HSYNC: J4.13, R11.1
/PCM_AUDIO_L: C18.1, J1.2, R5.1
/PCM_AUDIO_R: C17.1, J1.3, R6.1
/PCM_L: R5.2, U4.6
/PCM_R: R6.2, U4.7
/PWM_AUDIO_L: C14.1, J2.2, R7.2
/PWM_AUDIO_R: C15.1, J2.3, R8.2
/PWM_L: R1.2, U3.6
/PWM_LL: C7.1, C14.2, R1.1, R3.2
/PWM_R: R2.2, U3.4
/PWM_RR: C8.1, C15.2, R2.1, R4.2
/RUN: SW1.1, U2.30
/SD_DAT1: J3.8, J7.4, R24.1
/SD_DAT2: J3.1, J7.2, R23.1
/SWCLK: J7.6, U2.41
/SWDIO: J7.5, U2.43
/VGA_B: J4.3, R36.1, R37.1, R38.1, R39.1, R40.1
/VGA_G: J4.2, R31.1, R32.1, R33.1, R34.1, R35.1
/VGA_R: J4.1, R26.1, R27.1, R28.1, R29.1, R30.1
/VSYNC: J4.14, R10.1
/VSYS: C1.1, D1.1, U1.1, U1.3, U2.39
GND: C1.2, C2.2, C3.2, C4.2, C5.2, C6.2, C7.2, C8.2, C9.2, C10.2, C12.2, C13.2, C16.2, C17.2, C18.2, C19.2, C21.1, J1.1, J2.1, J3.6, J3.11, J4.0, J4.5, J4.6, J4.7, J4.8, J4.10, J5.5, J5.6, J7.7, J7.8, R3.1, R4.1, R7.1, R8.1, R9.1, SW1.2, U1.2, U2.3, U2.8, U2.13, U2.18, U2.23, U2.28, U2.33, U2.38, U2.42, U3.2, U4.3, U4.9, U4.10, U4.11, U4.12, U4.16, U4.19
unnamed: C9.1, U4.5
unnamed: C11.1, U4.2
unnamed: C11.2, U4.4
unnamed: C13.1, U4.18
unnamed: R20.2, SW2.2
unnamed: R21.2, SW3.2
unnamed: R22.2, SW4.2
VBUS: J6.1, U2.40
