SJFOM/KiCad/(commit log)

2024-01-21 feat(kicad): First push of local files
    [StepUp.kicad_pcb, StepUp.kicad_sch, microcontroller.kicad_sch, motor_control.kicad_sch, motor_driver.kicad_sch, power.kicad_sch]
2024-01-21 feat(setup): KiCad symbolic link setup
2024-03-11 feat(v8): Update to KiCAD v8, added boost converter
    [StepUp.kicad_pcb, StepUp.kicad_sch, microcontroller.kicad_sch, motor_control.kicad_sch, motor_driver.kicad_sch, power.kicad_sch]
2024-03-16 feat(rp2040): Layout begins, extra libraries
    RPico minimal project downloaded + assets copied. Boost converter layout
    in progress, 18650 battery holder added.
    [RP2040_minimal_r2-BOM.xlsx, RP2040_minimal_r2.kicad_pcb, RP2040_minimal_r2.kicad_sch, StepUp.kicad_pcb, StepUp.kicad_sch, microcontroller.kicad_sch, motor_driver.kicad_sch, power.kicad_sch]
2024-03-17 feat(joystick): Added part
    [StepUp.kicad_pcb, StepUp.kicad_sch, power.kicad_sch, user_input.kicad_sch]
2024-03-19 feat(charge): Charge IC, USB ESD, sheet sections
    [StepUp.kicad_pcb, power.kicad_sch, user_input.kicad_sch]
2024-03-20 feat(power): Input stage updates
    USB vs Vbat source selection using PMOS gate logic.
    [StepUp.kicad_pcb, microcontroller.kicad_sch, motor_driver.kicad_sch, power.kicad_sch, user_input.kicad_sch]
2024-04-25 feat(stepup): Many additions
    [StepUp.kicad_pcb, StepUp.kicad_sch, leds.kicad_sch, microcontroller.kicad_sch, pico_vga_sd_aud.kicad_pcb, pico_vga_sd_aud.sch, pico_vga_sd_aud_BOM_r2.xlsx, power.kicad_sch]
2024-04-27 feat(stepup): Schematic + PCB updates
    [StepUp-B_Cu.gbr, StepUp-B_Mask.gbr, StepUp-B_Paste.gbr, StepUp-B_SilkS.gbr, StepUp-Edge_Cuts.gbr, StepUp-F_Cu.gbr, StepUp-F_Mask.gbr, StepUp-F_Paste.gbr]
2024-04-28 feat(schematic): Ready for layout
    [StepUp.kicad_pcb, StepUp.kicad_sch, leds.kicad_sch, microcontroller.kicad_sch, motor_driver.kicad_sch, power.kicad_sch, user_input.kicad_sch]
2024-04-29 chore(pins): MCU_BOOST_EN to MCU, fixed errors
    [StepUp.kicad_pcb, microcontroller.kicad_sch, motor_driver.kicad_sch, power.kicad_sch, user_input.kicad_sch]
2024-04-29 test(yml): Generate kicad files
2024-05-06 feat(layout): Blocks organised
    [StepUp.kicad_pcb, StepUp.kicad_sch, microcontroller.kicad_sch, motor_driver.kicad_sch, power.kicad_sch, user_input.kicad_sch]
2024-05-07 feat(tidy): Bigger PMOS, added footprints
    [StepUp.kicad_pcb, StepUp.kicad_sch, indicators.kicad_sch, microcontroller.kicad_sch, motor_driver.kicad_sch, power.kicad_sch, user_input.kicad_sch]
2024-05-12 feat(layout): TMC & Boost layout begin
    [StepUp.kicad_pcb, indicators.kicad_sch, microcontroller.kicad_sch, motor_driver.kicad_sch, power.kicad_sch, user_input.kicad_sch]
2024-05-27 feat(layout): DRC ongoing, layout nearly complete
    [StepUp-B_Cu.gbr, StepUp-B_Mask.gbr, StepUp-B_Paste.gbr, StepUp-B_SilkS.gbr, StepUp-B_Silks.gbr, StepUp-Edge_Cuts.gbr, StepUp-Edge_Cuts.gm1, StepUp-F_Cu.gbr]
2024-05-30 feat(StepUp): Release v0.1
    [StepUp-B_Cu.gbr, StepUp-B_Mask.gbr, StepUp-B_Paste.gbr, StepUp-B_SilkS.gbr, StepUp-B_Silks.gbr, StepUp-Edge_Cuts.gbr, StepUp-Edge_Cuts.gm1, StepUp-F_Cu.gbr]
2024-05-30 feat(outputs): Added STEP file & schematic output
    [StepUp.kicad_pcb, indicators.kicad_sch, microcontroller.kicad_sch, motor_driver.kicad_sch, user_input.kicad_sch]
2024-06-02 feat(BoM): Updating PN's
    [StepUp.kicad_pcb, microcontroller.kicad_sch, motor_driver.kicad_sch, power.kicad_sch]
2024-06-04 chore(bom): Update from PCB BoM
    [StepUp.kicad_pcb, indicators.kicad_sch, microcontroller.kicad_sch, motor_driver.kicad_sch, power.kicad_sch, update1-T-1F8W770101A-2sets-StepUp_v0.1(2024-06-03).xls, user_input.kicad_sch]
2024-06-17 chore(d12): Update diode silkscreen
    [StepUp.kicad_pcb]
2024-10-28 feat(v0.2): Schematic updated, PCB layout start
    [StepUp.kicad_pcb, StepUp.kicad_sch, indicators.kicad_sch, microcontroller.kicad_sch, motor_driver.kicad_sch, power.kicad_sch, user_input.kicad_sch]
2024-10-28 feat(v0.2): Rough layout begins
    [StepUp-B_Cu.gbr, StepUp-B_Mask.gbr, StepUp-B_Paste.gbp, StepUp-B_Paste.gbr, StepUp-B_Silks.gbr, StepUp-Edge_Cuts.gbr, StepUp-Edge_Cuts.gm1, StepUp-F_Cu.gbr]
2024-11-17 feat(cad): CAD dims pushed to PCB
    [StepUp.kicad_pcb, motor_driver.kicad_sch]
2024-11-24 feat(v0.2): Component layout from CAD
    [StepUp.kicad_pcb, StepUp.kicad_sch, indicators.kicad_sch, microcontroller.kicad_sch, motor_driver.kicad_sch, power.kicad_sch, user_input.kicad_sch]
2024-11-25 feat(layout): Layout begins
    [StepUp.kicad_pcb, motor_driver.kicad_sch, power.kicad_sch, user_input.kicad_sch]
2024-11-27 feat(layout): Most traces complete
    [StepUp.kicad_pcb, power.kicad_sch]
2024-12-07 feat(v0.2): Release, PCBs ordered!
    [StepUp-B_Cu.gbr, StepUp-B_Mask.gbr, StepUp-B_Paste.gbp, StepUp-B_Paste.gbr, StepUp-B_Silks.gbr, StepUp-Edge_Cuts.gbr, StepUp-Edge_Cuts.gm1, StepUp-F_Cu.gbr]
2025-02-22 feat(v0.3): Begin work on next rev
    [StepUp.kicad_pcb, StepUp.kicad_sch, indicators.kicad_sch, microcontroller.kicad_sch, motor_driver.kicad_sch, power.kicad_sch, user_input.kicad_sch]
2025-02-22 feat(v0.3): Boost layout complete
    [StepUp.kicad_pcb, indicators.kicad_sch, microcontroller.kicad_sch, motor_driver.kicad_sch, power.kicad_sch, user_input.kicad_sch]
2025-02-23 feat(v0.3): Layout 90% complete
    [StepUp.kicad_pcb, indicators.kicad_sch, microcontroller.kicad_sch, motor_driver.kicad_sch, power.kicad_sch, user_input.kicad_sch]
2025-02-27 feat(v0.3): Files sent to PCBWay for build
    [StepUp-B_Courtyard.gbr, StepUp-BottomLayer_Mask_Mask.gbs, StepUp-BottomLayer_Paste_Paste.gbp, StepUp-BottomLayer_Silk_Silkscreen.gbo, StepUp-Edge_Cuts.gm1, StepUp-F_Courtyard.gbr, StepUp-L1_TopLayer_Cu.gtl, StepUp-L4_BottomLayer_Cu.gbl]
2025-03-03 feat(v0.3): Minor updates for PCBWay order
    [StepUp-B_Courtyard.gbr, StepUp-BottomLayer_Mask_Mask.gbs, StepUp-BottomLayer_Paste_Paste.gbp, StepUp-BottomLayer_Silk_Silkscreen.gbo, StepUp-Edge_Cuts.gm1, StepUp-F_Courtyard.gbr, StepUp-L1_TopLayer_Cu.gtl, StepUp-L4_BottomLayer_Cu.gbl]
2025-03-03 chore(date): Update date for sch & PCB
    [StepUp.kicad_pcb, StepUp.kicad_sch, indicators.kicad_sch, microcontroller.kicad_sch, motor_driver.kicad_sch, power.kicad_sch, user_input.kicad_sch]
2026-03-26 chore(3d): 3D model file path update
    [StepUp-B_Courtyard.gbr, StepUp-BottomLayer_Mask_Mask.gbs, StepUp-BottomLayer_Paste_Paste.gbp, StepUp-BottomLayer_Silk_Silkscreen.gbo, StepUp-Edge_Cuts.gm1, StepUp-F_Courtyard.gbr, StepUp-L1_TopLayer_Cu.gtl, StepUp-L4_BottomLayer_Cu.gbl]
2026-03-27 feat(v0.4): Work in Progress
    [StepUp-B_Courtyard.gbr, StepUp-BottomLayer_Mask_Mask.gbs, StepUp-BottomLayer_Paste_Paste.gbp, StepUp-BottomLayer_Silk_Silkscreen.gbo, StepUp-Edge_Cuts.gm1, StepUp-F_Courtyard.gbr, StepUp-L1_TopLayer_Cu.gtl, StepUp-L4_BottomLayer_Cu.gbl]
2026-03-30 chore(unused): Remove unused files/folders
    [StepUp-B_Cu.gbr, StepUp-B_Mask.gbr, StepUp-B_Paste.gbp, StepUp-B_Paste.gbr, StepUp-B_Silks.gbr, StepUp-Edge_Cuts.gbr, StepUp-Edge_Cuts.gm1, StepUp-F_Cu.gbr]
2026-03-30 feat(v1.0): Migrate v0.4 to v1.0
    [StepUp-B_Courtyard.gbr, StepUp-BottomLayer_Mask_Mask.gbs, StepUp-BottomLayer_Paste_Paste.gbp, StepUp-BottomLayer_Silk_Silkscreen.gbo, StepUp-Edge_Cuts.gm1, StepUp-F_Courtyard.gbr, StepUp-L1_TopLayer_Cu.gtl, StepUp-L4_BottomLayer_Cu.gbl]
